LoupHC/controleur-CAPE/Images/Tiempoints_temp.png

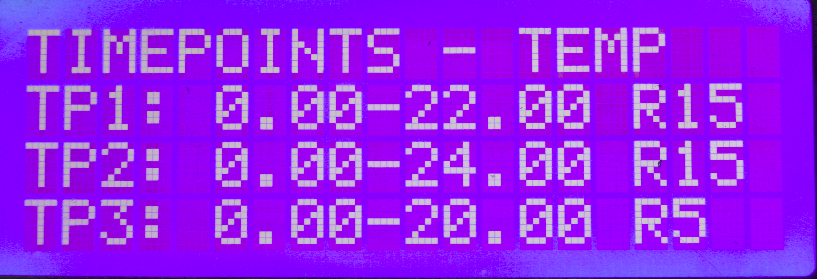
Images/Tiempoints_temp.png
