LoupHC/controleur-CAPE/Images/Enter_parameter1.png

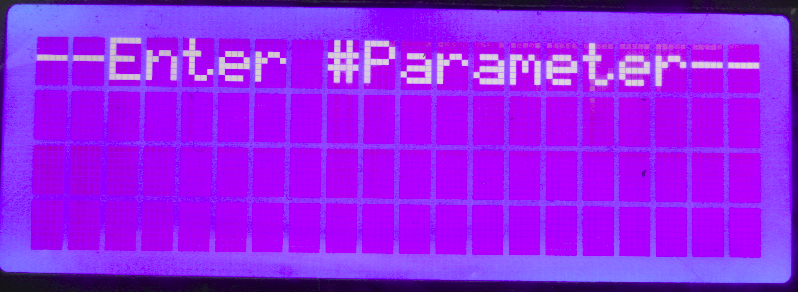
Images/Enter_parameter1.png
