LoupHC/controleur-CAPE/README.md

# l'Otomate
Voici l'**Otomate**, un outil développé par et pour les membres de la CAPÉ (Coopérative pour l'agriculture de proximité écologique) pour permettre aux petites, moyennes et grosses fermes d'automatiser leurs serres à une fraction du coût du marché.

Il dispose de fonctionalités permettant :
- de définir jusqu'à 5 périodes horaires permettant de faire évoluer la température normale au courant de la journée
- de contrôler l'ouverture et la fermeture de moteurs de côtés ouvrants, avec possibilité d'utiliser un programme distinct pour chaque côté de la serre
- d'actionner un ou deux systèmes de ventilation
- d'actionner une ou deux fournaises

Le programme supporte la sonde de température DS18B20 et le module d'horloge DS3231 pour le moment.

Le code, les schémas, les plans nécessaires à la conception de ce contrôleur sont du domaine public.Le code, les schémas et les plans nécessaires à la conception de ce contrôleur sont certifiés open-source, donc appartiennent au domaine public. Ils peuvent être utilisés, modifiés, hackés, par n'importe qui, pour n'importe quel usage, tant que les termes de la license GPL sont respectés.

Pour des détails quant  l'utilisation du présent code, consultez la section [wiki](https://github.com/LoupHC/controleur-CAPE/wiki).
