LoupHC/controleur-CAPE/Images/Enter_parameter.png

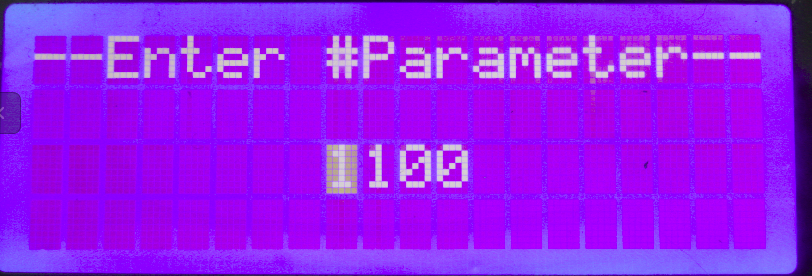
Images/Enter_parameter.png
