LoupHC/controleur-CAPE/Images/Fan.png

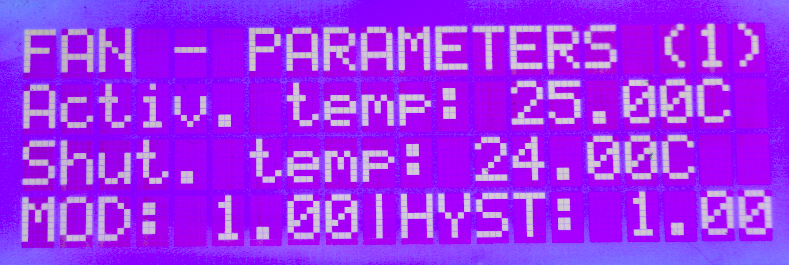
Images/Fan.png
