LoupHC/controleur-CAPE/Images/Global_parameters.png

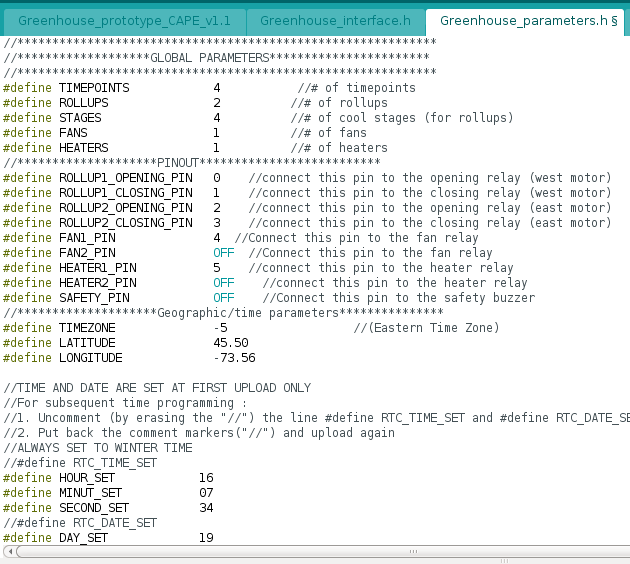
Images/Global_parameters.png
