LoupHC/controleur-CAPE/Images/Heater.png

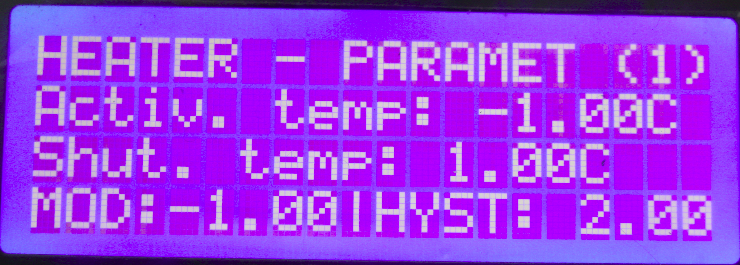
Images/Heater.png
