LoupHC/controleur-CAPE/Images/Home.png

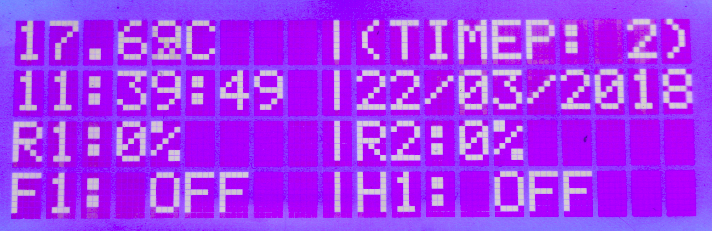
Images/Home.png
