LoupHC/controleur-CAPE/Images/Parameter_selected.png

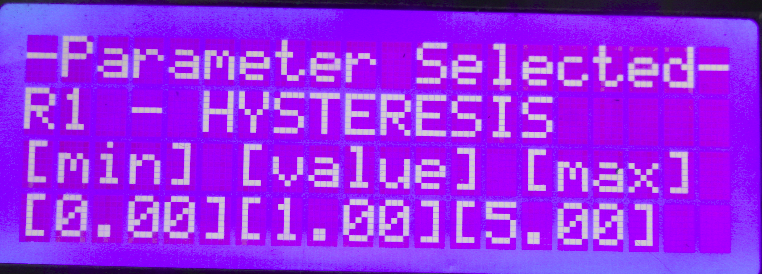
Images/Parameter_selected.png
