LoupHC/controleur-CAPE/Images/Programmation.png

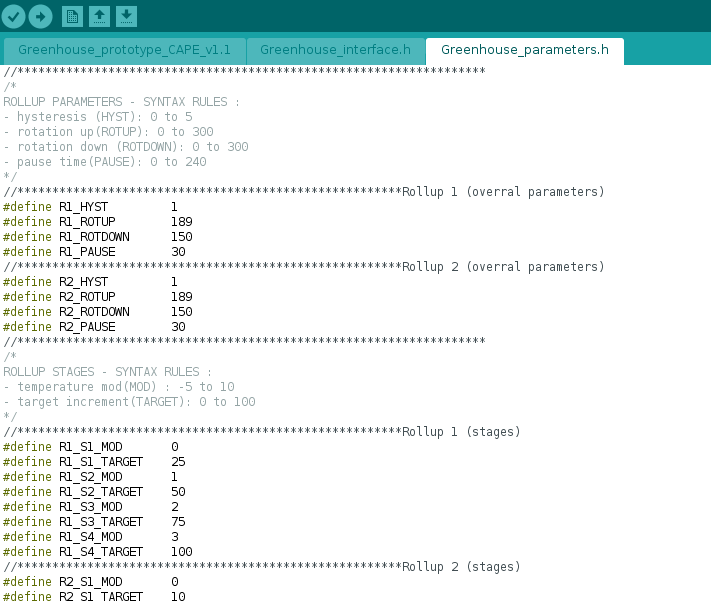
Images/Programmation.png
