LoupHC/controleur-CAPE/Images/Rollup_1.png

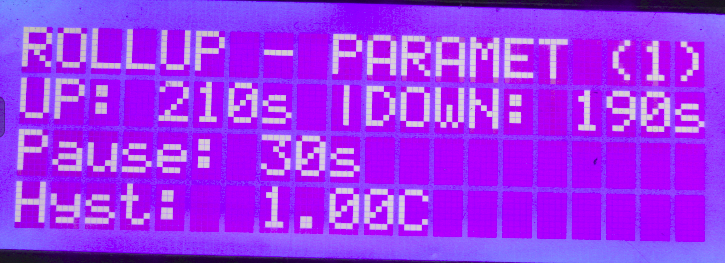
Images/Rollup_1.png
