LoupHC/controleur-CAPE/Images/Rollup_2.png

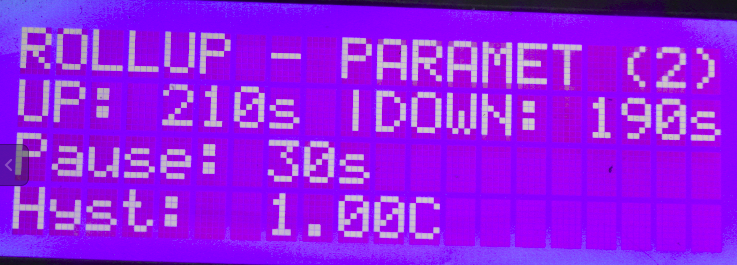
Images/Rollup_2.png
