LoupHC/controleur-CAPE/Images/Stages_1.png

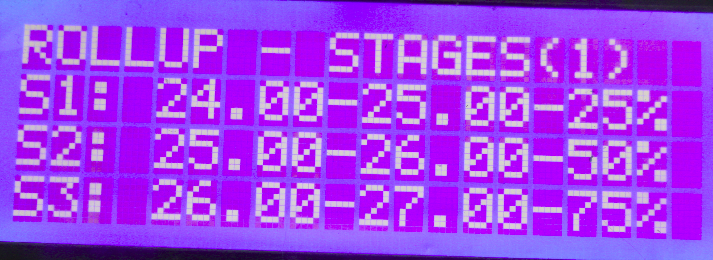
Images/Stages_1.png
