LoupHC/controleur-CAPE/Images/Stages_2.png

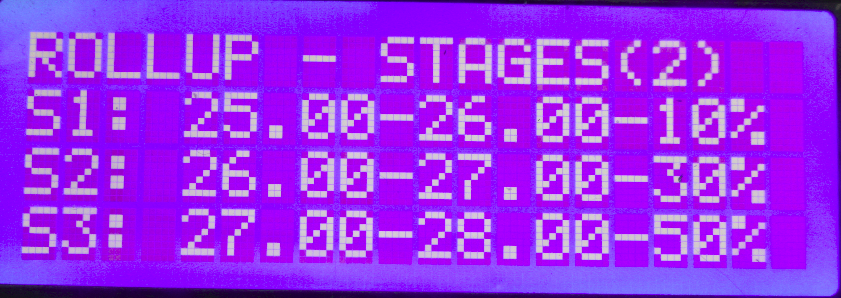
Images/Stages_2.png
