LoupHC/controleur-CAPE/Images/Timepoints_time.png

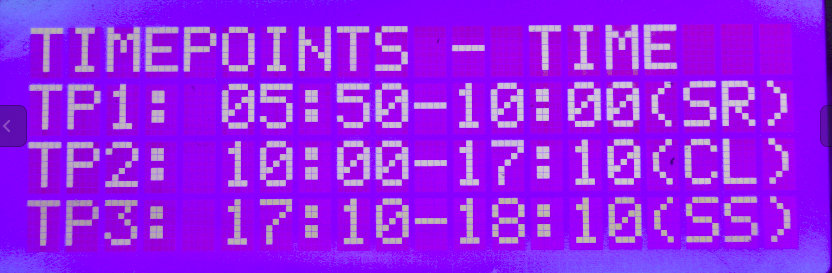
Images/Timepoints_time.png
