LoupHC/controleur-CAPE/KiCad Files/Controller_Schematics_pdf/Alimentation.png

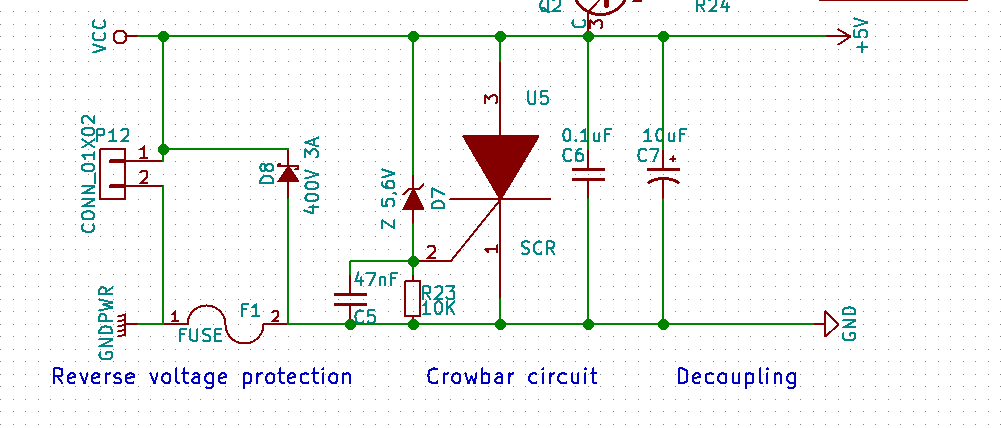
KiCad Files/Controller_Schematics_pdf/Alimentation.png
