LoupHC/controleur-CAPE/KiCad Files/Controller_Schematics_pdf/Relay driver.png

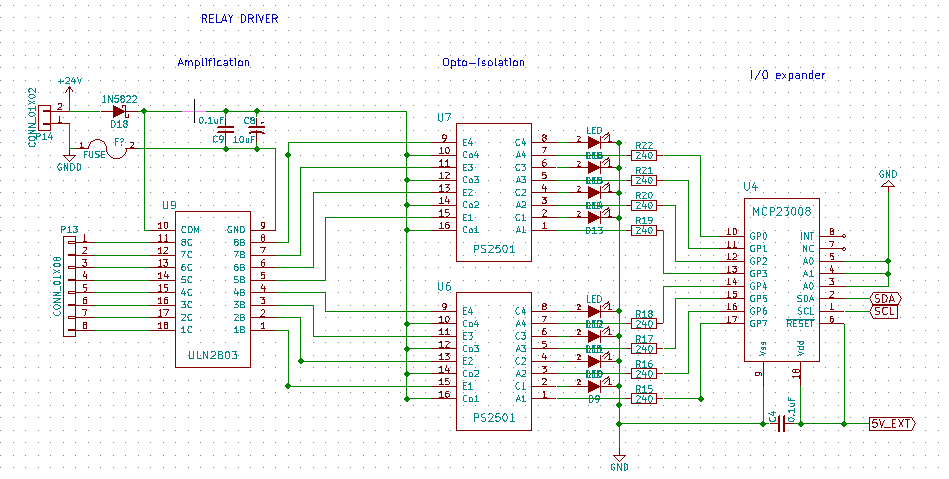
KiCad Files/Controller_Schematics_pdf/Relay driver.png
