LoupHC/controleur-CAPE/(threads)

Thread 3 (2018-01-05):

Quelle librairie de LiquidCrystal_I2C est utilisée?

palexp2, 2018-01-05:
J'ai essayé sans résultats avec les librairies suivantes:

https://github.com/jmparatte/jm_LiquidCrystal_I2C
https://github.com/marcoschwartz/LiquidCrystal_I2C
http://www.archiduino.com/liquidcrystal_i2c-h-library-arduino-ide-1-6-x/
https://github.com/fdebrabander/Arduino-LiquidCrystal-I2C-library

Copie du message d'erreur avec la librairie de archiduino:

```
In file included from /home/pa/Documents/controleur-CAPE/Greenhouse_prototype_CAPE_v1.1/Greenhouse_prototype_CAPE_v1.1.ino:114:0:
Greenhouse_interface.h:8: error: no matching function for call to 'LiquidCrystal_I2C::LiquidCrystal_I2C(int, int, int, int, int, int, int, int)'
 LiquidCrystal_I2C  lcd(I2C_ADDR, 2, 1, 0, 4, 5, 6, 7);
                                                     ^
sketch/Greenhouse_interface.h:8:53: note: candidates are:
In file included from sketch/Greenhouse_interface.h:2:0,
                 from /home/pa/Documents/controleur-CAPE/Greenhouse_prototype_CAPE_v1.1/Greenhouse_prototype_CAPE_v1.1.ino:114:
/home/pa/Arduino/libraries/LiquidCrystal_I2C/LiquidCrystal_I2C.h:58:3: note: LiquidCrystal_I2C::LiquidCrystal_I2C(uint8_t, uint8_t, uint8_t)
   LiquidCrystal_I2C(uint8_t lcd_Addr,uint8_t lcd_cols,uint8_t lcd_rows);
   ^
/home/pa/Arduino/libraries/LiquidCrystal_I2C/LiquidCrystal_I2C.h:58:3: note:   candidate expects 3 arguments, 8 provided
/home/pa/Arduino/libraries/LiquidCrystal_I2C/LiquidCrystal_I2C.h:56:7: note: constexpr LiquidCrystal_I2C::LiquidCrystal_I2C(const LiquidCrystal_I2C&)
 class LiquidCrystal_I2C : public Print {
       ^
/home/pa/Arduino/libraries/LiquidCrystal_I2C/LiquidCrystal_I2C.h:56:7: note:   candidate expects 1 argument, 8 provided
/home/pa/Arduino/libraries/LiquidCrystal_I2C/LiquidCrystal_I2C.h:56:7: note: constexpr LiquidCrystal_I2C::LiquidCrystal_I2C(LiquidCrystal_I2C&&)
/home/pa/Arduino/libraries/LiquidCrystal_I2C/LiquidCrystal_I2C.h:56:7: note:   candidate expects 1 argument, 8 provided
In file included from /home/pa/Documents/controleur-CAPE/Greenhouse_prototype_CAPE_v1.1/Greenhouse_prototype_CAPE_v1.1.ino:114:0:
sketch/Greenhouse_interface.h: In function 'void initLCD(byte, byte)':
Greenhouse_interface.h:30: error: 'class LiquidCrystal_I2C' has no member named 'setBacklightPin'
   lcd.setBacklightPin(BACKLIGHT_PIN, POSITIVE);
       ^
Greenhouse_interface.h:30: error: 'POSITIVE' was not declared in this scope
   lcd.setBacklightPin(BACKLIGHT_PIN, POSITIVE);
                                      ^
In file included from /home/pa/Documents/controleur-CAPE/Greenhouse_prototype_CAPE_v1.1/Greenhouse_prototype_CAPE_v1.1.ino:114:0:
sketch/Greenhouse_interface.h: In function 'void lcdPrintRollups(String, String, String, byte, byte, Rollup, byte*)':
sketch/Greenhouse_interface.h:61:31: warning: invalid conversion from 'const char*' to 'uint8_t {aka unsigned char}' [-fpermissive]
         lcd.write("          ");
                               ^
In file included from sketch/Greenhouse_interface.h:2:0,
                 from /home/pa/Documents/controleur-CAPE/Greenhouse_prototype_CAPE_v1.1/Greenhouse_prototype_CAPE_v1.1.ino:114:
/home/pa/Arduino/libraries/LiquidCrystal_I2C/LiquidCrystal_I2C.h:82:18: note: initializing argument 1 of 'virtual size_t LiquidCrystal_I2C::write(uint8_t)'
   virtual size_t write(uint8_t);
```

palexp2, 2018-01-05:
J'ai toruvé le lien dans le ReadMe dsl.

Closed 2018-01-05.

Thread 10 (2018-01-07):

Tester la chip MCP23008 pour actionner le driver de relais via I2C

LoupHC, 2018-01-07:
Permet de gérer 8 sorties via le canal I2C
Premiers tests effectués : jusqu'à maintenant ça marche!

LoupHC, 2018-01-12:
Prototype fonctionnel de relay driver : ça marche!

Closed 2018-01-12.

Thread 5 (2018-01-07):

Décision relais/alim contrôleur 12V ou 24V

LoupHC, 2018-01-07:
Système avec deux alimentations : une pour les moteurs (24V) et l'autre pour les relais et le contrôleur (12V)
Pour :
- On peut alimenter le Arduino directement via le régulateur de voltage intégré
- les relais 12V sont disponibles chez Addison et chez Abra

Contre :
- implique d'acheter 2 PS ou un module step-down 24V->12V
- questionnements sur les risques de surchauffe su régulateur de voltage

Système fonctionant exclusivement sur le 24V (B)
Pour :
- les relais 24V sont disponibles chez Abra
- Alimentation au Arduino via un buck converter comme celui-ci :
https://www.adafruit.com/product/1065
Meilleur efficacité de conversion, pas de leak current => éventuellement plus efficace sur batterie + chauffe pas

Contre :
- implique d'acheter un step-down pour le arduino

Closed 2018-01-08.

Thread 6 (2018-01-07):

Décision current sensor SM ou sur connecteur

LoupHC, 2018-01-07:
Pour le montage des sondes de courant, ça me gossait que la seule chip existante soit surface mount, mais j'ai trouvé dernièrement ce socket, qui pourrait supprimer le issue de comment remplacer un sensor brisé.
https://www.aliexpress.com/item/SOP16-TO-DIP16-SOP16-turn-DIP16-SOIC16-to-DIP16-IC-socket-Programmer-adapter-Socket-150mil/1107288077.html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,searchweb201602_5_10152_10151_10065_10130_10068_10344_10547_10342_10343_10340_10548_10341_10084_10083_10139_10307_10059_10314_10534_100031_10604_10103_10142,searchweb201603_25,ppcSwitch_5&algo_expid=7ae05777-db5d-442c-b6c0-5fc18b6fb81e-0&algo_pvid=7ae05777-db5d-442c-b6c0-5fc18b6fb81e&priceBeautifyAB=0
La chip s'enlève en appuyant sur les ressorts, comme ça :
https://www.youtube.com/watch?v=XixbJe8b-Qw
L'enjeu c'est qu'il y a aucun datasheet donc j'ai aucune idée des ratings de courant, mais surement que ça le fait pour 1A.
Aucune idée à quel point le contact est solide non plus...
Une autre possibilité c'est de mettre un limiteur de courant avec la chip, genre fusible réarmable, pour éviter de buster les ratings du capteur avec un faux contact.

jayserf, 2018-01-17:
J'ai vu passer le courriel, je l'ai tu repondu?

c'est vraiment pour la programmation et connection temporaire. Je le mettrais pas dans une installation permanente exterieur.
Je crois que perdre un chip et avoir a le dessouder surface mount pour le remplacer est moins une probleme que le socket peut avoir. (meme si les contacts sont en or)

deux questions:
1. est-ce que ca risque reelement de mourrir ce chip? (j'en ai aucune idee)
2. est-ce que si ca brule metons, le courant passe quand meme mais tu n'a juste pas le lecture de courant, ou le moteur sera mort?

LoupHC, 2018-01-17:
Bon, après relecture du datasheet, l'isolation du capteur peut handle jusqu'à 420V de tension DC/des spikes de 2400V, je pense pas que ça soit un risque trop trop.
L'autre risque c'est si le supply voltage excède 6V, avec le crowbar circuit ça devrait empêcher ça d'arriver.
Ok fuck les connecteurs à ressort. Je vais juste apprendre à souder du SM. :)

jayserf, 2018-01-18:
Cool! OK d'accord

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

Closed 2018-01-17.

Thread 8 (2018-01-07):

Décision Relais sur PCB ou rail DIN

LoupHC, 2018-01-07:
Assemblage sur Din rail(relais et contrôleur)
Pour :
- modulaire
- plus facilement hackable
- intérêt pédagogique à faire un peu soi-même son filage
Contre :
- plus de filage à faire à la main

Au niveau matériel, on pourrait utiliser ces racks-là pour les motor driver:
https://www.aliexpress.com/item/UM122-PCB-length-51-100mm-profile-panel-mounting-base-PCB-housing-PCB-din-rail-PCB-carrier/32622345793.html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,searchweb201602_5_10152_10151_10065_10130_10068_10344_10547_10342_10343_10340_10548_10341_10084_10083_10139_10307_10059_10314_10534_100031_10604_10103_10142,searchweb201603_25,ppcSwitch_5&algo_expid=6f677fa1-1931-41cc-8b40-aa9abdb1fa74-18&algo_pvid=6f677fa1-1931-41cc-8b40-aa9abdb1fa74&priceBeautifyAB=0
ou ceux-là, plus cheaps :
https://www.aliexpress.com/item/OOTDTY-PCB-35mm-DIN-Rail-Mounting-Adapter-Circuit-Board-Bracket-Holder-Carrier-Clips/32839808362.html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,searchweb201602_5_10152_10151_10065_10130_10068_10344_10547_10342_10343_10340_10548_10341_10084_10083_10139_10307_10059_10314_10534_100031_10604_10103_10142,searchweb201603_25,ppcSwitch_5&algo_expid=6f677fa1-1931-41cc-8b40-aa9abdb1fa74-1&algo_pvid=6f677fa1-1931-41cc-8b40-aa9abdb1fa74&priceBeautifyAB=0
On pourrait même monter le contrôleur dans un boitier comme ça :
https://www.okwenclosures.com/en/Railtec-B/B6506115.htm

Assemblage sur PCB (relais)
Pour :
- divise en 2 le filage
- choix de pièces illimité
Contre :
- pas autant modulable/hackable
- on est short dans le temps pour designer nos PCBs

yoangp, 2018-01-09:
Sur PCB avec supports DIN pour PCB: https://www.aliexpress.com/item/OOTDTY-PCB-35mm-DIN-Rail-Mounting-Adapter-Circuit-Board-Bracket-Holder-Carrier-Clips/32839808362.html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,searchweb201602_5_10152_10151_10065_10130_10068_10344_10547_10342_10343_10340_10548_10341_10084_10083_10139_10307_10059_10314_10534_100031_10604_10103_10142,searchweb201603_25,ppcSwitch_5&algo_expid=6f677fa1-1931-41cc-8b40-aa9abdb1fa74-1&algo_pvid=6f677fa1-1931-41cc-8b40-aa9abdb1fa74&priceBeautifyAB=0

Closed 2018-01-09.

Thread 9 (2018-01-07):

Tester la chip ULN2803 comme driver de relais

LoupHC, 2018-01-07:
Tester la chaleur dégagé par la Chip quand toutes les pins sont actives.
Les pins pour l'ouverture des moteurs doivent sinker 160mA (2 relais), la fermeture et les pins qui actionnent 1 seul relais doivent sinker 0,8mA.

LoupHC, 2018-01-12:
Fonctionne avec un relais

LoupHC, 2018-01-28:
Compte-rendu de notre setup proto-expérimental :

- 2 drivers de moteurs et 6 relais connectés.
- Allumage successif des 8 sorties
- 1,2,3,4 et....... POUFFFFF
Magic smoke!!!
Avec un beau crack et le casing en epoxy bien fendu en 2.

Causes possibles :
- Trop haut voltage en input (le datasheet est pas clair à ce sujet) (on discart la chip ou on ajoute des résistances en input)
- Court circuit des relais à cause d'une diode mise à l'envers (on garde la chip, et on fait nos branchements comme du monde)

J'ai commandé 5 chips, je prévois en faire brûler au moins 4 pour en avoir le coeur net.

LoupHC, 2018-02-10:
Mystère non résolu... possiblement une inversion de polarité.
Dans tous les cas, on choisi plutôt UL2075B.

Closed 2018-02-10.

Thread 14 (2018-01-08):

Ajouter copyright et frame Creative Commons BY-SA au schematics du relay driver

LoupHC, 2018-01-08:

yoangp, 2018-01-09:
Autre chose à rajouter? J'upload la cette version des fichiers KiCad à l'instant.

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

LoupHC, 2018-01-09:
C'est cute au boute!
Pour les schematics, est-ce que c'est possible d'avoir un frame comme ça (avec la mention de licence)?
[Weather Shield_V12.pdf](https://github.com/LoupHC/controleur-CAPE/files/1615730/Weather.Shield_V12.pdf)

LoupHC, 2018-02-25:
Salut Yoan!
J'ai fait des logos CAPÉ et creative commons pour ajouter sur nos pcbs, je peux également les ajouter sur le pcb relais.

yoangp, 2018-02-27:
Salut Loup,

Gêne toi pas si tu veux ajouter cela sur le PCB des relais! :-)

Yoan

2018-02-25 10:16 UTC−05:00, LoupHC <notifications@github.com>:
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

Closed 2018-03-23.

Thread 15 (2018-01-08):

Décaller les trous d'adapteurs DIN du relay driver légèrement vers la droite

LoupHC, 2018-01-08:

yoangp, 2018-01-09:
J'ai du refaire le pcb pour corriger mon problème de routage. Pour l'instant les pièces sont placés approxiativement dans le fichier .kicad_pcb.
Est-ce que tu veux juste dire d'alligner les trous pour que tout soit centré ou tu veux que les trous soient plus à droite pour laisser plus d'espace dans le boitier?

yoangp, 2018-01-09:
J'ai regardé les dimensions des sockets de relai DIN, ils font 78mm de long selon la datasheet que j'ai trouvé. Pour rester à peu prêt dans la même largeur, est-ce qu'il serait préférable de tourner les circuits de drivers de 90 degrés en gardant les mêmes dimensions de 70mm x 100mm? Je n'aurais qu'a repositionner les pièces du PCB avec cette nouvelle orientation.

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

LoupHC, 2018-01-09:
Ouen pas très clair mon affaire désolé... Je voulais surtout dire décaler le PCB vers le centre pour dégager de l'espace entre la paroi du boitier et les terminaux à vis.
Effectivement on peut aussi faire comme ça! Par contre si c'est possible  j'orienterais les terminaux à vis paralèlement aux connecteurs pour diminuer le stress sur les câbles.

LoupHC, 2018-01-09:
Par rapport aux sockets, j'ai trouvé la mention suivante sur Aliexpress :
"Note:
Please allow 1-3mm error due to manual measurement. pls make sure you do not mind before you bid."
À considérer peut-être pour la dimension des trous.

yoangp, 2018-01-16:
1. J'ai repensé la surface du PCB de driver de relai, 8cm x 8cm semble être plus intéressant. Les sockets de relai DIN rail font 7,8cm de large donc on garde senseiblement la même largeur tout en prenant un peut moins de place en longueur sur la rail. Avec des pièces de même largeur sur la rail on va très probablement pouvoir faire un montage plus compact dans la boîte.

2. Pour les connecteurs pluggables, j'aimerais utiliser une version avec les fils qui partent vers le haut (exemple: https://www.digikey.ca/product-detail/en/phoenix-contact/1755736/277-1150-ND/260518). Je pense que cela va permettre de libérer un peut de surface dans la boîte et éviter de stresser les fils. Voici un dessin pour mieux comprendre:
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

3. Pour l'erreur possible sur les trous du support pour DIN rail, on peux faire des trous un peu plus gros. J'ai aussi trouvé une pièce équivalenete sur Digikey et les dimensions étaient bien 25mm centre à centre.

Qu'est ce que vous en pensez?

LoupHC, 2018-01-16:
J'aime bien ça arrangé de même!
Et bon point pour les connecteurs, notez qu'on a non seulement le choix de l'orientation du connecteur mâle soudé, mais aussi du connecteur femelle!

Thread 16 (2018-01-08):

Doublon dans CAPE_Relay_Shield_V2.zip

LoupHC, 2018-01-08:
Deux fichiers .pro?

yoangp, 2018-01-09:
Je vois qu'un seul fichier .pro dans le fichié zippé...

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

LoupHC, 2018-01-09:
Heh... ouen efectivement... il s'est juste passé quelque chose dans celui que j'ai downloadé alors...

Closed 2018-01-09.

Thread 17 (2018-01-08):

Soumission PCB motor driver

LoupHC, 2018-01-08:

yoangp, 2018-01-09:
-Est-ce qu'on y va pour PCBWAY?
-Jason, est-ce que tu peux voir si le fournisseur offre que les trous dans le PCB seront plaqués?
-Est-ce que tu peux aussi écrire ici quel grosseur de mèches il est possible d'utiliser pour les trous dans le PCB?

jayserf, 2018-01-17:
-PCB way ou un tres similaire, je vais comparer 2-3
- Normalement oui. Plated Through Hole (PTH) est standard
-voici les specs complets
https://www.goldphoenixpcb.com/html/capabilities/rpc.html

https://www.pcbway.com/capabilities.html

Closed 2018-01-29.

Thread 18 (2018-01-09):

Choisir le fournisseur de PCB pour les PCB prototypes

yoangp, 2018-01-09:
-Est-ce qu'on y va pour PCBWAY?
-Est-ce que tu peux aussi voir si le fournisseur offre que les trous dans le PCB seront plaqués?
-Est-ce que tu peux aussi écrire ici quels grosseurs de mèche il est possible d'utiliser pour les trous dans le PCB?

yoangp, 2018-01-09:
Redondant avec l'issue de Loup que j'avais pas vu!

Closed 2018-01-09.

Thread 19 (2018-01-09):

Partie relais avec ou sans PCB?

yoangp, 2018-01-09:
J'ai mis à jour le BOM pour la partie relai en 2 sections, une sans PCB l'autre avec PCB (voir feuille "Budjet détaill - boite relais pas étanche" dans https://docs.google.com/spreadsheets/d/1WUM-zMhos570SmZMH1RuJZH5EpLDn4kmKrJe-_xwwi0/edit#gid=1792563555)

En gros, le PCB fait monter le coût vraiment beaucoup. Je n'ai pas optimisé tous les coûts, mais ça semble tourner autour de 4000$ sans PCB (200$ par boîte) et 5500$ avec PCB (275$ par boîte). Ça me semble un gros défi de trouver une façon de garder les coût autour de 200$ par boîte avec un PCB.

Je trouverais ça plate de laisser tomber ce PCB, mais c'est pas si grave que cela non plus s'il faut rester avec la version 100% pièces sur DIN rail.

yoangp, 2018-01-09:
Après révision de mon erreur de coût de fabrication de PCB, j'ai recalculé le coût dans le budget et ça fait du sens avec PCB. Je suis à 205$ par boîte pour l'instant et surement encore capable de descendre un peu ce coût. Donc on reste avec l'option PCB.

LoupHC, 2018-01-09:
Nice!
Si ça te va je vais updater tes chiffres dans cette version du BOM :
https://docs.google.com/spreadsheets/d/1U0wZ03mb_SrtCEw6ppra8F-SvSYpekVIvqOV3GDfxJs/edit#gid=0
C'est la plus à jour pour le contrôleur et ça va impliquer quelques modifications à peine pour le boitier relais. I'm on it!

Loup

yoangp, 2018-01-09:
Pas de trouble, tu peux bouger mes chiffres dans ce nouveau BOM, c'est lui que je vais utiliser aussi à partir de maintenant.

Closed 2018-01-09.

Thread 20 (2018-01-09):

Alimentation dans ou hors de la boîte?

yoangp, 2018-01-09:
Si on met l'alimentation 24V et 5V hors de la boîte on peut avoir une plus petite boîte. Est-ce que ça vaut la peine pour réduire les coûts. J'aime bien l'idée de Jason d'acheter un power supply 24V fermé, et de faire entrer dans la boîte juste du 24V. C'est plus safe que jouer avec des fils 120V et il me semble que Jason disait qu'il y a aussi des problèmes de règlemenation lorsque qu'il y a des branchements 120V.

LoupHC, 2018-01-09:
Ouen, l'intérêt de faire rentrer le 120V dans la boîte c'était de pouvoir éventuellement actionner des contacteurs avec les deux relais de spare. Je pense que le issue s'appliquait surtout aux assurances mais maintenant on sait que les serres sont jamais assurées...
Ça fait aussi moins de filage à gérer à l'extérieur de la boîte je trouve. Un seul cable à pluger dans le 120V merci bonsoir.
Au niveau de la boîte, je vais essayer d'évaluer les économies possibles sachant que sans les PS on a quand même besoin au minimum d'une boite 30cmx30cm.

jayserf, 2018-01-17:
OK decision =

**AC/DC 24V 6A Waterproof externe**
https://www.trcelectronics.com/View/Mean-Well/CLG-150-24A.shtml

**https://www.trcelectronics.com/View/Mean-Well/ELG-150-24.shtml**
(je ne sais pas pourquoi lui est quand meme moitie prix... wtf is classified location use?)

https://www.trcelectronics.com/View/Mean-Well/HLG-150H-24.shtml

**AC/DC 5V 1A din rail (ou non) interne:**

din rail (meanwell real model)

Non Din model (half price, IP44 = water spray from any direction, vs no rating against humidity for din model)

**https://www.trcelectronics.com/View/Mean-Well/APV-16-5.shtml**

J'ai personellement (au travail) utiliser les APV et les HLG/CLG dans nos equipments et ils ne semblent pas lacher souvent, si jamais

Closed 2018-01-18.

Thread 21 (2018-01-11):

Faire schematics du contrôleur (alimentation)

LoupHC, 2018-01-11:
On s'était dit qu'on voulait skipper le voltage regulator intégré vu qu'il chauffe, est peu efficace énergétiquement, et peu fiable selon certains témoignages.

J'ai fait des recherches concernant l'alimentation du arduino via la pin 5V, je me rend compte qu'il y a au moins un enjeux : on fait tomber une certaine protection contre les survoltage. Selon les specs de la chip atmega2560, son operating voltage est compris entre 2,8-5,5v, et elle tolère des peaks jusqu'à 6v. En haut de ça on l'endommage.

J'ai fait le tour de pas mal d'options hier, voici le mieux auquel j'arrive à penser :
**Protection contre le sur-voltage (crowbar circuit, j'aimer vraiment le nom) :**
- le principe : en haut d'un certain voltage, le circuit s'auto-shortcut et fait sauter une fuse.
https://en.wikipedia.org/wiki/Crowbar_(circuit)

C'est simple de chez simple! Sauf que... si on set le circuit pour s'activer à 5,6V mettons, ça risque de clamper tout le temps vu que l'écart entre notre load voltage et cutoff voltage est de 0.6V, et on est pas plus avancé si on doit changer la fuse tout le temps.
Alors... c'est pas une si bonne solution sauf...

**Régulateur de voltage (LM2576-5):**
...si on intègre le circuit de protection avant un autre régulateur de voltage, plus efficace et moins tous les défauts de celui du arduino.  J'ai sélectionné le LM2576-5 parcequ'il nécessite pas trop de pièces externe, et permet d'alimenter le arduino entre 7-24V, avec un maximum input de 40V. C'est un régulateur à découpage, donc normalement ça chauffe pas, et c'est plus efficace (80ish% de conversion).
https://hackaday.com/2016/06/04/how-does-a-buck-converter-work-anyway/

Là dessus on peut intégrer un crow bar circuit à l'entrée du régulateur pour le protéger des grosses sur-tensions, ex, contact accidentel avec le 120VAC, et un après juste pour être sûr si, exemple, une goutte d'eau vient toucher le VIN et le VOUT.

Ça ressemblerait donc à ça :
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

LoupHC, 2018-01-11:
Vous en pensez quoi?

LoupHC, 2018-01-11:
Parenthèse, le transistor en bas à droite, c'est pour éteindre manuellement les pull-ups et l'alimentation des sondes. Ça sera (peut-être) éventuellement utile si on adapte (un jour) le contrôleur pour fonctionner sur batteries.

yoangp, 2018-01-16:
Mon conseil Loup serait d'utiliser plutôt un régulateur 5V déjà tout fait. Je ne sais pas si tu as commencé la partie pcb, mais c'est pas de la petite bière. Il y a un tout un paquet d'affaires à vérifier et le moins que tu en as à faire, le mieux ça sera. Je sais que tu es super méga motivé et c'est très cool!! Mais tu va te sauver bien du travail et des tracas dans les prochains mois si tu n'as pas à t'occuper de cette partie du circuit. Dans tous les projets que j'ai fait jusqu'à maintenant en tant qu'ingénieur, ce qui est récurant c'est de ne pas avoir assez de temps pour compléter le projet à la date prévue. Malgré tout, je respecterai évidemment ton choix si tu veux quand même un circuit de régulation 5V sur le pcb du contrôleur :-)

LoupHC, 2018-01-16:
Ça a du sens... bon même si j'ai eu vraiment beaucoup de fun à monter ce circuit hahah... Je vais y aller au plus simple, et éventuellement, quand on aura tout terminé parfaitement dans les temps et même quelques jours d'avance, je verrai si je m'avance.
N'empêche, régulateur ou pas, qu'est-ce que tu penses d'intégrer un crowbar circuit? Ça serait poche de buster notre contrôleur parceque la foudre tombe pas loin de la serre (bon j'ai aucune idée si je dis n'importe quoi en ce moment).

LoupHC, 2018-01-25:
Je voulais juste avoir votre avis sur le circuit final :
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
Protection :
- En cas de survoltage (5,6V et +), la diode zener actionne le SCR et short le circuit, ce qui fait sauter la fuse. (Je l'ai testé à 12V, ça marche super bien!) Théoriquement le SCR peut tolérer 200V et 4A, et avec le fusible ça dure vraiment juste une fraction de seconde.
- En cas d'inversion de polarité, la diode 8 devient conductrice et short le circuit, ce qui fait sauter la fuse. Le rating de la diode est 3A, vs la fuse qui est 1.5A (la même que les moteurs!)
- Avec une limite de 1,5A, on peut penser à toutes les sondes qu'on pourrait vouloir ajouter, on se rendra jamais là je pense. Si on short une sonde, encore là, ça fait sauter la fuse.

Ce que je me demande : est-ce qu'un circuit comme ça peut supporter si on plug le 120v par accident dans le contrôleur (shit happen)? Est-ce que vous voyez d'autres sources de problème?

LoupHC, 2018-01-25:
Tant qu'à faire, voici les protections que j'ai mis pour l'alimentation des relais :
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

- En cas d'inversion de polarité : la diode schotky empêche le courant de circuler, faible drop de voltage, donc peu de chaleur dégagé, max 30v par contre.
- Fuses réamorçables pour chaque sortie de relais, au cas où quelque'un connecte le 24V direct sans passer par les relais. Après 500mA ça trip et empêche le courant de passer, à part un peu de leak acceptable par les transistors.

Ce que je me demande : j'ai pas de protection contre les survoltages, est-ce que je devrais, est-ce qu'il y a une manière facile de le faire? Surtout si ça partage la même alim que les moteurs. Je trouvais ça overkill d'inclure une autre fuse et un autre crowbar circuit, est-ce que j'ai raison?

LoupHC, 2018-01-28:
Finalement, sur driver de relais on a décidé de remplacer les fuses/canal individuelles par une seule fuse sur le common ground. Comme ça, si ya un court circuit quelque part, tout arrête et l'alarme part!

LoupHC, 2018-01-28:
Et tant qu'à ajouter une fuse, j'ajouterais une zener/varistor pour protéger les transistors contre les surtensions.

LoupHC, 2018-02-04:
Guys! Je reviens de ma révision de circuit. Le résultat est malade!
A fuckin' rugged circuit!
Pour l'alimentation 5v, j'ai remplacé complètement le crowbar circuit par un low-drop voltage regulator, lequel est protégé dans ses trippes contre les courts-circuits, les spikes de voltages et la surchauffe. Pour protéger plus complètement j'ai mis une varistance en amont pour éviter de toaster le régulateur avec des vraiment hauts voltages (même s'il peut prendre jusqu'à 35v). Ça permet en bonus d'alimenter le contrôleur avec n'importe quoi entre 5v et 18v... pas pire!
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

LoupHC, 2018-02-04:
Pour l'alimentation 24V, j'ai changé les transistors par d'autres vraiment beefs (60V input, 80v output, 1,5 AMPÈRE par sortie!). Ça rajoute des pièces mais là on est carrément indestructible. On calculait même qu'on pourrait contrôler un moteur direct sur le contrôleur.
Comme on utilise pas tant d'ampérage pour les relais, on s'est dit qu'on mettrait une fuse 1.5A sur le common ground comme ça si une entrée saute, tout arrête et ça fait partir l'alarme, sans abîmer les transistors.
Là aussi, varistor et diode pour protéger des spikes de tension du moteur, même si à 80v de tolérance on est vraiment safe. Ça protège aussi contre le 110VAC.
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

LoupHC, 2018-02-04:
Ah oui et il pourrait nous prêter un oscilloscope et un bench PS pour nos tests. :)

jayserf, 2018-02-06:
moi aussi je peut en preter du travail

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

LoupHC, 2018-02-06:
Dernière implémentation :
- ajout d'un power resistor de 20-40 Ohm/15W sur le ground commun des transistors.
Comme ça en cas de short des relais, le courant est limité à (roughly) :
24/20  = 1,2A max (tolère spikes jusqu'à 34V)
24/40 = 0,6A max (tolère spikes jusqu'à 68V)
Et on a juste à mettre une fuse 0.5-1A en série pour éviter que ça chauffe longtemps.
En attente des pcbs pour tester ça!!!
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

yoangp, 2018-02-06:
Parfait, ça va aider pour les tests c'est certain!

Yoan

2018-02-06 12:30 UTC−05:00, jayserf <notifications@github.com>:
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

LoupHC, 2018-02-25:
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

Closed 2018-02-25.

Thread 22 (2018-01-12):

Faire schematics du contrôleur sur KiCad

LoupHC, 2018-01-12:

LoupHC, 2018-01-12:
Je crois que j'ai réussi à tout mettre ensemble pour le schematic du contrôleur! Jettez un oeil :
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

LoupHC, 2018-01-14:
Version updatée :
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

yoangp, 2018-01-16:
Cool! Méchante grosse job!
-Tu a changé la PIN COM du ULN2803 du GND au +24V ? Je suis à peut près certain que ça ne marchera pas. Il faut qu'on rediscute de cette chip de toute façon, car après réflexion je vois plusieurs problèmes.
1. Toutes les sorties du ULN2803 sont connectées ensembles sur la pin COM, il n'est donc pas possible d'interrompre le lien du COM avec une switch pour passer en mode manuel car plus rien ne va fonctionner (fan, chauffage, etc.). De plus, avec 2 module de contrôle des côtés, il ne sera pas possible d'être en mode manuel juste d'un côté car la switch manuel-automatique du deusième module va continuer de maintenir un lien sur la pin COM. Il y a donc 2 options à première vue: Modifier le circuit du driver de relai ou modifier le circuit du contrôleur.

*Option modification du circuit du driver de relai*
La PIN COM de l'ULN2803 reste toujours connectée au GND. En mode manuel, la switch doit couper le signal OPEN et le signal CLOSE. Ceci est possible avec une switch 2P4T (2 pôles, 4 positions) 1 pôle pour OPEN, un pôle pour CLOSE, et 4 positions: OPEN-CLOSE-OFF-AUTO. Mais c'est difficile de trouver une switch comme cela. Il n'y a pas mille modèles comme une simple switch 1 pôle 3 positions. L'autre problème c'est que ce n'est pas compatible avec le design de la boîte de 2016. Mais de toute façon, on ne peut pas rendre notre montage compatible au montage de 2016 (le signal de contrôle est +12V). Le montage de 2016 fonctionne juste sur une sortie de mini-relai (comme à peu prêt 100% des contrôleurs de serre). Je me dit qu'il n'y aura probablement pas trop de monde qui veulent le contrôleur Arduino avec la boîte de relai de 2016. Et s'il y a quelqu'un avec ce problème, eh bien nous ferons quelques modifs à sa boîte relai 2016 pour la rendre compatible.

*Option modif du circuit du contrôleur*
Il faudrait rempacer le ULN2803 par des transistors Darlington NPN individuels. Ainsi chacune des 8 sorties sera 100% indépendante. Cela rend aussi le contrôleur plus facilement compatible avec d'autres boîtes de relai existantes (commerciales et celles de 2016).  Je pense que cette solution est plus souhaitable car elle est plus universelle.

Bon, je sais pas si c'était tout clair.. On s'en reparle au téléphone.

LoupHC, 2018-01-16:
En fait, sur le pinout de ULN2803, GND correspond au ground commun de tous les transistors, et COM connecte à un circuit de flyback diodes, qui doit être connecté à une tension pour protéger les transistors. J'ai fait quelques tests sur un prototype soudé chez nous et connecter COM au ground faisait que toutes les sorties étaient actives tout le temps.

Pour bypasser le circuit de transistors, est-ce qu'on pourrait faire quelque chose comme ça tu penses?
On aurait besoin d'une switch DPDT et d'une switch SP3T on-off-on par côté ouvrant.
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

LoupHC, 2018-01-16:
Le boutte qui indique comment brancher la chip :
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

jayserf, 2018-01-17:
WOW!

Je pensais pas que tu etais si avance! On est plus proche au proto finale
en gros:

- [ ] Finalise le BOM
- [ ] Change les pieces et finalise le schematique
- [ ] bouge tout a la bonne place
- [ ] change les footprints et trous et tailles de peices comme Yoan fait

Pour vrai, dependant du niveau d'apprentissage et de fierte de le faire sans aide tu veut avoir, j'en ai plusieurs amiss/collegues qui seront interesses a nous aider. Ca demeure une option pour accelerer.

Peut importe (si vous sont d'accords) je montrerais le pcb fini a un de ces gars pour un check d'erreurs de traces de debutant. (Peer review / fresh point of view) (peut nous sauver une revision de pcb!)

LoupHC, 2018-01-17:
Vu qu'on a commencé avec Kicad, est-ce que ça pose problème pour tes chummys? Est-ce que ça limite le niveau d'aide qu'ils pourraient nous apporter (exemple, retouches directement sur le fichier Kicad vs commentaires à l'oral)?
Dans tous les cas, c'est CLAIR que je suis down pour une révision!

yoangp, 2018-01-17:
Même chose pour moi Jason, c'est super si tes collègues peuvent faire une révision des fichiers kicad et du prototype de PCB du driver de relai.

jayserf, 2018-01-30:
Hey Guys,

J'ai faite une revision aujourd'hui avec un collegue au travail.

1. En gros, majeure commentaire: faut ajouter une colonne "PCB REFERENCE" dans les 2 boms pour mettre sur chaque ligne tous les places sur le PCB ou la piece se trouve.
ex: 10ohm resistor, R3,R7,R10,R11,R12 | 1uf Cap, C2,C7,C8

comme ca n'importe qui qui assemble (ici ou en chine) est capable de bien faire correspondre les pieces du BOM avec sa place sur le PCB. (J'ai carrement oublie ce detail)

2. Il parait que les schematiques sur GutHub ne correspondent pas avec les Gerbers exportes que je l'ai montrer. Est-ce que c'est possible de remettre les plus recents et si oui est-ce qu'ils sont a jour avec le pcb (autogeneres par kikad) ou sont fait manuellement alors pas a jour encore car c'est long?

Alors sans les schematiques correspondants on a arrete le review apres 45 mins.

Sinon pas de flags majeures a premiere regard surtout si le Motor Driver est teste et confirme deja. Mais avec des schematiques a jour ca sera pas long a faire le tour complet du controlleur (et n'importe quelle questionnement plus technique je vais vous demander)

Closed 2018-02-06.

Thread 24 (2018-01-14):

Faire routing du contrôleur sur KiCad

LoupHC, 2018-01-14:
Ça y est, on rendu là, faire le ménage de tout ce beau bordel :

LoupHC, 2018-01-14:
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

LoupHC, 2018-01-22:
Ça commence à ressembler à qqchose!
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

jayserf, 2018-01-22:
Fuck yeah! En 3d en plus 🚀

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

LoupHC, 2018-01-23:
Yeah, encore plus maintenant!!
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

yoangp, 2018-01-24:
Coooooooooool!!! :-)

LoupHC, 2018-01-24:
Guys! I made it!!!!!!!
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

yoangp, 2018-01-24:
Woooowwww! T'as même mis un ground plane! C'est la classe! ;-) Je vais essayer de jetter un coup d'oeil plus approfondi un peu plus tard. Quand prévoies-tu d'envoyer la commande de pcb?

En passant, quand j'ai fait ma commande de pcb, j'ai choisi revètement blanc avec texte noir et pas de plomb dans le revètement. C'était plus cher de prendre sans plomb, mais sans plomb blanc était moins cher que sans plomb vert (!?).

LoupHC, 2018-01-24:
Je vais réviser 2-3 trucs avant de l'envoyer, réviser toutes les footprints et les largeurs de traces.
Est-ce que Jason tu pourras montrer ça à tes chummys pour avoir leurs commentaires? J'update le fichier Kicad à jour live.
Je pourrais envoyer ça peut-être d'ici le début de la semaine prochaine? Vendredi si je suis efficace.
Hey pis sont swell en tah les pcb que t'as monté!!!

LoupHC, 2018-01-26:
Et juste au moment ou je pensais avoir fini.... noooo! J'ai utilisé des connecteur 3.5mm au lieu de 5mm.
Ça va être un peu plus long que prévu. :P

yoangp, 2018-01-26:
5.08mm ... ;-)

Moi aussi j'ai fait quelques erreurs comme cela.

Ciao, je te répond aux autres messages ce soir si tout va bien.
Vraiment cool que notre objectif d'inscription soit atteint!

Ciao!

Yoan

2018-01-26 14:35 UTC−05:00, LoupHC <notifications@github.com>:
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

LoupHC, 2018-01-27:
Et pour finir en beauté, je me suis permis une petite coqueterie :
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

yoangp, 2018-01-27:
C'est trop cute! :)

2018-01-26 22:17 UTC−05:00, LoupHC <notifications@github.com>:
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

jayserf, 2018-01-28:
Super nice!
Really like the drawing but that's secondary to the routing!
I'll try to get feedback on Monday so we can send it super quickly

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

jayserf, 2018-01-30:
Ignore comments re: SPI connector in other issue. this is good.
OK now is much clearer to see the board with the real markings and connectors.

J'imagine c'est bon au niveau trous de montage?

LoupHC, 2018-02-06:
Version finale (on attend les prototypes!) :
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

LoupHC, 2018-02-25:
Version finale (après révision) :
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

Closed 2018-02-06.

Thread 26 (2018-01-17):

Preparer doc pour soumission de PCBA

jayserf, 2018-01-17:
Needed info

- Quantities: high & low estimate for **protos** and for **production** orders
(can put in fab info text file)
- Estimated PCB size (LxW in mm) (can put in fab info text file)
- Boms (one file for each PCB)
        - specify # of TH & SMD parts in each bom
- Fab info:  (see below example from Eagle production pcb) (if you dont know some info its ok, the minimum info needed is the top section)

fabrication_parameters.txt
-------------------------
* 2 layers FR4
* Finish board thickness 0.7874mm(0.031")
* TOP and BOTTOM copper thickness (1.0oz)
* White solder mask on both side
* Black silkscreen on both side
* HASL finish
* tolerance on drills (3mils)
* minimal drill size (12mils)
* minimal isolation (5mils)
* minimal trace width (5mils)
* PTH vias
* Manufacturer code accepted on PCB
* Tab-Routed panel

CAD Package
-----------
CadSoft EAGLE 5.12 Professionnal

Gerber files format
-------------------------------------------------
* RS-274X format (Embedded D-Codes)
* 2.4 digits english
* All files are gerber-X format, except drills (.DRILL)
* origin at 0,0

Excellon files format (*.DRILL)
------------------------------------
* Excellon format (Embedded Drill Rack)
* Dimensions 2.4 digits OMIT LEADING ZEROS

included files
---------------
*.DRILL : 	drill file
*.GTL : 	copper layer TOP
*.GBL :  	copper layer BOTTOM
*.GTO : 	silkscreen layer TOP
*.GBO :		silkscreen layer BOTTOM
*.GTS : 	soldermask layer TOP
*.GBS :		soldermask layer BOTTOM
*.GTP :		stencil layer TOP
*.OUT :		board outline layer
*.GD1 :		drill symbol layer
*.MOUNT :	pick and place coordinates
*.png	:	extra pcbs information

LoupHC, 2018-01-18:
BOM controller components complet!
https://docs.google.com/spreadsheets/d/1U0wZ03mb_SrtCEw6ppra8F-SvSYpekVIvqOV3GDfxJs/edit#gid=0

LoupHC, 2018-01-18:
J'ai ajouté des détails sur celui des motor drivers aussi.

jayserf, 2018-01-18:
NIce!

Let me know if you need help with any of the fab stuff

jayserf, 2018-01-22:
Oui bien sûr je peut envoyer la soumission cet semaine.
Pas aujourd'hui car c'est ma fête mais demain for sure

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

yoangp, 2018-01-23:
Bonne fête Jason!!

:-)

Yoan

2018-01-22 15:19 UTC−05:00, jayserf <notifications@github.com>:
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

LoupHC, 2018-01-23:
Bonne fêteee!!!!!!

jayserf, 2018-01-26:
thanks guys! I had a good one.

Quotes sent to PCBWay and More-Suns. We'll see what they return and I have some that I know well but definitely charge setup fees so dont want to msg them if we will for sure not use them as they dont specialize in lower volume, but would do a flawless job.

Closed 2018-01-29.

Thread 27 (2018-01-18):

SPI channel  : logic level shifter??

LoupHC, 2018-01-18:
En lisant sur internet, je me rend compte qu'on peut pas directement plugger les pins de communications à n'importe quelle chip, particulièrement les chips 3.3v (le module LoRa ou ESP8266 nottament). Pour ces modules là, on doit utiliser un Logic Level shifter, qui ajuste le voltage d'un module à l'autre. Détails ici :
https://learn.sparkfun.com/tutorials/bi-directional-logic-level-converter-hookup-guide
Certains modules tolèrent les signaux de 5v (comme la nrf24 que Jason utilise) mais dans tous les cas, c'est préférable.

On pourrait se dire qu'on connecte le LLS à l'extérieur du contrôleur, mais ça impliquerait d'ajouter une 9e pin pour le canal SPI, pour avoir une sortie 3.3V et une sortie 5v. J'aimerais mieux pas, pour que ça rentre dans un cable cat-5.

À la place, je propose plutôt d'intégrer ce circuit à notre PCB, qui est ultra simple :
https://cdn.sparkfun.com/datasheets/BreakoutBoards/Logic_Level_Bidirectional.pdf
Je réutiliserais exactement les mêmes composantes SMD que le module de sparkfun, pour pas risquer de manquer un paramètre critique.

jayserf, 2018-01-18:
damn, the radios I use NRF24 are 3.3 but the logic does not need to be shifted, so i've been using 3.3V regulator adapters and the signal stays as direct connections to the arduinos.

I actually thought esp and lora radios were 5 so I wasn't asking for 3.3...
(I have a bunch of those LLS boards but i dont use them)

ok to add the parts I say if we can more easily use most common radio modules.

but why the CAT5 cable?

we can connect the radio with an 8 pin header on the board. the box is plastic and worse case you buy an SMA antenna and keep it in the box. or make a hole and use an extension wire. (Especially LoRa wont have a problem, but even NRF works really well.)

If I understand you have a cat5 cable to connect a small radio board outside the main box?

LoupHC, 2018-01-28:
Finalement j'ai juste copié le pcb de Sparkfun, ya pour 3$ de pièces au total.

Pour le cat5 j'imaginais que ça serait intéressant si on connecte plusieurs modules sur le channel SPI, ça permet d'avoir les modules wireless en dehors de la boîte et de garder un layout simple au lieu d'avoir plein de cables lousses dans le boitier.
C'est mon côté un peu maniaque et rangé qui s'exprime, mais anyway là je rajoute pas de connecteur extra, ça va tout décaller et j'ai déjà tout refait les traces!

Mais j'avais oublié qu'on voulait mettre un connecteur pour plugger direct une radio comme t'aimes! Je vais essayer de faire fitter ça, ça pourrait je pense!

jayserf, 2018-01-30:
Ah OK, good pour le PCB de sparkfun.

Merci pour le connecteur si possible, sinon c'est des fils mais juste une petite radio n'est pas si pire. Pour le range ca se colle sur un mur de la boite, le platique derange pas trop les radios si l'antenne st tenu un peu loins des PCBs.

Sorry I wasnt more helpful on the LLS debate

Closed 2018-02-06.

Thread 28 (2018-01-19):

Nouvelle pub sur le RJME

yoangp, 2018-01-19:
Salut!

Loup, est-ce que tu peux nous dire quand tu pense que ça peut se clarifier le lieu de l'atelier et la subvention pour les formations?

Éléments à penser:
-Établir concrêtement comment des gens puissent commander sans être présents.
-Ça serait le fun de montrer une photo de comment ça avance, mais s'il fait attendre le premier prototype monté, ça me semble trop long. Il y a toujours les fichiers de pcb, mais c'est juste bon à exciter les geeks ces affaires là..
-Expliquer comment va se passer la fin de semaine (hébergement, bouffe, etc.)
-Intégration de la vente de moteurs..
-Autres..

LoupHC, 2018-01-19:
Ça gosse, ça a été délégué au nouveau dg de la CAPÉ, et ils ont l'air d'être en branle-bas de combat en ce moment. Pour l'instant je dirais que ça va avoir lieu "aux environs de Montréal" vu que les deux options c'est Repentigny et Saint-Jean-sur-Richelieu.

LoupHC, 2018-01-19:
Est-ce que ça fait le tour des infos à transmettre?

Un petit rappel pour dire qu'il reste une semaine pour vous inscrire à l'atelier d'autoconstruction d'automates de serre.

Date limite d'inscription : 26 janvier
Date de l'atelier : 14-15 avril
Lieu : à déterminer (aux environs de Montréal)

De l'hébergement sera disponible sur place, et un système de remplacement sera mis en place pour ceux.celles qui ne pourraient pas être présents, prioritairement à ceux.celles qui viennent des régions éloignées.

Inclus dans le programme :
- Boîte relais avec contrôle indépendant des rollups et overrides manuels
- Contrôleur pour le contrôle des roll-ups et 4 sorties supplémentaires pour le contrôle des fournaises et de la ventilation
- Possibilité d'intégrer une alarme en cas de coupure de courant ou de surchauffe
- Initiation à l'électromécanique, troubleshooting électrique, l'électronique et la programmation.

Et un scoop avec ça :
Le comité d'autoconstruction s'associe avec l'entreprise Orisha pour offrir une interface  de contrôle et de monitoring du contrôleur sur le cloud. Le service sera mis en place dès cet été.
Coût de l'abonnement : 12-25$/mois, peu importe le nombre de serres connectées

Pour s'inscrire : https://www.fermierdefamille.com/fr/capeautoconstruction/catalog/72/
Infos sur le contrôleur : https://github.com/LoupHC/controleur-CAPE/wiki
Écrire à Loup pour suivre les échanges du contrôleur, via liste de courriel dédiée.

LoupHC, 2018-01-19:
Ah ouais pis : Amenez votre lunch!

LoupHC, 2018-01-19:
Pour les photos, c'est vrai que c'est pas évident de trouver une bonne photo qui donne le goût...
Je pense que je me fierais aux envolées lyriques de Yan pour le côté catchy...

yoangp, 2018-01-19:
-Ok pour le lieu, au moins ça donne une bonne idée.
-Comme tu le mentionnait à Reid, je penses effectivement qu'on pourrais intégrer la vente des moteurs sur la même page que les ateliers, je trouve que c'est clean.
-Est-ce qu'on peut contacter la liste des bénévoles inscrits pour leur demander s'ils sont prêts à faire le montage pour d'autres gens pas présents?
-Amenez 4 ou 5 lunchs...? Est-ce qu'on s'imagine que la plupart des gens vont rester coucher? Il y aura alors au moins diner, souper, déjeuner, diner. Est-ce qu'on fait cela style potluck vu que ça fait bien des lunchs à préparer sinon?

yoangp, 2018-01-19:
Dire que ça pourrait être connecté au Cloud cet été, c'est pas un peu tôt? Si on dit cet automne, ça donne un peu plus de temps et j'ai l'impression qu'il n'y  pas grand monde qui va avoir le temps de mettre cela en place au milieu de l'été. Qu'en penses-tu Loup?

LoupHC, 2018-01-19:
J'écris aux bénévoles, en attendant j'ai déjà deux amis qui m'ont dit qu'ils seraient ouverts à un échange, donc on peu en parler avant d'avoir la confirmation de tout le monde.

Pour le potluck, je sais pas, c'est quand même de la gestion, un potluck. Et on sait pas encore l'espace cuisine disponible, si c'est à Cadet Roussel ça se peut sans doute, mais chez Mario, on aurait sans doute juste une petite cuisinière. Comme c'est sur une ferme on peut dire qu'il y aura une chambre froide pour conserver la bouffe?

Pour le cloud ils m'ont dit qu'ils allaient se mettre là-dessus pour rendre ça disponible dès cet été. Mais la formulation "au courant de l'été" est peut-être à privilégier.

LoupHC, 2018-01-20:
All set : ça sera chez Cadet Roussel.
Et je rajoute : formule potluck pour les repas.

yoangp, 2018-01-20:
Cool!! Great job Loup!

jayserf, 2018-01-20:
Wow, beaucoup d'information vous avez rassembler! Nice job!

On Jan 20, 2018 2:59 PM, "yoangp" <notifications@github.com> wrote:

Cool!! Great job Loup!

—
You are receiving this because you were assigned.

Reply to this email directly, view it on GitHub
<https://github.com/LoupHC/controleur-CAPE/issues/28#issuecomment-359197945>,
or mute the thread
<https://github.com/notifications/unsubscribe-auth/AZfkJyXQklSi3LiZe7Qa9CFNW6oqEAfIks5tMkWKgaJpZM4Rk40f>
.

yoangp, 2018-01-22:
Concernant les gens qui veulent acheter un kit, mais qui ne peuvent pas venir:
-Est-ce qu'on limite cette option à ceux qui sont vraiment trop loin (car on a un nombre limité de bénévoles pour nous aider)? Ou bien, on met simplement cette option dans le catalogue selon le nombre de bénévoles qui veulent s'impliquer et c'est premier inscrit premier servi.
-Qu'est-ce qu'on fait avec les coûts de formation? On pourrait filmer l'événement (grâce à un bénévole) et mettre cela en ligne par la suite. Autre idée?

Closed 2018-02-06.

Thread 29 (2018-01-22):

Promo pour inscriptions

yoangp, 2018-01-22:
Allo!

J'ai discuté de notre manque d'inscrption avec ma conjointe qui a étudié en business et elle trouvait qu'on devrait pousser plus fort sur les avantages de notre système. Voici ce que je propose:

**Coût avantageux**
CAPÉ (avant taxes):
-1 kit: 1290$
-2 kits: 2280$
Commercial de base (avant taxes):
1 kit: Environ 1600$
2 kits: Environ 3200$

**Formation incluse**
Comprendre un système d'automatisation de serre, être en mesure de faire du débuggage de base en cas de problème, notions d'électronique de base (ex.: utilisation d'un multimètre pour prendre des mesures et faire des tests électriques) et notions d'informatique de base.

**Protection humidité**
Le système sera construit dans une boîte étanche afin de protéger le système de l'humidité (pas toujours le cas avec les système commerciaux)

**Possibilités de développements futurs**
Compatibilité avec un système de monitoring sur le web et de sondes sans fils prévu en 2018

**Revenus pour la CAPÉ**
Au-delà du nombre d'inscriptions minimum (environ 15 boîtes de relais et 15 contrôleurs), les surplus seront versés directements à la CAPÉ.

**Réseautage**
Une super occasion de solidifier vos contacts parmis les autres fermiers du réseau!

****************************************************************
Qu'est-ce que vous en dites?
Une fois qu'on s'entend là-dessus, ça pourrait être rajouté au courriel de Yan.

Closed 2018-02-07.

Thread 30 (2018-01-24):

Prototype driver de relai

yoangp, 2018-01-24:
J'ai fait un test avec le prototype de driver de relai et tout a l'air de fonctionner normalement avec un moteur de côté ouvrant branché dessus. Je n'ai à peu près pas de modifs à faire sur le pcb, sauf peut-être un trou dans le milieu du support de la fuse pour la solidité mécanique.

Loup, je monte le deuxième driver de relai et nous pourrons nous rencontrer en personne. Je vais regarder mon horaire, car j'ai un petit rush sur la ferme d'ici mercredi prochain. Ainsi, jeudi de la semaine prochaine serait bon pour moi. Est-ce trop tard pour toi? Si oui, je vais voir si je peux me libérer vers la fin de cette semaine.

En passant, ça m'a pris à peut près une heure à monter, donc x 2 pour les deux côté nécessaire à une boîte de relai. Évidemment, cela n'inclue pas le travail pour les connecteurs et fixer le matériel sur la boîte.

Ciao!

yoangp, 2018-01-24:
En passant Loup, est-ce que tu as vu que les drivers de relais sont maintenant 8cm de large par x 6cm de long. Ça économise encore un peu d'espace dans le boîtier.

LoupHC, 2018-01-25:
Nice non j'avais pas vu ça!!!
C'est vraiment excitant j'ai hâte de voir ça. Jeudi prochain moi ça me va. Sinon en fin de semaine je suis à Montréal, on pourrait se rencontrer là et ça permetterait à Jason d'être là aussi!
Je vais assembler mon circuit perfboard d'ici là, et envoyer les protos à imprimer en début de semaine prochaine.
Ça t'a coûté combien le shipping recommandé et les prototypes? T'as reçu ça en combien de temps et t'en as commandé combien?

jayserf, 2018-01-26:
Cool Yoan! hate de voir ca aussi. Nice job pour la reduction de taille et PAS de revisions majeure!

Cet fin de semaine (demain) je suis au laurentides pour une fete. Vous parler de celui ci ou le 2-3-4fev?

LoupHC, 2018-01-29:
Faque tout est beau avec le motor driver, c'est clean, le form factor est parfait et ça fonctionne super bien.
Bravo Yoan!!!

jayserf, 2018-01-29:
Bravo Yoan!

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

Closed 2018-01-29.

Thread 31 (2018-01-29):

Retour sur soumissions

LoupHC, 2018-01-29:
Faque on a reçu les deux soumissions pour faire imprimer/assembler les circuits.
Soumission contrôleur :
https://docs.google.com/spreadsheets/d/16Y3bVeKkrIgNWwjR_LlU5sF_WZEezp7sD9hzIpVireg/edit?usp=sharing
Soumission relais : https://docs.google.com/spreadsheets/d/1IUjBSyNJqgLbTRPqoz3maPh4fo51kFOpfDNz3UG8ut8/edit?usp=sharing

Je retiens 4 points critiques en checkant ça :
1. On est limité pour les formats à 25 ou 50 circuits.
2. En fonction de ces chiffres-là, ça balance!!!  Et la CAPÉ dégage même un bénéfice de 0-3000$.
3. Le temps de fab est de 45 jours,

Ce que j'en pense :
1. Par rapport aux quantités, je propose qu'on fixe le nombre maximal d'unités vendues à 25 boitiers relais et 25 contrôleurs. Comme ça on commande 25 contrôleurs (excluant les protos) et 50 motor drivers.  Les 3 tannants qui auront besoin de drivers relais extras (6) on pourra leur faire à partir des protos, ça en laisse 2 pour Yoan, 2 pour moi, et Jason aura ceux de sa ferme! Et on pourra leur vendre personellement ça va être moins compliqué que gérer ces détails-là via la CAPÉ.
On est rendu à 21 vendus de chaque, et yen a deux autres réservés déjà, aucun soucis qu'on va réussir à tous les vendre d'après moi.
Je pense que c'est risqué d'en commander le double, surtout qu'après 1 été il y aura peut-être des améliorations à apporter si jamais la CAPÉ veut refaire un atelier. Vous c'est quoi votre avis?

2. Pour le budget, j'ai calculé une grosse boîte pour tout le monde, pour simplifier l'assemblage.

3. Là on a un problème. Si c'est 1mois et demi fabriquer et shipper tout ça, à partir du 5 mars, en courrier recommandé, on arrive short en esti avec l'atelier.
Est-ce que ça serait possible de leur demander de commander les pièces longues à shipper au moment de faire les protos, avant le nouvel-an Chinois, pour accélérer le processus quand on aura fait les révisions?

yoangp, 2018-01-30:
1. 100% d'accord d'y aller pour 25 contrôleurs, 50 driver de relai et 10 drivers de relais de plus montés à la main par nous avec les prototypes (dont 4 de côté pour Loup et moi).

2. Super, une grosse boîte pour tous.

3. Je suis d'accord qu'on a un problème. Une autre solution serait d'acheter nous même toutes les pièces dès que possible, les faire livrer au Canada, puis de tout envoyer en chine en courrier recommandé pour qu'ils aillent tout le nécessaire dès le retour au travail. C'est un peu stupide ce va et vient sur toute la planète, mais ça nous permettrait aussi d'acheter quelques pièces moins critique sur Aliexpress, moins cher que chez Digikey.

4. Jason, ma commande de PCB prototype a coûté 54$CA et j'ai du payer un extra de 17$ de frais de douane. 30% de frais de douane supplémentaire!! Est-ce que tu as une idée comment on peut éviter de payer 30% sur notre grosse commande?

jayserf, 2018-01-30:
1. OK mais on n'est pas limites en qte du tout, (sauf possiblement par multiple du panneau de pcb, x 2 x4 x6 etc) on peut faire 28 ou 30 ou 22, j'ai demander cela pour savoir autour de ces qtes la.
Je vais additionner ma commande perso aussi! pour 2-3 serres je crois.

2. OUIIII gross boite

3. Yoan ca marche pas malheureusement, l'import en chine est tough et il faut etre importateur et collaborer avec la compagnie destinataire pour que ca passe les douanes, souvent ca prends des semaines sauf s'ils sont habitues. MAIS je pose des questions ce soir pour reduire les delais si on commande les peices tout suite etc,. et aussi clarifier la 45 jours ca doit comprendre les vacances. le 5-8jrs d'achat pour les pieces est le plus long.

4. un peu mais le pcb assemblee n'est pas le meme code douane que pcb vierge. alors ca comprends des differents taxes. AUSSI c'est possible que 10$ sont des frais de service de douanes de DHL ou qqchose. faudra regarder la facture.
Je peut demander a une compagnie logistique avant de commander si on identifie differament ou qqs d'autre pour reduire la charge.

add 5. je trouve les frais d'assemblage tres haut je ne sais pas si c'est la qte ou le fait que c'est through hole alors plus manuel.

add 6. va falloir mettre une # de piece reference pour les les items 'generique' dans le bom.

add 7. pour reduire le temps de sourcing des composantes, on peut demander des alternatives ou les trouver nous memes, ils on deja suggere qqs unes. ca rentre en phase "bom optimization" pour reduire le temps de fab! (esperant ce n'est pas necessaire)

yoangp, 2018-01-30:
Autre idée pour sauver de temps. Loup, tu pourrais commander tes pcb de prototype de manière à ce que ça soit envoyé avant les vacances en chine. Peut importe si on a trouvé le bug de l'autre jour ou pas. On finira de trouver le bug pendant les vacances en chine. Au moins on aura quelque chose entre les main à tester. S'il faut faire quelques modifs du pcb de contrôleur, on devrait être assez certain que ça marche même sans faire de 2ième prototype.

yoangp, 2018-01-30:
Allo,

Est-ce que vous pensez qu'on pourrait lancer la fabrication finale du pcb de relai avant celle du contrôleur? Est-ce que ça fait une grosse différence de prix d'envoie? Au moins cette partie serait finalisée et ça serait ça de moins à se préoccuper.

LoupHC, 2018-01-30:
Ok, les inscriptions terminent le 3 février. Le 4 février on envoie les commandes finales de PCB moteurs et la commande de protos contrôleurs. Pour les PCBs moteurs, ils vont pouvoir commander les pièces manquantes avant le Nouvel-an et on devrait les avoir pas longtemps après qu'ils reviennent de congé.
Pour le PCB contrôleur, les seules pièces qui demandent du shipping, ce sont les switchs TH, et les sensors de courant.
Pour les switchs, est-ce qu'on peut s'informer s'ils ont des équivalents en stock et leur demander les dimensions? N'importe quelles switchs spdt TH feraient l'affaire.
Pour les sensors, est-ce qu'on peut s'informer s'ils ont ACS712 en stock? Sinon, si on leur confirme l'achat de 25 contrôleurs le 4 février, est-ce qu'ils peuvent commander les sensors tout de suite?

Par rapport au proto Contrôleur, j'ai commandé assez de pièces pour retester l'ancien prototype, figure out ce qu'on a fait de pas correct et éventuellement changer de stratégie. Ils m'ont appelé ce matin pour dire que c'était arrivé au Canada et ça devrait arriver aujourd'hui ou demain.
Réalistement je peux arriver à qqchose d'ici le 4 février.

Je pense qu'on est dû pour se jaser au téléphone, jsais pas ce que vous en dites.

yoangp, 2018-01-30:
Bonne idée pour l'appel téléphonique. Je suis disponible en soirée,
n'importe quel jour.

2018-01-30 10:53 UTC−05:00, LoupHC <notifications@github.com>:
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

Closed 2018-02-12.

Thread 32 (2018-01-30):

Mise à jour du BOM

yoangp, 2018-01-30:
Allo!

Voici quelques détails sur la mise à jour du BOM:

1. Fuseholder: le numéro de pièece du manufacturier que tu avais mis Loup n'était pas le bon, c'était pour une fuse 20mm de long, ça nous prend 30mm de long avec le footprint que j'ai mis. J'ai pas trouvé de fuseholder 6mm x 30mm sur Aliexpress avec le même footprint que celui que j'ai acheté chez Digikey. Donc j'ai mis celui de Digikey.

2. Dans le feuilet de la boîte, si la switch "3PIN Waterproof Switch ON/OFF" c'est pour changer de ouvrir à fermer en mode manuel, ça devrait être une switch SPDT (ON-OFF-ON).

3. C'est pas évidant de faire des trous carrés pour les switchs que tu as choisis. Je propose:
[Toggle-Switch-Screw-SP3T](https://fr.aliexpress.com/item/Toggle-Switch-3-Terminal-3Pin-ON-OFF-ON-15A-250V-Toggle-Switch-Screw-SP3T-Industrial/32817323925.html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)
et
[On-Off-On-3-Position-DPDT-6-Screw-Terminals-Toggle-Switch](https://fr.aliexpress.com/item/On-Off-On-3-Position-DPDT-6-Screw-Terminals-Toggle-Switch-AC-250V-15A/32796952978.html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,searchweb201602_1_10065_10344_10130_10068_10547_10342_10343_10340_10548_10341_10084_10083_10618_10139_10615_10307_10313_10059_10534_100031_10103_441_10624_442_10623_10622_10621_10620_10142,searchweb201603_2,ppcSwitch_4_ppcChannel&algo_expid=fad5d715-57c6-40c4-9c2f-74ae853cde3c-2&algo_pvid=fad5d715-57c6-40c4-9c2f-74ae853cde3c&priceBeautifyAB=5)
avec
[capote](https://fr.aliexpress.com/item/5-Pcs-Set-12MM-Toggle-Switch-Resistance-Cap-Cover-Rubber-Boot-Waterproof/32776791165.html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,searchweb201602_1_10065_10344_10130_10068_10547_10342_10343_10340_10548_10341_10084_10083_10618_10139_10615_10307_10313_10059_10534_100031_10103_441_10624_442_10623_10622_10621_10620_10142,searchweb201603_2,ppcSwitch_4_ppcChannel&algo_expid=07d6410d-b808-47d1-b432-97056765a9a9-23&algo_pvid=07d6410d-b808-47d1-b432-97056765a9a9&priceBeautifyAB=5)

4. J'ai changer les plug-in screw terminals pour qu'ils soient droit vers le haut.

5. Il faut voir ce qu'on fait pour les fusibles, j'avais fait une étude théorique en 2016 qui me disait que c'était mieux slow blow, mais je comprend que ça serait bien toute le même fuse partout. Il faudrait essayer avec des fast blow pour voir si ça fait la job dans la réalité. Pour finir ma réflexion, il existe toute sorte de fuses et l'ampérage n'est qu'un paramètre, ça me rend un peu mal à l'aise d'acheter une fuse sur Aliexpress qui n'as pas toutes les caractéristiques voulues. Ça risque de nous apporter des surprises. Pour l'instant j'ai donc mis des fusible Digikey, même si c'est 0,3$ de plus par fusible.

Pour finir, je crois que la partie du BOM pour le PCB du driver de relai est ok pour l'instant. Il reste juste la question du modèle des switchs pour le mode manuel.

Ciao :-)

jayserf, 2018-01-30:
Cool, merci d;avoir fait ca Yoan.

ET d'avoir incorporer la soumission de PCBWay en format excel, j'ai qqs questions mais pas tout suite.

1. OK good

2. pour les switchs OK cool, merci.

3. Yup Agreed.

4. nice

5. all good, j'aillais prendre d'une fournisseur qui liste tous les specs dans l'idee d'inclure plein de spares (genre 10) dans ch. kit, mais pas necessaire.

Je suggere qu'on fait le tour du bom du boite wt commander une prototype pour la boite vers la fin de la semaine pour pouvoir montrer une vrai durant leur fermeture.

yoangp, 2018-02-01:
Je pense que j'ai fini avec le BOM, voici un résumé des changements:
-J'ai ajouté les références de pièces du pcb
-J'ai créé une nouvelle feuille afin de séparer les pièces à souder sur le pcb du driver de relai de celles qu'on a juste à plugger dessus (juste fusibles et relais).
-J'ai réviser les coût avec les quantités qu'on a à acheter
-J'ai mis des relai Aliexpress
-Anisi, le coût final des pcb complets et soudés tombe à environ 25$ par pcb. Je pense que ça a du bon sens.

Jason: Est-ce que tu peux donc envoyer le BOM à PCBWAY selon la feuille "PCB relai" stp? J'ai aussi uploadé le fichier KiCad à jour avec les fichiers Gerbers (https://github.com/LoupHC/controleur-CAPE/blob/master/KiCad%20Files/CAPE_Relay_schield.zip). C'est les mêmes fichiers que le prototype.

Loup: J'ai refait les calculs de prix des feuilles "PCB relais" et "PCB relais add". J'ai fait une partie de la mise à jour des sommes sur la feuille "Summary", mais je te laisse le reste pour la partie contrôleur.

yoangp, 2018-02-01:
UPDATE!:

J'ai supprimé la feuille "PCB relai add. Il y avait juste les fuses des drivers de moteurs (qui étaient déjà là dans la feuille "Circuit components") et les relais (qui étaient déjà là dans la feuille Main box du BOM).

Jason: Pour la commande de quicaillerie, oublie pas aussi les relais , j'ai changé ça dans la feuille Main box du BOM pour qu'on les achètent aussi en chine pour réduire les coûts. Loup, ton idée c'était 6 relais  total par boîte right (dont 4 pour les drivers de moteurs)?

Loup: Est-ce qu'on a les adapteurs [PCB à DIN rail](https://www.digikey.ca/product-detail/en/phoenix-contact/1201578/277-2296-ND/290934) dans la quicaillerie du BOM? Je vois cela nul part.

LoupHC, 2018-02-01:
Yep, 6 relais, dont un pour l'alarme.
Et effectivement, je constate que les  adapteurs DIN rail sont pas inclus, oups.

J'ai juste un commentaire pour les switchs, j'avais eu une mauvaise surprise avec une switch très similaire à la switch On-off-on. Je pensais qu'elle gardait sa position mais en fait elle revenait toujours à Off quand on la lâchait. Garder une switch enfoncée pendant 2 minutes pour descendre un rollup, c'est long, faudrait vérifier si elle garde bien sa position toute seule. Sur la photo, ça a l'air par contre, la switch est visiblement à On et personne la tient. Mais je leur demanderais au cas.
Aussi, les connecteurs à vis sont pas très solides, ya presque pas de thread sur le boutte femelle, mais c'est pas trop grave si on crimp le fil. Mais sinon, avec un fil lousse, ça tient mal.
Sinon elles font un click très satisfaisant et ont l'air overrall robustes.
Et c'est une vraiment une bonne idée les capotes, est-ce qu'on est certain que c'est la bonne taille?

De mon côté, UPS a encore chié et le colis est resté stallé à Montréal, je reçois ça demain mais demain je travaille. Bref, je vous donne des nouvelles vendredi pour le circuit.

jayserf, 2018-02-01:
Alors 6 relais = 3 x pcb relais par boîte?

Ok pour le switch. Non-momentary type.

Ok pour pcbway et merci pour le bom + références. Plus le cleanup des extra
feuilles. Plus la séparation des pièces électromécanique du bom pcb!

La seule redondance est les connecteurs ronds sur le boîtier, je dois
ajuster le bom des boîtes pour être la même que celui des câbles.
(nécessaire pour une validation de polarité)

Je ne vais pas oublier les relais!

Loup tu mets les DIN mount supports?

Too bad pour ups, that sucks!

Je pense c'est tout

On Jan 31, 2018 9:18 PM, "LoupHC" <notifications@github.com> wrote:

Yep, 6 relais, dont un pour l'alarme.
Et effectivement, je constate que les adapteurs DIN rail sont pas inclus,
oups.

J'ai juste un commentaire pour les switchs, j'avais eu une mauvaise
surprise avec une switch très similaire à la switch On-off-on. Je pensais
qu'elle gardait sa position mais en fait elle revenait toujours à Off quand
on la lâchait. Garder une switch enfoncée pendant 2 minutes pour descendre
un rollup, c'est long, faudrait vérifier si elle garde bien sa position
toute seule. Sur la photo, ça a l'air par contre, la switch est visiblement
à On et personne la tient. Mais je leur demanderais au cas.
Aussi, les connecteurs à vis sont pas très solides, ya presque pas de
thread sur le boutte femelle, mais c'est pas trop grave si on crimp le fil.
Mais sinon, avec un fil lousse, ça tient mal.
Sinon elles font un click très satisfaisant et ont l'air overrall robustes.
Et c'est une vraiment une bonne idée les capotes, est-ce qu'on est certain
que c'est la bonne taille?

De mon côté, UPS a encore chié et le colis est resté stallé à Montréal, je
reçois ça demain mais demain je travaille. Bref, je vous donne des
nouvelles vendredi pour le circuit.

—
You are receiving this because you were assigned.

Reply to this email directly, view it on GitHub
<https://github.com/LoupHC/controleur-CAPE/issues/32#issuecomment-362136777>,
or mute the thread
<https://github.com/notifications/unsubscribe-auth/AZfkJziWgDq_bfdHzQp_WnH7Ns7DyZl7ks5tQR7pgaJpZM4Rxu6y>
.

jayserf, 2018-02-01:
Aussi, um, on est en train de vendre un kit de contrôle sans brains.

Pas de arduino inclus?

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

LoupHC, 2018-02-01:
Yep, arduino, rtc et autres sont dans la page Circuit components.
Pour les relais ya deux relais individuels sur des sockets din rail.

yoangp, 2018-02-01:
Loup, comment tu ajoutes la somme de la feuille "Circuit components" dans le summary du BOM?

Sinon pour les relais, ça demande un peu de clarification:

Option 1:
2 relais pour le driver de moteur du côté 1
2 relais pour le driver de moteur du côté 1
1 relais indépendant pour le chauffage
1 relais indépendant pour la ventillation ou l'alarme
Total = 6 relais

Option 2:
2 relais pour le driver de moteur du côté 1
2 relais pour le driver de moteur du côté 1
1 relais indépendant pour le chauffage
1 relais indépendant pour la ventillation
1 relais indépendant pour l'alarme
Total = 7 relais

Qu'est ce que vous en pensez? C'est sur que c'est plus le fun 7 relais, mais ça ajoute encore des coûts.

LoupHC, 2018-02-10:
Finalement j'ai merge Circuit components avec Main box pour clarifier.
Pour le 7e relais à voir, j'aimerais mieux, mais on peut se garder ça pour la fin quand on aura les soumissions, voir si ça bust notre budget

jayserf, 2018-02-13:
Agreed...

Dans nos serres le fournaise est un relais, ventilation intégrée au
fournaise  une autre et fans supplémentaires  au plafond une 3ieme...

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

Closed 2018-02-10.

Thread 33 (2018-01-30):

Plan de test

yoangp, 2018-01-30:
Identifier les tests à faire sur le driver de relai et le contrôleur.

À venir...

LoupHC, 2018-01-30:
Tests driver de relais :
- capacité des transistors à s'actionner sans brûler avec un input de 24V
- comportement des transistors en cas d'inversion de polarité des relais
- comportement des transistors en cas de court-circuit
- comportement des transistors en cas de survoltage
- capacité des transistors à actionner 8 relais 24v en simultané
- tester fuse action rapide/action lente
- si ULN28003 est inadéquate, tester les quad darlingtons ULN2065, qui supportent 80v en input et 1,5A en output!!!! (4x le prix par contre : 6$(3,50$ vs 1,50$)

Tests contrôleurs :
- compatibilité avec sondes
- tester communication SPI et sérielle
- protection survoltage/inversion de polarité/court-circuit

LoupHC, 2018-01-30:
J'ajouterais, tester si (worst case scenario) on branche 110V AC au input 24V ou 5v, quecé qui se passe.

yoangp, 2018-02-03:
Comment se passe les tests? Est-ce que tu as reçu les pièces finalement? Si tu veux qu'on s'en parles, on peut faire ça sur Hangout (Maike est partie avec le téléphone ce vendredi soir).

LoupHC, 2018-02-03:
On s'est manqué on dirait.
Oui, j'ai commencé à faire ça tantôt! À date, j'ai toujours pas compris ce qui s'est passé.
1. Test des inputs :  j'ai appliqué 23v  à chaque entrée, sans charge entre émetteur/collecteur.
Résultat : aucun dommage
2.  Test des outputs : J'ai appliqué 23v à chaque entrée, et connecté un relais à chaque collecteur.
Résultat : aucun dommage
3. Test des diodes : J'ai fait le même montage avec les diodes sur les relais, dans la même direction que la dernière fois.
Résultat : aucun dommage
5. Test court-circuit : j'ai branché une sortie directement sur le 24v
Résultat : dommage très localisé, sur la sortie et celles d'à côté, pas de feu ou de bruit

Bref, je suis un peu mystifié. Je me demande si il y avait pas un short qqpart dans mes soudures, pourtant à l'oeil je vois rien.
En y réfléchissant bien j'ai pas testé l'inversion de polarité. Je vais aller essayer ça!

yoangp, 2018-02-03:
Donc si tu alimentes les 8 relais il se passe rien?
Essaye de faire clignoter les relais genre une seconde tous à ON, une seconde tous à OFF quelques minutes. Tu peux aussi essayer des mettre cumulativement à ON à tour de rôle à une seconde d'intervale. Juste pour tester la capiacité de faire des manoeuvres à répétition et sur plusieurs sorties sans que rien ne brûle.
Est-ce que tu peux aussi mesurer le courant total qui passe dans le 2803 avec ton multimètre?

LoupHC, 2018-02-03:
210mA , les 8 relais allumés (25-30 mA chaque).
J'ai essayé de les allumer à tour de rôle à chaque .5sec et tout est beau...
Je vais essayer le clignotement, mais à date, aucun problème en vue...

yoangp, 2018-02-03:
Ça a l'air que le voltage max sur les sorties du PS2501 est de -7 à 80V. Il faudrait voir si un spike lors de l'arrêt du moteur pourrait théoriquement générer une tension négative inférieure à -7V sur l'alimentation 24V..

J'ai regardé ton circuit de protection d'inversion de polarité sur l'alimentation 24V du contrôleur. Il semble que la diode schotky 1N5822 peut laisser passer un leek current de 2mA. Ça reste à voir si c'est suffisant pour créer une tension inférieure à -7V sur les sorties du PS2501.

LoupHC, 2018-02-07:
Finalement j'ai remplacé la schotky par une 1n4004. Pas vraiment de stress pour ce circuit au niveau du voltage drop et le leak current tombe à 30 uA.

LoupHC, 2018-02-07:
Pour jouer safe, j'ai refait le circuit avec les transistors plus beafs (ULN2075). On a maintenant un circuit qui peut largement supporter des spikes de 47v, jusqu'à 2A/chip et 1,5A/pin. Overkill!
La fuse est pas assez rapide pour protéger des courts-circuits, la meilleure option que je vois c'est de mettre un power resistor en série pour limiter le courant, et rester comme ça largement en dessous des specs.
Je n'ai pas la résistance que ça me prendrait pour ce circuit mais j'ai essayé à plus bas voltage, short limité à environ 1,2A de courant et le transistor encaisse magnifiquement bien. On testera quand on aura les PCBs!

yoangp, 2018-02-07:
Parfait! J'ai bien hâte de voir ton pcb de contrôleur en vrai!

Tant mieux d'y aller avec des pièces overdesign, ça va nous protéger
un peu des imprévus. On est pas rendu à faire de l'optimisation fine.

Pour la résistance de puissance, je pense bien que ça peut faire
l'affaire, mais je ne suis pas sur que ça soit la stratégie
généralement utilisée pour limiter le courant. Sauf que là, je me dit
que le plus important c'est que ça marche. ;-)

Ciao!

Yoan

2018-02-06 19:54 UTC−05:00, LoupHC <notifications@github.com>:
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

LoupHC, 2018-02-07:
Hey c'est compliqué les maudits circuits limiteurs de courant!
Le gros bémol de la resistance c'est que ça limite le potentiel d'utilisation des transistors... mais bon le jour ou quelqu'un voudra driver ses moteurs directs sur le contrôleur il aura juste à l'enlever et à se forcer pour pas shorter son circuit. :P.

LoupHC, 2018-02-07:
On va recevoir ça dans les temps! Lundi prochain si tout va bien!

jayserf, 2018-02-13:
Wow, j'ai complètement louper ce bout de conversation. Désolé mais j'ai pas
trop de Input sur les résistance de puissance!

Par contre testes fonctionnelles et qualité jai de l'expérience. Aussi
testes de boîtiers assemblés plus.

Idéalement une arduino qui fait actionner tous les outputs un par un et
aussi qui teste les sondes ou une setup de test au poste d'assemblage
finale.

A voir

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

LoupHC, 2018-02-14:
Test effectués :
1. Allumage successif et simultané de 8 relais
- tension d'entrée : 24.5V
Observations :
Ça clique sans problème. Lorsque les 8 relais sont allumés, la chute de tension aux bornes de la résistance 20 Ohm est de 4.6v, autrement dit, les relais fonctionne sur 19.6v. On reste en haut du 18v minimum d'opération d'après la datasheet.

2. Court-circuit des relais
- court-circuit d'un des relais
- fusible fast blow 500 mA
- test avec résistance 25Ohm/20W et 20Ohm/10w
Observations :
Le court-circuit est réalisé en bypassant la bobine du relais.
J'avais d'abord fait le montage avec une résistance 25 ohm. Dans ce contexte-là, le court-circuit faisait chauffer le fusible mais pas suffisamment pour le faire fondre. La résistance dissipait cependant assez bien la chaleur.
J'ai changé la résistance pour une résistance 20Ohm. Quand j'ai refait le test, le fusible a brûlé après 3 secondes.
J'ai aussi réalisé que la résistance est collée au module d'horloge, qui dispose d'un capteur de température interne. Ce capteur pourrait servir de backup pour détecter les courts-circuits si le fusible ne lâche pas comme il devrait.

LoupHC, 2018-02-14:
3. Court-circuit des sondes
- jumper entre 5v et ground d'un connecteur de sonde
- laissé 5 secondes
Observations :
Tout éteint (donc l'alarme part!). Le régulateur de voltage ne chauffe pas, (limite selon les specs le courant à 1.25A) les traces non plus. Après suppression du court-circuit, tout reprend normalement.

LoupHC, 2018-02-14:
4. 110VAC dans le input 24v
- input 24V :
-varistor 39v 250A
- fuse 0.5A fast blow
Observation :
La fuse fond instantanément.
Aucun dommage sur le circuit après avoir changé la fuse.

5. 110VAC sur le input 5v
- varistor 27v 250A
- fuse 1.5a slow blow
Observation :
La fuse fond dans un beau flash.
Destruction du varistor
Destruction du regulateur de voltage
Destruction du cap Vout du régulateur
Destruction du I/O expander
Destruction de la chip temp/humidité
Destruction du arduino
...FAIL

yoangp, 2018-02-15:
Salut Loup,

Je trouve que c'est déjà super que le 110V dans l'entrée 24V ait fonctionné.

Je pense qu'il n'y a pas trop de circuit commerciaux qui sont protégés
pour du 110V dans une entrée 5V...

En tout cas, beau test destructif!! Ça fait mal au coeur, mais on sait
à quoi s'attendre après.

Est-ce que tu as les pièces pour refaire ton circuit?

Ciao!

Yoan

2018-02-14 18:47 UTC−05:00, LoupHC <notifications@github.com>:
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

jayserf, 2018-02-15:
Ouch, coup de foudre! mais je suis d'accord avec Yoan,

deja que ;e circuit a du texte ecrit dessus pour les terminaux et qu'il
fait essayer fort (les connecteurs ne se branchent pas ensemble (male 3 pin
au male 4 pin) si on disait que le % de possibilite est de 10% et moins ou
qqchose similaire, personne sera dessus de pas avoir ce protection je pense.

2018-02-14 20:34 GMT-05:00 yoangp <notifications@github.com>:

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

LoupHC, 2018-02-15:
Non sti... pas de arduino de rechange.
J'en ai commandé un autre pour vendredi.
J'ai refait une simulation du circuit avec un transistor à la place du regulateur, et une fuse 1.5A fast blow, et cette fois, aucun dommage. Je l'ai même essayé 2 fois.
J'ai l'impression que le circuit a le potentiel de fonctionner si la fuse fond instantanément.
Peut-être que ça a un lien avec la capacitance qui absorbe une partie du choc jusqu'à saturation...
On s'en reparle vendredi!

LoupHC, 2018-02-16:
Pas de arduino de spare... mais j'en ai commandé un pour demain.

LoupHC, 2018-02-16:
La transplantation de cerveau s'est bien déroulée. Notre pauvre prototype est back on tracks.
Comme je pensais, la vitesse à laquelle la fuse fond joue significativement sur les chances de survie du circuit.
J'ai refait environ 5 simulations de 120v dans le input 5v aujourd'hui, avec quelques variations dans le circuit. J'ai appris 2-3 petites choses au passage.
D'abord, pour protéger convenablement notre circuit, il faut mettre une diode sur le Vin, mais aussi sur le ground. Dans le premier fail de mercredi, ce qui a tué le condensateur  d'après moi c'est qu'il s'est retrouvé avec sa charge statique de 5v sur sa borne positive, et 27v sur sa borne négative, donc -22v en pleine gueule.
Ensuite, j'ai constaté que mettre un fusible action rapide permettait de sauver le circuit, mais que avec un fusible action lente ou attendre que le breaker lâche, résultait quand même à un bris de composantes, même si, théoriquement, il devrait survivre. Ya probablement une affaire de bruit là-dedans.

J'ai aussi testé avec une zener 25v, du côté protégé par les diodes, comme double protection du varistor. Je l'ai rajouté pour pouvoir utiliser un varistor plus gros capable d'opérer à 24v, parceque brancher 24v sur l'alimentation du contrôleur aurait pu fonctionner un certain temps, mais aurait dégradé le varistor sur le long terme. Avec la zener, si le voltage dépasse 25v, ça provoque un court-circuit qui fait sauter la fuse. Le bris survient donc sur une pièce enfoncée plutôt que soudée.
Dans un autre test, avec une fuse action lente, seulement la zener a brûlé, pas le régulateur de voltage!
Comme la zener est moins critique que le régulateur, c'est une autre bonne raison qu'elle soit là je crois.

LoupHC, 2018-02-17:
Finalement, quand je met tout ça bout à bout, ça ressemble à ça, et  le résultat est très satisfaisant!!!
Testé 2 fois à 120VAC, protégé 2 fois.
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

yoangp, 2018-02-17:
Ouais, ça va être méchament protégé ton circuit! On va pouvoir brancher les
fils les yeux fermer sans avoir peur de faire sauter quelque chose ;-)

Yoan

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

LoupHC, 2018-03-01:
Finalement le triac sera remplacé par un SCR unidirectionnel. La diode anti inversion sera placée entre le Varistor et le SCR sur le GND.
Testé 3 fois avec Fuse 1.5A FB. Aucun dommage 3 fois.

LoupHC, 2018-03-03:
J'ai refait le test de courant des moteurs. Bonne nouvelle, la chip ACS723 fonctionne!!!
Et j'avais visiblement un bug avec mon multimêtre....
À vide, le moteur tire entre 0.3 et 0.5A... en oscillant (le flow de courant n'est pas constant)
En forçant sur une ratchet, j'ai réussi à monter ça à 1A.

J'ai aussi commencé à écrire du code pour tester les différentes sections du contrôleur.

yoangp, 2018-03-04:
Salu Loup,

C’est vraiment plus c à quoi je m’attendais les valeurs de courant que tu
viens de mesurer! Très cool que la chip pour le courant fonctionne!! :-)

Ciao,

Yoan

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

Closed 2018-08-06.

Thread 34 (2018-02-01):

Sondage

yoangp, 2018-02-01:
Je vous as ajoutés comme collaborateurs au [formulaire du sondage](https://docs.google.com/forms/d/1WxO17ut5oeYTsKfFmCTYdPt4qe6uDdXuSNXFon4QN1Y/edit) .

Loup, est-ce que tu veux jetter un dernier coup d'oeil avant qu'on l'envoie? Tu as accès en écriture au besoin. Est-ce que tu t'occupes de l'envoyer aux gens inscrits?

LoupHC, 2018-02-02:
Oui je m'en occuppe! Merci Yoan!

LoupHC, 2018-02-02:
C'est envoyé!

LoupHC, 2018-02-02:
Je vais compiler ici les données du sondage au fur et à mesure que ça rentre :
https://docs.google.com/spreadsheets/d/1j9LD_4gHe2kkoIPN0RChVHgnP19oJdYkSyDbvr8SMhM/edit#gid=0
En passant, on est sold out!!!! 30 boitiers relais et 25 contrôleurs commandés. Hoppa!!

yoangp, 2018-02-03:
Malade!! :-)

2018-02-02 10:13 UTC−05:00, LoupHC <notifications@github.com>:
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

Closed 2018-02-02.

Thread 35 (2018-02-03):

STOP : ça balance pu

LoupHC, 2018-02-03:
Ok guys on l'a échappé.
Ça balance plus.
Faut trouver comment économiser minimum 70$ par boîtier.

LoupHC, 2018-02-03:
Pistes de solution (soumissions) :
- budget connecteurs sans soudure : 2816$ à 5,60$/ch
De combien on peut baisser notre prix unitaire si on en commande 500?
- budget grosse boîte : 6300$ à 92$/ch
De combien on peut baisser notre prix unitaire si on en commande 34?
- budget power supply 24V : 2000$ à 65$/ch
De combien on peut baisser notre prix unitaire si on en commande 34?

Pistes de solution (coupures) :
- acheter sonde température plutôt que temp/humidité : 400$ (-15$/sonde)
- supprimer un set de relais indiv./connecteurs : 320$ (-10$/boitier)
- acheter plus petites boîtes relais/contrôleurs seuls : 200$ (-20$/boite seule)
- assembler nous même les PCBs relais : 640$ (-20$/boite)
- mettre un PS 24v non scellé dans la boîte : 800$ (-25$/boite)

LoupHC, 2018-02-03:
Aussi :
- acheter 100 pcb relais (donc en stocker un peu) : (-10$/boîte)

jayserf, 2018-02-03:
Les connecteurs sont 5.60 pour le côté boîtier et côté fil, j'ai descendu
de 7.5 la paire ce matin.

Je crois que la boîte @ 90$ qui inclut le transport peu descendre pas mal
aussi.

Je suis chez ma mère et je vais possiblement être en train de manger à 8h.

Loup est ce qu'il y a juste 4 boites relais seulement?

Si oui est-ce qu'on peut enlever le 'format' qui inclut le transport et le
multiple pour les différentes 2 boîtes et les quantités commandes?

Faire tous les boms pour juste la boîte sans transport et fait la feuille
de calcul récapitulatif qui multipli la qte de chaque sous assemblage plus
transport.

Comme ça on élimine la possibilité d'erreurs de double calculs dans les
autres onglets

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

LoupHC, 2018-02-06:
Outcome :
- réduction du prix de la boîte
- réduction du prix des PS
- réduction du prix des connecteurs

Closed 2018-02-06.

Thread 36 (2018-02-14):

Défauts à corriger du proto contrôleur

LoupHC, 2018-02-14:
- Fusible F1 bloque le port USB du arduino
- Switchs 1-5 trop proches des connecteurs à vis
- Switchs 4-5 trop proches une de l'autre
- LED D16 bloquée par l'horloge
- Switchs 7-11 bloquent la chip Atmega du Arduino UNO (la chip du MEGA est ok, vu que surface mount)
- Switch P-MOSFET pour les allumer/éteindre les sondes = le circuit ne fonctionne pas, sort 2V seulement

jayserf, 2018-02-14:
Apart du p fet c'est juste du placement... Alors super!

Pourquoi on a ce circuit p fet? Pour protéger les Inputs de sondes?

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

LoupHC, 2018-02-14:
Pour pouvoir éteindre les sondes... javais mis ça au début, en me disant que ça pourrait permettre d'optimiser la consommation de courant du circuit. Je pense que je vais juste l'enlever.

LoupHC, 2018-02-14:
J'oubliais :
- inversion de la position du 24V+/GND sur le contrôleur, pour être similaire avec le shield relais.

jayserf, 2018-02-15:
Awesome!

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

Closed 2018-02-25.

Thread 37 (2018-03-02):

OUFFFFF.... sockets de relais

LoupHC, 2018-03-02:
Merde les gars, je crois que je viens de nous éviter un fail monumental.
J'ai commandé hier des sockets de relais through hole parceque je monte un boitier relais pour un gars... bien figurez-vous que les pins sont pas en face des trous.
Hier, j'ai aussi envoyé la soumission d'assemblage des Pcbs.
C'est comme qui dirait.... un bon timing.

yoangp, 2018-03-02:
Allo Loup! Bien vu! Mais je croyais que tu avais acheté déjà ces sockets pour les drivers de moteurs que tu as monté chez toi!?! J'avais trafiqué mes sockets de relais à partir d'un modèle différent car c'était back-order au moment que j'ai fait le montage, donc je n'ai jamais eu la vrai pièce... Quel est le numéro Digikey de la pièce que tu as commandé et qui ne fitte pas? Est-ce que tu peux me dire quelle dimension n'est pas bonne sur le footprint?

Closed 2018-08-06.

Thread 38 (2018-03-22):

Préparation de l'atelier

yoangp, 2018-03-22:
Allo Loup et Jason!

Nous allons avoir pas mal de choses à préparer pour l'atelier, voici quelques éléments, à compléter..

1. Rencontre préparatoire à trois avant l'atelier, je propose le 7 avril à la Ferme Cadet-Roussel. Comme ça on va pouvoir voir ce qu'il y a sur place. (À confirmer avec Arnaud si c'est ok pour vous)

- Voir ou les gens vont pouvoir dormir, manger, est-ce qu'il y a assez d'espace de travail, besoin de chauffer une pièce de plus, etc.
- Nombre de tables requis et arrangement, place pour projecteur, prises électriques et rallonges 120V,
- Révision de l'inventaire des pièces reçu et ce qu'on fait pour ce qui manque (Commande rapide Digikey, Addison, Abra, etc)
- Apporter déjà une partie de la commande de pièce si c'est trop pour entrer dans une auto en plus du reste du matériel pour l'atelier
- Vérifier l'accès à internet
- Organisation de la bouffe
- Plan de travail pour atelier efficace (chaine de montage, nombre de personnes par station, etc.)
- Horaire de l'atelier et temps alloué à chaque parties
- Plan du contenu des formations
- Avoir un prototype tel que sera construit
- Avoir un plan pour la modification des quelques boîtiers de 2016
- Penser et contacter quelqu'un pour présenter comment gérer le température des serres (Reid ou autre)
- Avoir une liste de tâches pour les gens assez bon en électronique pour nous appuyer lors de l'atelier (répondre aux questions, tester les montages, etc)
- Avoir un montage pour brancher aux relais les ventilateurs et une fournaise.

2. Matériel requis pour l'atelier

- Assez de tables
- Assez de chaises
- Projecteur
- 2 laptops
- Présentations offline sur clé USB
- Cables d'extension 120V
- Fers à souder
- Fils d'étain à souder
- Inventaire de pièces pour l'atelier
- Perceuses
- Mèches
- Cutters pour fils
- Pinces à dénuder fils
- Tournevis
- Multimètres
- Liste des participants pour les 2 jours (producteurs présents, bénévoles présents, bénévoles pour producteurs absents, etc.)
- Prototype assemblé pour faciliter les explications de montage

3. Message à envoyer aux participants une semaine avant l'atelier
- Rappel date, heure, lieu
- À apporter: Bouffe, outils de travail, tables, chaises, projecteurs, matelas et sac de couchage
- Paiement à apporter si pas fait avant?
- S'ils en ont déjà une pièce du montage, il serait mieux qu'ils l'apportent (leur contrôleur, leur boîte de relais de 2016 ou autre, leur moteurs si pas des 100W 24V)
- Demander qui parmis les participants a suffisament d'expérience pour répondre à des questions et tester les montages complets
- Apporter manuels d'installation et fiches techniques sur leurs ventilateurs et fournaises

LoupHC, 2018-04-10:
Pour m'amuser (et pour lâcher l'ordi 2 min) aujourd'hui j'ai fait deux plans de montage pour l'assemblage des sondes et du boitier d'interface (des éléments qu'on avait moins discuté ensemble).
Je pensais faire un plan similaire pour le code de couleur des fils dans les connecteurs du boitier

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

jayserf, 2018-04-11:
Great man!

Looks like da Vince sketchbook 😉

Très claire et efficace

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

yoangp, 2018-04-11:
C'est malade Loup! :-) Je travaille là-dessus cet après-midi et ce soir..

Ciao!

Yoan

2018-04-10 19:33 GMT-04:00 LoupHC <notifications@github.com>:

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

Closed 2018-08-06.

Thread 39 (2018-03-25):

Documents de formation pour l'atelier

yoangp, 2018-03-25:
Allo Loup et Jason!

Voici ce que j'ai jusqu'à maintenant, mais ce n'est pas final. J'ai refait les schémas dans Powerpoint, c'est pas mal semblable que Lucidchart et je n'ai pas de limitations..

[Formation Contrôleur de Serre V1.pdf](https://github.com/LoupHC/controleur-CAPE/files/1844964/Formation.Controleur.de.Serre.V1.pdf)
[Formation Contrôleur de Serre V1.pptx](https://github.com/LoupHC/controleur-CAPE/files/1844965/Formation.Controleur.de.Serre.V1.pptx)

La suite va avancer moins vite, il faut que je retourne à mes affaires de ferme!

LoupHC, 2018-03-25:
De mon côté j'ai mis à jour l'ordre du jour "officiel" de l'atelier, pour le 14 je me suis inspiré de ce que t'avais mis dans ton powerpoint :
[Plan de cours - autoconstruction contrôlleur de serre.docx](https://github.com/LoupHC/controleur-CAPE/files/1845493/Plan.de.cours.-.autoconstruction.controlleur.de.serre.docx)
Vous me direz si vous trouvez que c'est un ordre logique

yoangp, 2018-03-30:
Allo!
Nouvelle version, suffisament correct d'ici à notre meeting la fin de semaine du 7 avril:

[Formation Contrôleur de Serre V2.pptx](https://github.com/LoupHC/controleur-CAPE/files/1864466/Formation.Controleur.de.Serre.V2.pptx)
[Formation Contrôleur de Serre V2.pdf](https://github.com/LoupHC/controleur-CAPE/files/1864467/Formation.Controleur.de.Serre.V2.pdf)

Loup, j'ai repris ton horaire pour le samedi, mais j'ai fait quelques petits ajustements.
Aussi, est-ce que tu peux ajouter une section malfonctionnement et problèmes dans ta présentation du contrôleur? Ex: Quoi faire si le contrôleur ne fonctionne pas?

Je suis toujours en attendre d'un retour d'Arnaud pour confirmation qu'on peut venir le 7 avril..

jayserf, 2018-04-04:
Super nice doc!
Hâte de voir et discuter ce samedi!

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

yoangp, 2018-04-13:
Merci Loup, j'ai corrigé l'erreur
[Formation Contrôleur de Serre V2.pptx](https://github.com/LoupHC/controleur-CAPE/files/1907713/Formation.Controleur.de.Serre.V2.pptx)

yoangp, 2018-04-21:
Version comprenant juste les plan de montage plus à jour publiée sur le google drive public :
[CAPE - Automate de serre - Plans de montage de la partie puissance et moteurs.pptx](https://github.com/LoupHC/controleur-CAPE/files/1935034/CAPE.-.Automate.de.serre.-.Plans.de.montage.de.la.partie.puissance.et.moteurs.pptx)
(modif du montage pour ventilateur et corrections montage tubes de supports des moteurs)

Closed 2018-08-06.

Thread 41 (2018-04-11):

Documents techniques

LoupHC, 2018-04-11:
Ceci est une ébauche concernant les documents techniques à produire pour l'atelier.
J'en ai fait 4 aujourd'hui que je vous présente, et qui m'on permis de commencer à définir une terminologie qu'on pourrait utiliser pour se comprendre à l'atelier.

LoupHC, 2018-04-11:
Premier document, l'assemblage des connecteurs sur le boitier. La terminologie utilisée ici :
- les connecteurs sont numérotés de C1  à C14 un peu comme les pins d'une chip électronique, en partant d'en haut à gauche, en descendant et en remontant par la droite.
- un M veut dire connecteur mâle et un F connecteur femelle
- en plus du numéro de connecteur, chaque pin est numérotée, donc si on parle de la pin 3 du connecteur #4 on dira C4-3, etc.
- les relais sont numérotés de 1 à 3 et chaque pins sont numérotées de 1-8, donc la pin 6 du relais 3 = relais3-6
- pour le reste, j'ai utilisé les inscriptions marquées sur les pcbs
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

LoupHC, 2018-04-11:
Deuxième document, l'assemblage des switchs d'override sur la porte.
- Ici, les switchs d'override sont numérotées de  S1 à S6 dans le sens de la lecture (gauche-droite/haut-bas)
- Sauf la switch d'alarme, qui s'appelle ALARM-S
- Le bouton d'urgence s'appelle STOP(vis : STOP-IN et STOP-OUT)
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

LoupHC, 2018-04-11:
Et voici deux tutoriels : un pour l'assemblage de la sonde et un pour l'assemblage de l'interface.
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

LoupHC, 2018-04-11:
Voici ce que je pense faire d'ici l'atelier en plus de ça :
- longueurs et couleur des câbles
- tableau résumant les connexions (comme ce que t'avais fait Yoan en 2016)
Avez-vous d'autres suggestions de documents à faire?

jayserf, 2018-04-11:
Il faut que j'y pense plus...

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

LoupHC, 2018-04-11:
Document sur la longueur des fils :
[Longueurs de fil.docx](https://github.com/LoupHC/controleur-CAPE/files/1900225/Longueurs.de.fil.docx)

yoangp, 2018-04-11:
Wow, great job Loup!

2018-04-11 15:33 GMT-04:00 LoupHC <notifications@github.com>:

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

jayserf, 2018-04-12:
Vraiment! Travaille de fou

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

yoangp, 2018-04-13:
Document en cours sur les étapes de montage:
https://docs.google.com/spreadsheets/d/1Ph90L6zSw53EDh-UzOvEIbaZvkrDvfvorQicZrnXrpg/edit#gid=0

Closed 2018-08-06.

Thread 42 (2018-04-11):

Câbles à acheter

LoupHC, 2018-04-11:
Il nous manque  :
du fil blanc 1-cond 18AWG (300 pieds environ)
du fil noir 1-cond 18AWG (100 pieds environ)

yoangp, 2018-04-11:
Ok, je vais aller chercher cela chez Addison!

2018-04-11 15:28 GMT-04:00 LoupHC <notifications@github.com>:

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

jayserf, 2018-04-12:
10-4 merci Yoan

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

yoangp, 2018-04-13:
J'ai ça!

jayserf, 2018-04-13:
Nice!

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

Closed 2018-04-13.

Thread 43 (2018-04-12):

Outils/matériel à amener

LoupHC, 2018-04-12:
Salut guys,
Juste un petit reminder des trucs à ne pas oublier :
- projecteur et screen
- machine à étiquettes (et ruban)
- manière de fixer les caps gore-tex (le thread est pas assez long!!) : est-ce qu'on  encore le temps de trouver un taraud/tap 6mm x 0.75?
- powerbars
- j'ai pas trouvé les petites bolts pour les connecteurs!!! Faudra dire au monde de faire super attention...

Y m'en manque sûrement qui vont me revenir bientôt...

LoupHC, 2018-04-12:
Ah oui!
- les cables USB m- USB m
- les batteries lithium
- les circuits!!!

LoupHC, 2018-04-12:
- du tape électrique

Closed 2018-08-06.

Thread 45 (2018-04-24):

Paiements et remboursements

yoangp, 2018-04-24:
Allo!

Il faut que j'appelle Sylvain pour voir s'il a déjà traité mon premier remboursement de facture. Je vais ajuster le fichier google sheet des paiements et remboursements une fois que j'aurais l'info.

Loup, est-ce que tu as le numéro de Sylvain? Il ne me donne pas de nouvelles par courriel.

Merci!

yoangp, 2018-04-25:
Allo!

J'ai mis à jour le fichier des sommes dues, ça inclu la totalité des factures que j'ai payé pour le projet.

https://docs.google.com/spreadsheets/d/1NM7pdhPRF8dicAhb73UoOKUTNK5MP0mIvKdWR_Hl4Kk/edit?usp=sharing

Closed 2018-08-06.

Thread 46 (2018-04-25):

Liste de pièces de fournisseurs

yoangp, 2018-04-25:
Allo Loup et Jason!

J'ai mis quelques fournisseurs dans le fichier de pièces de rechange

https://docs.google.com/document/d/1VgbzbtCY_lTYmji9RNcAdy7L1CS0nJzxu6yfmUZuJMY/edit?usp=sharing

Ciao!

Closed 2018-08-06.

Thread 47 (2018-05-01):

Problème de mise à jour de l'heure

yoangp, 2018-05-01:
Changer l'heure dans le code, puis upload du code donne différence de 1 heure entre l'heure entrée et l'heure affichée sur l'écran du contrôleur.

Problème à cause de l'heure normale et l'heure avancée??

jayserf, 2018-05-01:
Je pense que oui.

J'ai juste mis le mien une heure plus tôt...

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

Closed 2018-08-06.

Thread 48 (2018-05-07):

Bug situation réelle #1 - Power supply 24V sauté - fuse F1 du contrôleur sautée.. Surtension?

yoangp, 2018-05-07:
Allo,

Je vais commenter le bug que j'ai en ce moment sur mon contrôleur, peut-être ça sera utile pour quelqu'un d'autre dans le futur..

Soiré d'orage suivie par power supply d'addison 24VDC 12,5A sauté et fuse F1 du contrôleur sauté sur le 5VDC. Peut-être tout ça a sauté à cause d'une surtension..

Loup, la fuse F1 sur le contrôleur que j'avais était de 1A, mais sur le schéma c'est 1,5A. Tu avais fait des tests à ce sujet, est-ce que je devrait vraiment utiliser 1A pour éviter tout domage, ou 1,5A sera ok?

Merci!

LoupHC, 2018-05-07:
Effectivement la fuse F1 saute seulement dans les situations de surtension... grace à elle tu viens de sauver toute l'électronique du circuit...

La fuse doit bruler le plus rapidement possible pour ne pas endommager le varistor et la zener de protection. Entre 1A et 1.5A la différence nest pas grande mais c'est important quelle soit de type fast blow.

LoupHC, 2018-05-07:
Pour comprendre le circuit de protection en cause :
https://www.sunpower-uk.com/glossary/crowbar-protection/

jayserf, 2018-05-07:
Le ps a sauté aussi?!

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

yoangp, 2018-05-20:
Update:

La surtension a sauté le power supply 24VDC et la fuse sur le circuit de sécurité du controleur sur le 5VDC. J'ai remplacé les 2 et depuis tout marche normalement! Yé!!

Mesure préventive: J'ai installé une power bar avec protection contre les surtensions, pas la top top, mais protection jusqu'à 1500 joules d'énergie, 15$ chez addison.

Je pense attendre que les autres bugs en cours soient réglés avant de parler de cela au groupe projet..

yoangp, 2018-08-05:
Allo les gars! J'espère que la saison va bien pour vous! Hmm, côté contrôleur; 2ième orage, 2ième power supply sauté! Shit! Les 2 étaient des power supply de led 12A de chez Addison. Je viens de commander un Mean well 6A comme au dernier atelier et un module contre les surtensions Mean well (https://www.digikey.ca/product-detail/en/SPD-20HP-277S/1866-5480-ND/9451829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). J'espère que je vais régler le problème ce coup ci!! La seule affaire c'est que le power supply de 6A sera pas suffusant pour mes besoins, il va falloir que je joue avec le code pour pas que les moteurs démarrent un après l'autre. À suivre...

LoupHC, 2018-08-05:
Hey si yest pas trop tard pour annuler ta commande, j'ai des power supply 24v à tension ajustable en trop ici (+- 2v genre)!
Je me demande si ça pourrait palier le problème des relais.
Sinon j'ai proposé à Fred Verville d'ajouter des thermistors en série avec ses moteurs et ça a reglé le problème chez lui!
Bref, si tu veux je peux t'envoyer ça cette semaine.
Très belle saison ici, l'étang est pas encore sec donc tout va bien!

LoupHC, 2018-08-05:
Aussi, si tu décides d'y aller avec le software fix, je te suggère d'y aller avec un délais utilisant millis() plutôt que delay(), qui va freezer le programme.
Un exemple avec la librairie elapsedMillis :
https://playground.arduino.cc/Code/ElapsedMillis

yoangp, 2018-08-05:
Cool, merci Loup pour les précisions sur le code. Je vais garder ma
commande de power supply.

Je pense que c'est une bonne chose que tu en ailles quelques un en stock
pour d'autre monde..

Bonne semaine,

Yoan

2018-08-05 12:50 GMT-04:00 LoupHC <notifications@github.com>:

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

Thread 49 (2018-05-20):

Bug alarme qui part lorsque les roll-up s'activent

yoangp, 2018-05-20:
Problème:
-Étienne Goyer mentionne que l'alarme part pour un court moment lorsque les roll-ups s'activent.

Hypothèse:
-Le courant lors de l'activation des relais et des moteurs des roll-up crée une chute de tension qui désactive momentanément le relai de l'alarme.

Pistes de résolution de problème:
1-La résistance de protection introduit une chute de tension trop élevée. Voir si la mise en place des jumpers pour contourner le résistance de protection règle le problème.

2-Le démarrage des moteurs tire trop de courant du power supply 24VDC et se traduit pas une baisse de tension suffisament grande pour que le relai de l'alarme (et les autres relais aussi surement..) deviennents momentanément inactifs. Ça m'étonnerait que ça soit ça le problème, car le montage est supposé consommer moins que la moitié de la capacité du power supply 24VDC, mais le courant de démarrage peut poser problème. Les thermistors sur les driver de relais sont là pour minimiser ce problème, mais je n'ai jamais pu vérifier que tout est ok par manque d'équipement de mesure.

Observation: J'avais déjà noté lors de l'atelier que les relais indépendants, avaient l'air de ne pas n'activer fermement (même sans moteurs branchés). En premier, la led de certains relais ne reste pas allumée (signe d'un manque de tension). Ensuite, les relais cliquent plus faiblement. C'est peut-être aussi un effet cummulatif; le premier relai qui s'active ne représente qu'une petite charge, mais rendu au 5ième relai et plus la baisse de tension est significative. Je suspecte grandement la résistance de protection. Loup, avec l'oscilloscope, il serait possible de voir à quel point la chute de tension est importante lorsque les relais s'activent. Il faut brancher l'oscilloscope sur la tension 24VDC juste avant les relais (une fois passé de l'autre côté de la résistance de protection), activer le test 5555, puis mesurer la tension avec l'oscilloscope lorsque chaque relai s'active.

LoupHC, 2018-05-26:
C'est probablement un peu des deux.
Avec deux moteurs à vide, en incluant les thermistors, le courant (mesuré au multimetre) est de 1,8 à 2,5A au démarrage, et de 0,4 à 0,8A en temps normal. (sans thermistor ça monte à 4A et probablement même plus si on pouvait faire une lecture très précise).

À 2,5A ça n'impacte pas le power supply, c'est pour ça que je l'ai pas vu passer, mais possiblement qu'avec 100 pieds de plastique et de tube galvanisé ça augmente significativement la charge au démarrage.
La cause du problème serait donc : probablement que le power supply dépasse son plafond de 6A et fait dropper la tension en conséquence. La résistance a un effet cumulatif vu qu'elle fait déja dropper la tension de 0,7V/relais actif.

Le problème semble survenir en PM, donc les rollups sont probablement déjà en partie enroulés (la charge est au maximum) et le relais de ventilation est possiblement aussi démarré :
- ça fait 4 relais actif donc 2,8V de chute
- si la tension chute encore de 15% à cause de la protection contre les surtensions on commence à perdre des relais.

En plus de bypasser la résistance, un autre piste de solution serait d'ajouter un condensateur pour amortir les pics de tension au démarrage. Peut-être même que ça résoudrait tous les problèmes et qu'on pourrait garder la protection que représente la résistance (qui a quand même son utilité).

LoupHC, 2018-08-06:
Solution testée à la ferme du Coq à l'âne :
- un thermistor supplémentaire en série avec chaque moteur
- bypass de la résistance de protection
Et ça marche! Plus de chute de tension déclarée.

Thread 51 (2018-08-05):

Situation réelle #2 - Bug d'affichage ou de contrôleur..

yoangp, 2018-08-05:
À 2 reprises j'ai du resetter le contrôleur de ma serre car l'affichage affichait n'importe quoi. Après reset la situation revient à la normale, mais je ne sais pas si c'est juste l'affichage qui bogge ou l'arduino qui fait n'importe quoi. La première fois c'était à un moment random il y a quelques semaines, la deuxième fois c'était après un orage.

Hypothèse; Lors de sutensions, les protections fonctionnent, mais créent des fluctuations d'alimentations qui font déconner le contrôleur.

Piste de solution: Il faudrait trouver une manière que le contrôleur s'auto reset s'il se met à faire des folies. Peut-être qu'avec [une meilleure protection contre les surtensions](https://www.digikey.ca/product-detail/en/SPD-20HP-277S/1866-5480-ND/9451829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) le problème va se régler.

LoupHC, 2018-08-05:
Ouais ça arrive des fois quand il y a des petites pertes de signal jusqu'à l'écran, il se désynchronise et il affiche n'importe quoi.
Peut-être juste ajouter d'autres condensateurs sur le circuit de l'écran aiderait à prévenir le problème?

Thread 52 (2018-08-30):

Empêcher d'activer les 2 roll ups en même temps

yoangp, 2018-08-30:
Allo Loup, pour garder une trace de notre échange...

Objectif:
Il faut empêcher d'activer les 2 rollups en même temps pour réduire le courant tiré du power supply (c'est à dire une charge de max 1 moteur plutôt qu'une charge max de 2 moteurs)

Une bonne partie de la solution:
Dans la loop du fichier Greenhouse_controller_CAPE, remplacer:

#if ROLLUPS >= 1 && defined(ROLLUP1_DESHUM)
R1.routine(rollup1Deshum, coolingTemperature, greenhouseTemperature.value());
#elif ROLLUPS >= 1 && !defined(ROLLUP1_DESHUM)
R1.routine(coolingTemperature, greenhouseTemperature.value());
#endif

#if ROLLUPS == 2 && defined(ROLLUP1_DESHUM)
R2.routine(rollup2Deshum, coolingTemperature, greenhouseTemperature.value());
#elif ROLLUPS == 2 && !defined(ROLLUP1_DESHUM)
R2.routine(coolingTemperature, greenhouseTemperature.value());
#endif

PAR:

 if(R2.isMoving() == false && R2.isWaiting() == false){
  #if ROLLUPS >= 1 && defined(ROLLUP1_DESHUM)
    R1.routine(rollup1Deshum, coolingTemperature, greenhouseTemperature.value());
  #elif ROLLUPS >= 1 && !defined(ROLLUP1_DESHUM)
    R1.routine(coolingTemperature, greenhouseTemperature.value());
  #endif
  }

  if(R1.isMoving() == false && R1.isWaiting() == false){
  #if ROLLUPS == 2 && defined(ROLLUP1_DESHUM)
    R2.routine(rollup2Deshum, coolingTemperature, greenhouseTemperature.value());
  #elif ROLLUPS == 2 && !defined(ROLLUP1_DESHUM)
    R2.routine(coolingTemperature, greenhouseTemperature.value());
  #endif
  }

yoangp, 2018-09-05:
Mise à jour:

J'ai mis en service mon contrôleur avec la modif. À première vue tout fonctionne. Lorsque j'allume le contrôleur, la fermeture des rollups pour la calibration se fait un côté à la fois. Ensuite, les côtés s'ouvrent à tour de role, jusqu'à 100% des deux côtés lorsqu'il fait chaud:

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

Mais après un petit bout de temps un bug étrange apparait. Il fait toujours aussi chaud, le contrôleur ne devrait rien faire. Mais il se met à afficher ceci:

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

Pis là ça coince, car il ne se referme plus lorsque la température redescend (j'ai mis la sonde de temp dans l'eau glacée et rien ne se passe).

Questionnements:
-Pourquoi le contrôleur se met à afficher OPENING en continu alors que l'ouverture est déjà de 100%?

Observations:
- Lorsque le bug apparait, le contrôleur n'est pas complètement buggé, je peux encore modifier les paramètres avec le clavier. Par contre, le bug persite. Il faut que je ralumme le contrôleur pour sortir du bug.
- Lorsque le bug apparait, les mots OPENING - OPENING ne clignottent pas et les sorties sont activés, donc il essait réellement d'ouvrir plus que 100% d'ouvreture..
- Avec le code initial, j'avais déjà noté ce comportement étrange, mais ça n'affectait pas le fonctionnement normal des rollups. À un moment donné je voyais que l'écran était bloqué sur OPENING. Hypothèse: Le bug existait déjà, mais le contrôleur pouvait s'en sortir lorsqu'un changement d'état survenait. Avec le nouveau code, il faut impérativement que l'ouverture ou la fermeture soit terminée avant qu'un autre action s'effectue sur les rollups.
- Côtés paramêtres, voici ce que j'ai:
`

//Create greenhouse object
#define TIMEPOINTS            1
        //# of timepoints
#define ROLLUPS               2          //# of rollups
#define STAGES                4          //# of cool stages (for rollups)
#define FANS                  0          //# of fans
#define HEATERS               0          //# of heaters
//********************PINOUT**************************
#define ROLLUP1_OPENING_PIN   0    //connect this pin to the opening relay (west motor) (Si pin 0, alors LED D16)
#define ROLLUP1_CLOSING_PIN   1    //connect this pin to the closing relay (west motor) (Si pin 1, alors LED D15)
#define ROLLUP2_OPENING_PIN   2    //connect this pin to the opening relay (east motor) (Si pin 2, alors LED D14)
#define ROLLUP2_CLOSING_PIN   3    //connect this pin to the closing relay (east motor) (Si pin 3, alors LED D13)
#define HEATER1_PIN           OFF    //connect this pin to the heater relay
#define HEATER2_PIN           OFF    //connect this pin to the heater relay
#define FAN1_PIN              OFF  //Connect this pin to the fan relay
#define FAN2_PIN              OFF  //Connect this pin to the fan relay
#define ALARM_PIN             7    //Connect this pin to the safety buzzer

//*************COORD GÉOGRAPHIQUES*********************
#define TIMEZONE              -5
#define LATITUDE              46.03
#define LONGITUDE             -73.56

//TIME AND DATE ARE SET AT FIRST UPLOAD ONLY
//For subsequent RTC programming :
//1. Uncomment (by erasing the "//") the line #define RTC_TIME_SET and #define RTC_DATE_SET and upload to set time
//2. Put back the comment markers("//") and upload again
//ALWAYS SET TO WINTER TIME

#define RTC_TIME_SET
#define HOUR_SET            20
#define MINUT_SET           58
#define SECOND_SET          0

//#define RTC_DATE_SET
#define DAY_SET             29
#define MONTH_SET           8
#define YEAR_SET            2018
//*******************************************************************
/*
TIMEPOINTS PARAMETERS - SYNTAX RULES:
- type variable(TYPE) :   SR, CLOCK or SS (sunrise, manual, sunset)
- hour variable(HOUR) :   SR/SS types => 0 -24 to 24
                          CLOCK type => 0 to 24
- min variable(MN_MOD) :  SR/SS types => -60 to 60
                          CLOCK type => 0 to 60
- heating temperature variable(HEAT) : 0 to 50
- cooling temperature variable(COOL) : 0 to 50
- ramping (RAMP) : 0 to
*/
//*******************************************************Timepoint 1
#define TP1_TYPE            CLOCK
#define TP1_HOUR            0
#define TP1_MN_MOD          0
#define TP1_HEAT_SUN        5
#define TP1_COOL_SUN        30
#define TP1_HEAT_CLOUD      5
#define TP1_COOL_CLOUD      30
#define TP1_RAMP            0
//*******************************************************Timepoint 2
#define TP2_TYPE            CLOCK
#define TP2_HOUR            10
#define TP2_MN_MOD          0
#define TP2_HEAT_SUN        18
#define TP2_COOL_SUN        24
#define TP2_HEAT_CLOUD      16
#define TP2_COOL_CLOUD      18
#define TP2_RAMP            15
//*******************************************************Timepoint 3
#define TP3_TYPE            SS
#define TP3_HOUR            -1
#define TP3_MN_MOD          0
#define TP3_HEAT_SUN        18
#define TP3_COOL_SUN        22
#define TP3_HEAT_CLOUD      16
#define TP3_COOL_CLOUD      18
#define TP3_RAMP            5
//*******************************************************Timepoint 4
#define TP4_TYPE            SS
#define TP4_HOUR            0
#define TP4_MN_MOD          0
#define TP4_HEAT_SUN        18
#define TP4_COOL_SUN        22
#define TP4_HEAT_CLOUD      16
#define TP4_COOL_CLOUD      18
#define TP4_RAMP            30
//*******************************************************Timepoint 5
#define TP5_TYPE            SS
#define TP5_HOUR            0
#define TP5_MN_MOD          30
#define TP5_HEAT_SUN        16
#define TP5_COOL_SUN        20
#define TP5_HEAT_CLOUD      16
#define TP5_COOL_CLOUD      18
#define TP5_RAMP            30
//*******************************************************************
/*
ROLLUP PARAMETERS - SYNTAX RULES :
- hysteresis (HYST): 0 to 5
- rotation up(ROTUP): 0 to 300
- rotation down (ROTDOWN): 0 to 300
- pause time(PAUSE): 0 to 240
*/
//*******************************************************Rollup 1 (overral parameters)
#define R1_HYST             2
#define R1_ROTUP            145
#define R1_ROTDOWN          145
#define R1_PAUSE            240
//*******************************************************Rollup 2 (overral parameters)

#define R2_HYST             2
#define R2_ROTUP            145
#define R2_ROTDOWN          145
#define R2_PAUSE            240

//*******************************************************************
/*
ROLLUP STAGES - SYNTAX RULES :
- temperature mod(MOD) : -5 to 10
- target increment(TARGET): 0 to 100
*/
//*******************************************************Rollup 1 (stages)
#define R1_S0_MOD           0
#define R1_S0_TARGET        0
#define R1_S1_MOD           0
#define R1_S1_TARGET        25
#define R1_S2_MOD           1
#define R1_S2_TARGET        50
#define R1_S3_MOD           2
#define R1_S3_TARGET        75
#define R1_S4_MOD           3
#define R1_S4_TARGET        100
//*******************************************************Rollup 2 (stages)

#define R2_S0_MOD           0
#define R2_S0_TARGET        0
#define R2_S1_MOD           0
#define R2_S1_TARGET        25
#define R2_S2_MOD           1
#define R2_S2_TARGET        50
#define R2_S3_MOD           2
#define R2_S3_TARGET        75
#define R2_S4_MOD           3
#define R2_S4_TARGET        100

//*************************************************************************
`

Hypothèses:
Le bug est probablement dans le code, mais pourrait aussi venir d'un glitch électrique qui met le controleur dans un état weird. J'ai donc tenté de reproduire le bug avec les moteurs déconnectés, le problème n'est pas réapparu. J'ai essayé de reproduire le bug avec les moteurs connectés. le bug est revenu. J'ai fait ça 2 fois avec le même résultat. Étrange.. Mais je pense toujours qu'il y a plus de chance que le bug soit vraiment dans le code.

Loup as tu une idée de ce qui pourrait causer cela? Sinon, est-ce que tu vois quelque chose d'autre que je devrais noter ou bien un test/flag à ajouter dans le code en temps réel pour identifier ce qui le fait bugger? Toute piste de solution est la bienvenue :-)  ... surtout avec le froid qui se pointe!

yoangp, 2018-09-06:
Ça se peut tu que le bug apparait lorsque les rollups sont ouverts à 100%, mais que la température continue de monter? Sur les photos que j'ai envoyés, la température a augmentée après que les rollups aient été ouvert à 100%.

LoupHC, 2018-09-06:
Vite de même, je dirais que le bug se situe au niveau de la calibration automatique des rollups, qui effectue une rotation complète pour s'assurer que les moteurs sont collés sur la limit switch.
As-tu vérifié si le bug persistait plus que 2-3 minutes?
Sinon tout va bien, c'est voulu!
Si oui, je jetterai un oeil là-dessus, en attendant tu peux désactiver la fonction de calibrage automatique dans l'onglet paramètre en remplaçant :

#define R1_RECALIBRATE
#define R2_RECALIBRATE
#define SAFETY_DELAY                  30 (nombre de minutes entre chaque calibrage)

par

//#define R1_RECALIBRATE
//#define R2_RECALIBRATE
//#define SAFETY_DELAY                  30

LoupHC, 2018-09-06:
Concernant le fait qu'il ne redescende plus si la température baisse, c'est que le signal est figé le nombre de secondes correspondant à une ouverture complète.

yoangp, 2018-09-07:
J'ai commenté le calibrage automatique et ça semble fonctionner. Il y aura un retour à faire dans le code à la fin de la saison pour voir s'il est possible de remettre le calibrage automatique. Ce qui est certain, c'est qu'il y a quelque chose qui ne fait pas la bonne affaire dans la fonction de calibrage automatique avec ce nouveau mode d'ouverture un après l'autre. Je dis ça car l'écran montrait que les deux côtés étaient en phase d'ouverture pendant le calibrage, il faudrait que ça soit juste un côté à la fois qui se calibre.

Malgré tout, un gros merci Loup pour ton temps sur cette modif du code, je suis prêt pour le temps froid :-)

Thread 53 (2018-09-08):

Bug :  stages identiques

LoupHC, 2018-09-08:
Rapport de bug de Fred Verville
"Ah oui, pour le côté ouvrant qui ne fermait pas le soir, j'ai (re)trouvé le problème. C'est parce que mes deux derniers "stage" d'ouverture était le même, soit 100%. Ça fait buger le contrôleur de passer d'un stade à un autre avec un même niveau d'ouverture, ça m'était arrivé sur ma 1ère serre aussi, avec deux niveaux d'ouverture d'un côté à 0% pour les deux premiers stages. Bref, pour que tout fonctionne, faut toujours qu'il y ait un petit changement de l'ouverture d'un stage à l'autre, même si c'est 2%. Bref, je sais pas si tu étais au courant mais je te le dis! :P
"

yoangp, 2018-09-25:
Bon à savoir et important à corriger dans la prochaine version du code!

Closed 2019-01-20.

Thread 54 (2018-09-25):

Subvention InnovAction - 5 février 2019

yoangp, 2018-09-25:
Commentaires généraux:

-Loup, dans la demande tu devrais te présenter comme coordonnateur du projet. Ça te donne un statut important dans le projet même si tu n'as pas de formation spécifique en électronique/informatique. (Suggestion de ma conjointe) À voir si tu pourrais demander le même taux horaire qu'un ingénieur pour les heures de coordination.

yoangp, 2018-09-25:
J'ai mis un début de brouillon du formulaire (appelé Brouillon Yoan) sur Dropbox/subvention 2019/paperasse.  C'Est juste des idées, on s'en rejase..

yoangp, 2019-01-04:
Brouillon de calcul de l'aide financière:
https://docs.google.com/spreadsheets/d/1exxTFzlRIwsBK15juQJ0n2sMos91u_hbtw-HYLdaNtg/edit?usp=sharing

yoangp, 2019-01-13:
Allo Loup,

Désolé pour le délai. Après avoir parlé à Geneviève Legault la semaine passée, elle a dit que la dernière fois environ 50% des projets ont été financés sur un total d'environ une centaine de demandes. Aussi pour les délais de traitement, elle a dit qu'elle a participé à l'envoie d'une subvention pour le volet 1 au deadline d'octobre dernier et qu"il n'y a pas eu encore de réponse. Donc, il faut planifier plusieurs mois de délais avant de savoir si ça va marcher ou pas.

Après que je lui aie raconté ce qu'on compte faire, son commentaire le plus important était qu'il faut qu"il y ait un aspect nouveau/innovateur et que le fait que les grosses serres ont probablement déjà la technologie qu'on essaie d'implanter n'est pas une bonne affaire. Elle a dit qu'on peut essayer de dire qu'il y a un gap technologique pour les petites et moyennes fermes. L'autre affaire c'est les priorités du secteur, c'est bien beau qu'on dise que c'est important les serres pour les petits maraichers, mais la subvention vise tout le secteur agricole, autant conventionnel que bio, animal que végétal et qu'il y a des priorités officielles qui ont été écrites dans les dernières années. Apparemment Frédéric Thériault de Tournesol a participé à l'établissement des priorités en maraichage biologique. Mais le bio ça reste 1 à 2% des productions végétales du québec, donc peut-être pas tant prioritaire overall. Aussi, ça ne va peut-être pas passer si on semble trop être dans un mode de pré-production. Il faut que ça reste quand même au niveau de la recherche même si c'est une adaptation technologique. En résumé, elle pense que notre projet ne colle pas à 100% avec ce qui est visé par la subvention, mais j'ai l'impression qu'on peut s'essayer quand même.

Elle a dit qu'pourrait réviser notre demande, pour cela je pense qu'il faudrait lui donner 2 semaines. Je propose qu'on essaie de finir notre brouillon d'ici vendredi prochain.

Je vais donner un gros coup sur la rédaction de la subvention la semaine qui s'en vient, dès lundi soir je devrais avoir de quoi à te partager.

Est-ce que tu pourras appeler Climax en début de semaine?

LoupHC, 2019-01-14:
Salut Yoan!
Pas de problème pour appeller Climax! Par contre, c'est moyen encourageant ce qu'elle nous dit là...
est-ce qu'elle a noté des éléments à notre avantage sur lesquels on devrait miser?

yoangp, 2019-01-16:
Réponse de Geneviève Legault:

"Après discussion avec les collègues, la demande devrait bien prouver que la technologie n’existe pas ou qu’elle ne répond pas au besoin et le type d’adaptation qui doit être fait pour que cela réponde au besoin des entreprises de petite et moyenne envergure.

Produire une technologie plus abordable n’est pas un justificatif, il faut démontrer la problématique au niveau technique.

Bonne chance dans vos développements,

Geneviève Legault, agronome, MSc."

Closed 2019-01-16.

Thread 56 (2018-12-13):

Brainstorming - Nouveau design, prototype 2019?

yoangp, 2018-12-13:
Allo!

Pour m'amuser, j'ai fait le schéma suivant pour essayer de voir s'il y aurait une façon de rendre le contrôleur vraiment pas cher tout en offrant une possibilité de communication/alarmes sur smartphone. Le schéma regroupe toutes sortes d'options, il ne faut pas penser qu'il y aurait tout ensemble. Par exemple, il y a les deux options de design Arduino Yun ou Arduino Mega + Raspberry Pi.

https://docs.google.com/drawings/d/1-hGnpsdTrqrXmDoJYeqsXhl5zh_nJ-BTi--XsoNR4tE/edit?usp=sharing

Commentaires:
- Le projet Farmbot utilise l'équivalent d'un Arduino Mega (Pwm, interrupts, IO,..) et un Rapsberry Pi (serveur web, wifi)
- Le projet OpenSprinkler fonctionne sur Raspberry Pi (ou autres..), mais ne semble pas nécessiter d'interrupts ou de pwm..
- Je n'ai pas vu l'Arduino Yun dans un projet commercial, mais ça semble vraiment simple vu qu'en un bloc ça peut tout faire (IO, PWM, Interrupts, serveur web, wifi, etc.) et que c'est fait à la base pour être vraiment facile de faire un lien entre les IO du Yun et un site web sur le serveur web ou d'envoyer des messages via l'internet...
- J'aime vraiment l'idée de faire de quoi vraiment pas cher, avec le mimimum de montage.
- L'idée d'envoyer des sms via un shield GSM est intéressante dans le sens que le risque de problèmes est minimal (s'il est possible de trouver un shield qui fonctionne bien.,,). Pas de chaine de communication complexe qui passe par l'internet. Mais ça reste pas mal basic et le futur sera aligné plus sur les solutions via internet plutôt qu'un contrôle par sms qui fait penser à la technologie des années 2000.
- Je pense qu'on peut couper par 2 le coût des drivers de moteurs si c'est un H-bridge avec mosfets plutôt que des relais. Mais c'est plus complexe car il est souhaitable d'utiliser des sorties PWM pour faire des démarrages/arrêts de moteurs smooths.

LoupHC, 2018-12-13:
Hey! Belle recherche Yoan!
J'ai plein de petites nouveautés à vous partager aussi! Je reviens d'une formation avec Climax-Conseil et j'ai jasé pendant longtemps de gestion climatique avec Sébastien et Dany. Mais avant de me lancer là-dedans, mes commentaires :
- choix mega+RPi vs Yun : je privilégierais le MEGA parceque c'est le processeur qu'on utilise déjà avec les Otomates déjà existants, tout simplement. Aussi, le Yun a moins de mémoire SRAM et faudrait couper ou refactoriser pas mal de code pour rentrer le software existant sur le atmega du Yun (et même le processeur linux est petit).
- opensprinkler : à ce sujet, j'ai appris quelque chose d'assez intéressant récemment, le raspberry pi d'opensprinkler donne la possibilité de se connecter à un téléphone en acces point. Autrement dit, même sans connexion au réseau internet, on peut s'y connecter avec un téléphone en établissant un genre de wifi local!
- intégration du wifi : déjà je pense que pour mieux répondre aux besoin de tout le monde on est mieux de prendre pour acquis qu'aucune serre n'a de connectivité wifi pré-installée à priori. Ensuite, si on réussit à connecter le contrôleur d'une façon pas chère et abordable, j'ai quand même quelques appréhensions. Je suis probablement juste chicken envers quelque chose que je ne connais pas vraiment, mais j'ai l'impression que toutes les compagnies qui offrent des services via internet sont jeunes, évoluent vites, peuvent disparaître du jour au lendemain ou modifier leurs tarifs sans prévenir. Si on vise quelque chose de low-maintenance, je m'en méfierais... Cependant ça donne plein de possibilités intéressantes comme contrôle à distance, mais en même temps, est-ce qu'on connait beaucoup de fermiers qui passent beaucoup de temps loin de la ferme?
Un des pièges dans lequel (intuition) faudrait pas tomber, c'est créer une dépendance entre les utilisateurs et nous. Si un jour on se retire du projet, faut pas que les gens se retrouvent avec des bidules inutilisables parceque plus personne ne s'occuppe de la maintenance back end. Mais comme je dis, c'est surtout que j'y connais pas grand chose donc je suis peureux mais je suis vraiment ouvert en fait!
- simple is beautiful, AMEN!
- messagerie SMS : probablement la connexion la plus fiable (quoique) et la plus accessible pour les serres, si on trouve du hardware qui fait la job, je dis oui!!! Et toute la maintenance est assurée par les compagnies de téléphone (qu'on paye évidemment) mais ça nous enlève de la job!

- une autre possibilité : les devices qui acheminent l'internet via l'alimentation électrique. Vieille technologie super fiable apparemment. Et pas trop cher, genre 70-100$? Un RPi serait un bon candidat alors parcequ'ils ont un port ethernet intégré et peuvent se brancher au arduino via usb sans autre hardware nécessaire. Aussi le raspberry pi a le bluetooth intégré alors ça se programme facilement via un téléphone.
- une autre alternative : le LoRa pour communiquer entre la serre et un ordi branché au réseau internet, ou un ordi qui agit comme serveur. Ça marche pas à plus d'1 km mais c'est quand même à considérer!
- côté H-bridge faut se méfier parceque c'est sensible aux surtensions et au problèmes de dissipation thermique. C'est donc un potentiel weak spot si on design mal notre affaire, mais toi Yoan, t'auras pas trop de mal à figure out ce côté-là je suis certain. :)
Faut juste penser limiteurs de courant, heatsink, varistors/TVS et remplacement en cas de chip défectueuse.
Pour ce 3e point j'aime beaucoup le format DIP, j'avais trouvé cette chip prometteuse mais je l'ai brûlé par manque de protections : https://www.digikey.ca/product-detail/en/stmicroelectronics/L6206N/497-4211-5-ND/725435
C'est un h-bridge double donc on peut doubler ses specs en utilisant les 2 h-bridge en parallèle. C'est 10$ la chip mais ça a le potentiel d'avoir une durée de vie de 100ans si on design ça bien et encore moins cher qu'un relais+socket!
Côté prog, j'ai beaucoup de reformattage à faire pour intégrer l'option pwm dans le contrôle des moteurs, donc je laisserais quand même possible l'option on/off à court terme, mais c'est entièrement possible et on peut caller la shot d'avance en intégrant une switch ou un jumper sur le circuit pour envoyer le signal aux sorties PWM plutôt que digitales.
En passant, j'ai demandé un budget de 5000$ pour cet hiver pour prototypage. À auto-financer par la suite en vendant des prototypes mais quand même, ça pourra nous donner du lousse!

LoupHC, 2018-12-13:
- sinon alternative au format DIP, si on veut plutôt acheter un module, je m'imaginerais des headers femelles dans lequel on emboîte le module, comme le module d'horloge dans le contrôleur actuel.
- aussi, parlant de chips, avec un simple switch (MCP23008 à MCP23016), on pourrait contrôler 16 sorties plutot que 8 sans changer quoi que ce soit au code!

yoangp, 2018-12-18:
Suite/réponse Yoan:

-Plateforme hardware Arduino Mega + Raspberry Pi: Je trouve dommage qu‘il n‘y ait pas de meilleure option dans un kit complet. Il me semble que juste organiser nous même la communication entre le mega et le pi est un bon projet en soi. Mais bon, sinon il y a l‘option Arduino mega + shield wifi, mais je pense que ça serait limité pour les interactions avec le web. En tous cas, le projet farmbot open source utilise quelque chose qui ressemble à l‘arduino mega + r pi, donc on pourrait utiliser  ce qu‘ils ont fait comme inspiration.

-Acces point via le raspberry pi: Oui, c‘est ça que je voulais faire. L‘idée c‘est d‘utiliser à la base un module raspberry pi qui a déjà du wifi intégré (ex raspberry pi modèle 3 a+ à 30$). Ensuite, établir un lien de communication entre le pi et l‘arduino. Ensuite installer un serveur web sur le pi. Ensuite, coder un interface web, qui est en fait comme un site web sur le serveur web du pi. L‘avantage; même sans connexion internet, tu arrives avec n‘importe quelle bébelle (laptop, tablette, smartphone), tu te connecte au réseau local du pi, tu ouvres un browser pis là il y aurait un interface ultra simple qui permet de voir ce qui se passe sur l‘otomate (l‘équivalent de ce qui est affiché sur le lcd de l‘otomate 2018) et des boutons et champs de saisie pour faire l‘équivalent du clavier de l‘otomate 2018). Vu que ça serait dans un browser, on serait assez à l‘abri des changements technologiques à venir dans les prochaines.

-Messagerie sms: ça serait tellement simple, mais plus que je cherche, moins que ça avance. Les modules pas cher semblent utiliser une vieille technologie sur le réseau 2G. Ça serait mieux pour le futur d‘être sur le réseau 3G ou 4G, mais là les modules sont vraiments plus cher et vraiment overkill pour une simple petite fonction d‘envoie de messages textes. Je suis en train de me dire qu‘une alternative serait de passer malgré tout par le web ( si le web n‘est pas dispo à la serre, utiliser un vieux smartphone à vitre cassée obtenu gratuitement, le mettre en fonction hotspot, avoir une sim card avec un plan de données de base (15$/mois)., je pense que ça pourrait marcher, je me demande juste si la connexion serait fiable 24/7).Ou internet via le filage 120vac comme tu dis. Bon, admettont qu‘on a une connexion internet, on utilise un service genre pushingbox.com. Ça coûte rien, pi ça forward des messages via courriel, mms, etc.

-Utiliser un vieil ordi comme serveur: je ne suis pas chaud à l‘idée. Je suis déjà passé par là lorsque je travaillais à hydro québec. Pour du service 24/7 ça marche vraiment mal car il y a toujours plein d‘affaires qui se passent à cause du système d‘exploitation. Ex,  updates automatiques qui ne sont pas vraiment automatiques, etc. Se lancer dans notre propre version de linux sur de vieilles marchines partout au québec, brrr, euh non merci! Pas simple, pas fool proof, probablement pas super

-simple is beautiful : je suis 100% d‘accord avec toi Loup. C‘est juste que c‘est pas évident de trouver l‘affaire simple qui va marcher 10 ans sans maintenance et qui va avertir quelqu‘un sur son cellulaire que de quoi ne marche pas dans la serre.

-En réponse à pourquoi se casser la tête pour envoyer des notifications sur smartphone si la majorité des fermiers sont toujours à la ferme? : Les cas de figure que je vois:
-Même en habitant sur la ferme, si c‘est toi le proprio tu va te promener pas mal pour plein d‘affaires. Achat de matériel, points de chutes, marché, sans compter les affaire perso comme épicerie, visites de famille, garderie, etc. Imagine, tu es parti de la ferme acheter de quoi en plein mois de mars, il n‘y a pas d‘employés à la ferme car trop tot en saison, la serre tombe en panne. Même avec une sirène de 120dB à la maison, ça va pas faire grand chose. Ça prend pas bien des heures avant que les semis de tomates capotent s‘il fait -10 degrés dehors et que la  serre ne chauffe plus.

-H bridge: Je pense que ça a le potentiel d‘être plus fiable et moins cher que relais + sockets. Pour la fragilité aux surtensions; on a déjà ps mal de stock fragile aux surtensions, dont nos power supply qui fonctionnent eux aussi avec des transistors de puissance. Donc de toute façon, il faut que tout notre système soit protégé des surtensions. Pour la dissipation de chaleur, les transistors du module que j‘ai chez moi peuvent prendre du 100A selon la datasheet. Donc les quelques ampères des moteurs 24V ne devraient pas être un gros problème. C‘est sur que dans le cas ou quelque chose bloque les moteurs ça va monter sérieusement les ampères, mais avec un mécanisme de protection, genre fusible ou autre, ça devrait faire l‘affaire avant que les transistors de puissances brulent par surchauffe  Pour l‘histoire des pwm, c‘est plus de trouble dans le code et pour les i/o (faut que ça soit une sortie pwm et pas juste une sortie digitale ). Par contre, les softs starts produits grace au pwm font que la demande de courant des moteurs au démarrage est vraiment beaucoup plus douce. On peut démarrer les moteurs de 0 à 100% de la vitesse en genre 5 secondes plutot que 100% en 1/10 de seconde s‘il n‘y a pas de pwm.

- Cool pour le prêt de 5000$ à la capé, tiens moi au courant si ça marche.

Thread 57 (2018-12-13):

Gestion climatique fancy

LoupHC, 2018-12-13:
Hey folks!
Je pars un nouveau fil de discussion, sinon ça ne sera plus lisible.
Je voulais vous partager les affaires intéressantes que j'ai appris pendant la formation avec Climax :

- contrôle de l'humidité :
Apparemment, l'humidité relative n'est pas perçue par les plantes de la même manière que nous. Ce qui permet aux plantes de bien transpirer, c'est plutôt le degré de saturation de l'air en eau. Donc, la quantité maximale d'eau que peut contenir l'air (en g d'eau /m3) moins l'humidité absolue (g/m3) qui donne le déficit d'humidité. C'est le déficit d'humidité qui est perçu par les plantes, qui régule la transpiration. Exemple, à 15C, l'humidité maximale qu'on veut tolérer serait de 75%, contre 90% à 30C. Vu que le chauffage c'est une pas pire dépense, ça voudrait la peine d'inclure cette variable dans la logique de déshumidification.
C'est assez facile de faire la conversion HR à déficit d'humidité, donc je voudrais l'inclure aux overrides de deshumidification.
Aussi il y a deux façon de faire baisser l'humidité dans une serre, soit ventiler jusqu'à ce que le chauffage parte, soit chauffer jusqu'à ce que la ventilation ou les rollups embarquent. Mais ça prend absolument un combo chauffage ET ventilation

- température vs luminosité :
En ce moment, on peut préprogrammer un programme Soleil et un programme Nuage. Pour permettre plus de flexibilité, je voudrais intégrer une variable de pourcentage pour qu'on puisse se situer entre les deux. L'intérêt, aussi, c'est que l'augmentation de la température cible de jour se fait linéairement à la luminosité globale. On serait en mesure de définir une gradation de la température cible à partir d'une variation de luminosité, mesurée par n'importe quelle photocell cheap, qui peut-être calibrée sur place.
Exemple, si le sensor envoit la valeur 800 quand il fait soleil et 200 quand il fait nuageux. On associe 200 à la température Nuage et 800 à la température Soleil et on laisse la température osciller entre les deux en fonction de la luminosité mesurée par le sensor.

- température de nuit : comme il n'y a pas de luminosité la nuit, la température de nuit varie plutôt en fonction de la moyenne de luminosité quil y a eu pendant le jour. Plus ya de la lumière pendant le jour, plus la température de nuit doit être haute. Dans la même logique, on pourrait se positionner entre la température Nuage et Soleil selon si la moyenne de luminosité (mesurée par la photocell) se situait plus du côté Nuage ou Soleil.

Avec ces fonctionnalités, on serait pas loin de supprimer la daily task de pitonner sur le contrôleur selon notre guess météo. On tombe plus à 3-4 modifications par saison pour suivre la charge en fruit, plus quelques modifications pour affecter l'équilibre végétatif/reproductif, le suivi des overrides et... thats it!

jayserf, 2018-12-16:
Great reflection!

I'm a fan, and I was at the second half of that session. It made me want
heated beds and a positive pressure winter ventilation...

Would like to discuss further

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

Thread 58 (2018-12-18):

Aide d‘étudiants pour faire avancer le projet?

yoangp, 2018-12-18:
Ça serait peut-être le temps d‘essayer d’utiliser l’otomate pour lancer un projet de session pour les étudiants en génie électrique/informatique de l‘université de sherbrooke! On pourrait leur donner comme mandat de coder une partie de la communication entre le mega et l‘arduino ou de coder un interface via le serveur web du Raspberry pi...

Si vous me donnez votre accord, je pourrais regarder ça. Pour être passé par là, ça ne coute pas grand chose. Il faudrait peut-être fournir un peu de matériel (arduino, r pi, etc.), mais on pourrait s‘en tirer pour vraiment pas cher d‘après moi. Les étudiants ne sont pas rémunérés. Normalement, ils ont un nouveau projet pour la session d‘hiver qui commence en janvier. Une compagnie, ex capé, peut proposer un projet à réaliser et si ça fonctionne il y a environ 5 étudiants qui vont passer pas mal de temps là dessus pendant 15 semaines.

LoupHC, 2018-12-18:
Nice super bonne idée!
Si on se lance dans la micro-batch de prototypes cet hiver, j'ai demandé un 1000$ de budget prototypage si ça passe ça pourrait passer là-dedans.

yoangp, 2018-12-19:
En date du 19 décembre, il est trop tard pour soumettre un projets pour la prochaine session à l'Université de Sherbrooke.
En attente d'une réponse du CEGEP de Sherbrooke. Ils ont aussi des projets de fin d'études.

yoangp, 2019-01-04:
Réponse du CEGEP de Sherbrooke:

"Le processus de choix de projets de fin d'études débute dès le mois d'août. Il est donc trop tard pour cette année.
Si les délais occasionnés vous sont acceptables, je vous invite à nous recontacter dès le mois de juin.
Merci de votre attention."

Nicolas Huppé
Coordination TGE
819-564-6350 -4092

yoangp, 2019-01-04:
Réponse de l'université de Sherbrooke:

"Les soumissions de projets doivent se faire avant le mois de novembre de chaque année sur le lien suivant : https://www.usherbrooke.ca/gelecinfo/fr/divers/prop-prj/ "

Ghania Sarah FARHI, Ph. D.
Coordonnatrice académique
coordgegi@usherbrooke.ca
Département de Génie Électrique et de Génie Informatique
Faculté de génie
Université de Sherbrooke
Sherbrooke (Québec)

Canada J1K 2R1
Tél: (819)821-8000, poste 63844
Local: C1-3059

Thread 59 (2019-01-09):

Obtenir du financement du fédéral

yoangp, 2019-01-09:
Suite à une conversation avec Geneviève Legault du MAPAQ:

CRSNG

Pour développer une innovation et obtenir du financement fédéral pour de la recherche et développement, vous pouvez contacter Robert Deziel 514-496-4746 robert.deziel@nserc-crsng.gc.ca

http://www.nserc-crsng.gc.ca/Business-Entreprise/FundingPrograms-ProgrammeDeSubventions/index_fra.asp

Vous pouvez retrouver les CCTT sur le site de Transtech http://reseautranstech.qc.ca/

Possible d'aller chercher 25000$ sans contribution de l'industrie. 90% de chance de financement.

LoupHC, 2019-01-10:
Et qu'est-ce qu'elle dit par rapport à Innov'Action?

Thread 60 (2019-01-14):

Plan d'action 2019

LoupHC, 2019-01-14:
Bon!
Suite à une discussion qu'on a eu Yoan et moi, on a abandonné l'idée de faire subventionner le projet avec Innov'Action, qui répondait pas vraiment à notre situation et nous aurait probablement plus limité qu'autre chose dans ce qu'on voulait faire.
À moins qu'on trouve du financement autre, il nous reste une alternative : on auto-finance le projet en majeure partie!

Voici comment je pense qu'on pourrait procéder :
- on planifie le temps nécessaire pour arriver à une deuxième itération (finale?) de l'Otomate
- on répartit ça en fonction du temps qu'on peut mettre à contribution au projet pour se faire un calendrier
- on évalue l'impact sur le prix des contrôleurs en fonction du nombre d'unités produites si on rémunère le temps de développement à mettre
- on réajuste nos objectifs en conséquence au besoin
- on présente le dossier à la CAPÉ

Les objectifs mentionnés à date:
- améliorer le design existant essentiellement pour réduire le filage et la complexité d'assemblage
- améliorer les fonctionnalités et le rendre plus facile à programmer
- arriver à un circuit standard "universel" à faible coût que les gens peuvent assembler eux-même
- mettre en place un système qui réduit au maximum les besoins de soutien technique
(idée proposée : avoir quelques circuits de rechanges à échanger contre un circuit défectueux, qui pourrait être revendu comme réusiné après réparation)

Je propose ce document comme point de départ  :
https://www.dropbox.com/ow/msft/edit/home/autoconstruction_private/autoconstruction%202019/projet-Otomate/Plan%20d'action%202019.xlsx

yoangp, 2019-01-15:
Super bon point de départ pour 2019!

Ajouts:

- Une méthode efficace de travail serait d'établir le minimum à faire pour avoir une prochaine version testable puis vendable. Quitte à laisser des améliorations pour une version 3, 4, etc.
- Jusqu'à ce que je trouve un emploi temps plein, je peux mettre 1 jour/semaine sur le projet.
- Comparer la version 2 de l'Otomate avec les autres produits sur le marché.

yoangp, 2019-01-16:
J'ai fait plein d'ajouts dans le fichier Excel sur DropBox dont un budget prélininaire de vente, comparaison de coût de contrôleurs et features de chacuns.

Thread 61 (2019-01-16):

Mission du projet

yoangp, 2019-01-16:
Allo Loup,

Il faut qu'on s'élabore une mission commune du projet. Il faudrait idéallement que ça soit un concensus, ou au pire un compromis ;-) Ça va juste nous aider à viser le même objectif de  travail.

Suggestion de Yoan:
Mission du projet Otomate 2019: Produire un contrôleur de serre économique pour les fermes du Québec tout en permettant de générer un revenu acceptable (20$/heure).

Mission du projet Otomate long terme: Moins clair pour moi, ça a l'air un peu bizarre que l'objectif soit juste de vendre moins cher que la compétition sur la base qu'on se paye 1/3 du salaire des employés du secteur. Pour moi ça reste important d'aider les fermes à être plus profitables en ayant moins de dépenses, mais plus qu'on fait de développement et plus qu'on ajouter des fonctions, plus qu'il faudrait qu'on demande un prix élevé pour repayer le développement. On a aussi un retard par rapport aux autres entreprises établies. Surtout que jusqu'à preuve du contraire nous n'apportons rien de réellement nouveau avec notre projet.

Qu'est-ce que tu en penses?

LoupHC, 2019-01-17:
Pour la mission générale, je pense que ce sont ces éléments qui nous distinguent essentiellement :
- électronique réparable : c'est un concept presque inexistant de nos jours! C'est bon pour l'environnement et c'est bon économiquement pour l'acheteur. qui n'aura pas besoin de payer 1000$ dans 5 ans pour remplacer le circuit au complet, juste 10-20$ pour une commande en ligne.
- open source : contrôleur "hack friendly" qui permet d'ajouter des fonctionalités sur mesure aux besoins de ta ferme. En partie grâce à des acces points sur le circuit et une librairie pour la programmation facile d'utilisation (working on it!).
- non "hardware specific" : possibilité d'utiliser n'importe quel capteur ou presque disponible sur le marché et de le rendre compatible avec le contrôleur. Pas de surcoût associé à des modules spécifiques comme la station météo du iGrow à 2000$.
- "in the field" development : développement fait sur une multitude de fermes au Québec et qui cumule l'expérience de plusieurs producteur.trice.s
- projet de la CAPÉ : une partie des revenus financent la coop

Thread 62 (2019-01-17):

PCB Otomate 2019

yoangp, 2019-01-17:
Allo Loup,

Première ittération, juste pour le placement des affaires. Des commentaires?

Je sais que c'est pas encore le bon moment de faire ça, mais ça me tentait :-)

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

- Pour l'instant il y a 6 relais, mais dans le fond, pour la ventilation forcée, ça peut être juste une sortie 24V pour un SSR à l'extérieur du board et pour l'alarme sonore à première vue le chip ULN2075 pourrait aussi supporter l'activation de l'alarme sonore. Ce qui veut dire qu'on a besoin de 4 relais pour les côtés ouvrant, 1 pour le chauffage .. et 1 de spare pour l'instant.

- Sw man sur le dessin c'est pour les switch d'ouverture manuelle des côtés ouvrant en cas que l'Arduino est caput.

LoupHC, 2019-01-17:
Ouuuh... c'est excitant ça! Ça fait popopopopop dans ma tête!
- Relais : l'alarme doit être sur un relais parcequ'elle fonctionne en mode normalement fermé. J'ai cherché désespérément l'an passé une façon de faire un circuit normalement fermé avec des transistors et j'ai rien trouvé. Un avantage d'avoir un relais c'est qu'on peut installer une alarme plus beaf sans se soucier des limitations de courant. On doit prévoir un input de batterie sur le board aussi, peut-être un barrel jack avec qqchose comme ça :

- switchs de version : 100% d'accord de les enlever, en plus je m'étais trompé dans les footprints... si on veut garder le circuit compatible sans pièces supplémentaires (d'un coup que...), on peut utiliser les pins SDA-SCL communes au mega et au uno, en haut à droite du board.
Je vois surtout ça utile si quelqu'un veut ajouter un shield arduino au circuit, autrement ça va déconnecter les pins sda-scl situées au bas du mega.
- switchs manuelles : je trouve que c'est vraiment une bonne idée que les switchs soient situées à droite du board! Comme ça, ça évitera que de la terre tombe sur d'autres composantes si quelqu'un taponne sur le circuit. De la même manière, toute les pièces qui entrent en contact avec les doigts devraient être en bas ou sur les côtés du board. Pour cette raison je déplacerais le bus de connecteurs située en haut du circuit plutôt à gauche mettons en face des relais.
- SMT : d'accord pour enlever ces pièces, surtout le logic level shifter. C'était pour communiquer avec des devices 3.3V mais finalement on peut communiquer avec le raspberry Pi via USB donc c'est plus tant nécessaire. Au pire adafruit vendent des LLS très bien faits qui pourraient être soudés à l'extérieur du board.
La seule pièce plus touchy c'est le sensor de courant(ACS723), qui est aussi SMT. On pourrait la remplacer par un socket pour un module chinois de current sensor, mais faudrait mettre un renfort mécanique pour le tenir en place, parceque ça tiendrait juste sur 3 pins. Je me disais peut-être des trous dans le board pour passer un ti-wrap?
Je garderais ce feature-là par contre, les fusibles 1.5A, c'est une solution moyennement fiable actuellement je trouve. Ça serait beaucoup mieux avec un fusible électronique et tous les fermiers à qui on en a parlé trouvent que c'est une bonne idée.
- ça sera pas de problème à changer dans le code... par contre, ça introduit un risque électronique qu'on pourra difficilement tester sans oscilloscope... et même là ça pourra différer selon la longueur de la serre. D'ailleurs, le driver de relais sur le board sert à isoler le 24V du 5V, si on les connecte ensemble par l'alimentation ça diminue la pertinence d'une telle protection. J'ai fouillé intensément le sujet l'hiver apparemment c'est impossible d'isoler complètement deux parties de circuit qui ont un contact galvanique (fancy word pour contact physique via un conducteur) sans un circuit filtre fait sur mesure. Ça laisse les transfos et les optocouplers pour une séparation fiable.
C'est pour ça que deux alimentations, c'est une bonne solution je trouve, vu qu'il y a un transfo qui sépare physiquement les deux circuits.
Et un bloc d'alimentation 5V que tu branches dans le mur ça coute genre 5$, je pense que c'est une bonne alternative au power supply qui nécessitait de faire entrer le 120V dans le boitier. Faudrait juste ajouter un barrel jack au circuit.
- pour la limitation de courant, la solution la plus facile que j'ai trouvé à date c'est d'intégrer une chip LM317 en amont de l'alimentation des relais.
C'est une chip super vieille donc probablement jamais obsolète et le circuit est très simple : http://www.bristolwatch.com/ccs/LM317.htm
Par contre, faudra booster le voltage d'entrée parcequ'il y a un voltage drop de quelques volts. À tester sur le breadboard évidemment.
- switchs sensors : ce sont des switchs pour activer/désactiver les pullups des sensors, pour diminuer la consommation en courant du board de quelques mA... pas très utiles finalement on pourrait les enlever.
- petite nouveauté apprise aujourd'hui : une des causes principale de corrosion sur les circuits apparemment, ce sont les fuites de batteries de RTC. Je la placerais donc le plus possible en bas du circuit.

LoupHC, 2019-01-17:
- Pour le clavier sur le PCB, on dirait que j'ai un doute... c'est quand même la partie du circuit qui sera utilisée la plus régulièrement, contrairement aux overrides switchs, donc ça implique beaucoup d'ouvertures de boitiers...
en faisant quelques recherches ce matin je suis tombé sur ce module et je trouvais l'idée pas pire, peut-être qu'on pourrait la reproduire sur notre board?
Le circuit est super niaiseux...
https://www.amazon.com/Arduino-Keypad-Shield-16-Button-Matrix/dp/B06XGSYP1C
Sinon faudrait au moins traiter l'ensemble du circuit avec un conformal coating ou qqchose du genre, je sais pas si ça peut être compatible avec les morceaux montés sur des sockets? Ou encapsuler d'une certaine façon la partie du circuit où les gens ont pas d'affaire à mettre leurs doigts.

LoupHC, 2019-01-17:
En format DIP! You got me...

yoangp, 2019-01-19:
Comment tu pensais faire pour potentiellement brancher un shield pour Arduino uno sur le PCB de l'Otomate? Il me semble que physiquement c'est assez coincé, en dessous du PCB c'est pas une super bonne idée, à côté du mega il y a pas ben ben de la place, sinon au-dessus du mega il faut des headers 2 fois la hauteur normale... Aussi, quels shields avais tu en tête pour un développement futur? WiFi?

LoupHC, 2019-01-19:
Je pense à certains shields comme le shield de carte SD ou un shield LoRa, qui seraient assez minces pour glisser entre le MEGA et le board... c'est du hardware qu'on n'aurait pas besoin de développer dans le futur.
Par contre ça impliquerait qu'on n'utilise pas directement les pins spécifiques au MEGA, mais à date on en a pas vraiment besoin, c'est surtout pour sa mémoire qu'on en a besoin.

yoangp, 2019-01-19:
Mais les shields qui pourraient se glisser entre le Mega et le PCB du contrôleur sont presque tous avec un pinout pour Arduino uno...

En regardant tout ça, je me dit que mettre des headers en extra ailleurs sur le board pour faire un pinout pour shields standard Arduino serait peut-être la meilleure option. On peut déja sauver un peu d'espace si on utilise un shield RTC + SD card qui fait une pierre deux coup (https://www.adafruit.com/product/1141).

LoupHC, 2019-01-19:
En fait le pinout du UNO est compatible avec le MEGA mais pas l'inverse...
(c'est un peu comme l'histoire du rectangle et du carré...)
La seule contrainte c'est qu'il faut utiliser les points de connexions communs aux deux, par exemple utiliser les connexions sda-scl situées en haut à droite du board et le connecteur SPI situé au milieu du board, et ne pas utiliser les ios spécifiques au MEGA (pins 14-53 et A6-A15).

yoangp, 2019-01-19:
Ok, je commence à comprendre l'affaire, donc plusieurs pins du Mega ne pourraient pas être connectés au pcb du contrôleur s'il y avait un shield entre les deux.

Est-ce que tu penses qu'à ce moment-là on devrait utiliser le plus possible le bus I2C pour étendre le nombre de pins de communications sur le pcb du contrôleur?
Une autre option serait de mettre des headers male-femelle pour faire la liaison des pins du mega avec ceux du pcb du contrôleur. Genre de même mais à la bonne place sur le mega..:
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

LoupHC, 2019-01-19:
Oui ça peut-être une option au besoin!
Par contre en ce moment, vu qu'on utilise I2C pour les sorties de relais, on utilise seulement les IOs pour les entrées de sondes, et donc on rentre encore dans le pinout du UNO.
Si on stick avec cette idée là (utiliser i2c pour les relais) je pense qu'on n'aura pas à se soucier de ça!

yoangp, 2019-01-20:
Allo!

Diagramme fonctionnel du pcb:
https://drive.google.com/file/d/1FTgodYRJLH3-fwumSEWBMR_UVwzgNT04/view?usp=sharing

jayserf, 2019-01-20:
Nice!

good thread. and sweet functional diagram!

for conformal coating, if we put any, we wont be able to replace and DIP
parts! it's like epoxy, super nasty to remove and solder around. I think
it's better to either choose SMD and reduce production costs, while keeping
all 'burnable' components DIP, thereby keeping production costs low (DIP =
way more expensive to have subcontracted) and use some epoxy coating
OR
use DIP, no epoxy, keep repairability high and easy of assembling a 'kit'
and prototypes, (although really SMD soldering is not too hard, as long as
parts sizes are not super small. 0805 and SOIC are ok by hand!

If no epoxy, we must limit opening the box as much as possible. so keep the
keypad on the outside.

for the screen, I like it on the board. we can get a box with a window
perhaps...

i found some cool options that can fit more info perhaps and give loup a
sweet programming challenge!

https://www.aliexpress.com/store/product/3-5-480-320-HMI-Intelligent-Smart-USART-UART-Serial-TFT-LCD-Module-Display-Panel-for/900905_32910475160.html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

https://www.aliexpress.com/store/product/Real-OLED-Display-2-42-128-64-12864-SPI-I2C-IIC-Graphic-LCD-Module-Screen-LCM/900905_32920778860.html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

found the number pad!
https://www.aliexpress.com/store/product/4x4-Matrix-Keyboard-Keypad-Module-Use-Key-PIC-AVR-Stamp-Sml-4-4-Plastic-Keys-Switch/2130127_32831963425.html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

I would like to propose in future how we can share the weather station data
to other greenhouses to avoid needing weather station at each greenhouse in
the case of a farm with 2-4+ GH's...

I ordered some Lora radios for future tests...

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

yoangp, 2019-01-20:
Je vais commencer à ouvrir des issues pour chaque élément afin de faciliter le suivi.

yoangp, 2019-02-19:
Allo!

Ça avance, ça avance!

Bon, mise à jour:

- Le dossier du projet KiCAD zippé à jour est dans dropbox.

- J'ai remis exactement le même circuit crow bar + régulateur de l'ancien Otomate. Le LDO dont tu parlais Loup avait pas mal de pièces à mettre autour et j'étais vraiment pas convainçu que ça marcherait du premier coup le circuit. J'ai fouillé pour autre chose, rien d'intéressant. Pour une différence de drop out de genre 0.1V, trop de trouble pour rien je trouve. Je pense que j'ai juste changé la Zener pour une 5.6V sur le circuit crow bar. Je voulais plus bas, mais en dessous c'est 5.1V et avec le % de tolérance ça peut donner 4.99V... Donc tant pis, 5.6V.

- J'ai mis le connecteur pour le module Lora

- Pas vraiment d'importance mais j'ai finalement compris comment fonctionne les librairies et j'ai fait un ménage. La seule chose, c'est que j'ai l'impression que tu avais 100% des pièces dans ta librairie custom l'année passé right? J'imagine l'idée c'est d'éviter qu'une mise à jour des symboles de KiCAD fassent le bordel. Pour l'instant j'ai encore quelques pièces des librairies globales de KiCAD.

- J'ai pas encore mis un header pour le ACS723. Je me demande si ça va être du trouble de demander à PCBWay de souder les chip sur les mini pcb que j'ai trouvé vu qu'on peut pas vraiment faire de stencil.. En tout cas, je vais faire ce changement et on verra.

- Prochaine étape: Associer les bons footprints, placer et router. J'ai bon espoir que je vais pouvoir réutiliser pas mal de ton design de l'année passée pour le pcb, j'ai fait un test et KiCAD essaie autant que possible de garder le layout des pièces commes avant.

Ciao!

yoangp, 2019-02-24:
Début du BOM dans différents feuillets du document Otomate V2 - BOM.xlsx sur dropbox...

yoangp, 2019-02-27:
- J'ai ajouté le 8ième relai au schéma et pcb et remis le projet kiCAD sur Google Drive..
- J'ai mis les bons mounting holes, mais il faut les positionner et faire le cadre de découpage du pcb de manière à ce que ça rentre pas trop serré dans la boîte Polycase YH-100804.

yoangp, 2019-03-29:
Allo Loup,

Je pourrais être rendu à faire le routing du PCB. Est-ce qu'on attend pour d'autres features ou pas? Je vote pour qu'on avance et que je passe tout de suite au routing dès que j'aurais un peu de temps dans les prochaines semaines.

LoupHC, 2019-03-29:
Ben d'accord avec ça!!
Si j'ai le temps cette fin de semaine j'ajouterai un circuit à pushbutton
pour le module d'alarme, ça marche assez bien sur le breadboard chez nous.
Mais oui ben partant qu'on commence ça!

Le jeu. 28 mars 2019 à 21:23, yoangp <notifications@github.com> a écrit :

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

yoangp, 2019-03-29:
Ok, je te laisse regarder ça en fin de sem, moi je vais continer à partir
de la sem prochaine. Ciao!

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

Thread 63 (2019-01-17):

Manque librairie pour schéma KiCAD

yoangp, 2019-01-17:
Loup,

Il manque une librairie dans les fichiers KiCAD (image ci-dessous), est-ce que tu pourrais l'ajouter dans les fichiers KiCAD sur GitHub?

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

LoupHC, 2019-01-17:
Snaps... je me mets là dessus

LoupHC, 2019-01-17:
C'est bizarre... il me dit qu'il manque les librairies, mais en vrai il arrive à ouvrir le fichier quand même...

LoupHC, 2019-01-17:
Shit je pense qu'ils ont changé le système de librairies pour les footprints... par une méthode plus compliquée qu'avant... mais les fichiers sont encore là.
Je vais les archiver sur github ça va être plus simple à l'avenir.

LoupHC, 2019-01-17:
J'ai mis à jour KiCad (passé de 4.0 à 5.0) et maintenant j'ai plus de problème avec les footprints. Par contre, c'est plus compatible avec KiCad 4.0...
J'ai reploadé ça dans une branche à part : KiCad-edit-2019
On pourrait mettre nos modifications là-dessus en attendant d'avoir qqchose qui vaut la peine d'être updaté!
Si tu mets à jour ta version est-ce que ça te pose encore problème?

yoangp, 2019-01-17:
Cool! Résolu de mon côté aussi avec KiCAD V5 et la version mise à jour du projet (KiCad-edit-2019)

Closed 2019-01-17.

Thread 64 (2019-01-17):

Plan d'action 2019 - nouvelles fonctionnalités

LoupHC, 2019-01-17:
J'ai retrouvé le sondage qu'on avait fait l'an passé par rapport aux priorités de développements, on demandait une note de 1-8 (un : très important, 8 : pas du tout).
- Monitoring : 5
- Contrôle via internet : 4
- Modulation selon température extérieure : 4
- Cycles de deshumidification : 3
- Fermeture en cas de pluie : 2
- Fermeture en cas de vent : 2

Voici les conclusions que j'en tire :
- les fonctionnalités essentielles ++, ce sont celles qui sont liées directement à préserver la serre en bon état de marche (pas noyée dans l'eau, pas arrachée par le vent).
- en deuxième, ce sont celles directement liées à la conduite des cultures (bonne gestion de l'humidité, pas de coups de froid)
- en troisième, celles qui facilitent la vie (contrôle et monitoring via internet)

Un autre facteur qui peut nous orienter dans le choix de fonctionalités à prioriser, c'est "est-ce qu'un autre produit présent sur le marché peut jouer ce rôle?".
- Dans le cas de l'irrigation par exemple, ça pourrait être intéressant de la contrôler direct du contrôleur (et faisable), mais comme il n'y a pas d'interaction entre le contrôle du climat et l'irrigation, ça peut valoir la peine d'utiliser une alternative déjà existante et bien conçue (rainbird ou openSprinkler par exemple)
- Dans le cas du monitoring, il y a aussi des alternatives comme AcuRite qui sont vraiment pas chères et qui peuvent jouer ce rôle.

Je suis bien avancé du côté des overrides, ça devrait nous donner un gros éventail de possibilités. Cet hiver, côté fonctionnalités, je mettrais l'emphase là-dessus : station météo et gestion de l'humidité.
C'est pas mentionné dans le questionnaire mais l'interface a aussi beaucoup besoin d'être améliorée, ça serait ma deuxième priorité.
Vous en pensez quoi?

yoangp, 2019-01-17:
- Je suis d'accord avec les priorités de développement.

- Loup, tu es vraiment confiant qu'on peut intégrer la station météo cette
année? Si c'était moi, je viserais d'intégrer en premier le kit vraiment
pas cher de Sparkfun dont tu m'avais déjà parlé (
https://www.sparkfun.com/products/8942). On parle donc surtout de vitesse
du vent et quantité de pluie pour la météo n'est ce pas? La direction du
vent est moins critique, bien que ça peut être utile de savoir de quel côté
la serre peut s'ouvrir même en conditions assez venteuses.

- Faire en sorte que les cycles de déhumidifications marchent pile poil est
aussi un must évidemment. Je l'ai appris à mes dépend l'été dernier avec du
blanc à grandeur, entre autre à cause de zéro gestion de l'humidité. J'ai
perdu 0,5jr/semaine à appliquer des produits pour controler le blanc sans
impact notable. Est-ce que tu as un capteur d'humidité en tête? J'ai pensé
à faire un montage bulbe sec, bulbe humide avec 2 capteurs de températures
qu'on utilise déjà, Danny disait que c'est la méthode la plus fiable (mais
il faut s'assurer qu'il y a toujours assez d'eau pour le capteur,
apparement aux 2 semaines environ pour un petit réservoir d'eau, facile à
oublier cette tâche répétitive...).

- Je vais ajouter cela dans les fonctions de l'Otomate 2019 pour le sondage
à venir.

Le jeu. 17 janv. 2019, à 12 h 01, LoupHC <notifications@github.com> a
écrit :

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

LoupHC, 2019-01-17:
Pour le code, je suis pas trop inquiet, c'est le hardware qu'il faudrait absolument tester cet été...
Pour la station météo, je pensais réutiliser le code de ce gars-là :
http://cactus.io/projects/weather/arduino-weather-station
Et du coup, utiliser les mêmes capteurs serait le plus simple.
Le capteur de pluie qu'il utilise est très bien fait, on l'utilise à la ferme avec le iGrow, et on peut programmer directement sur le module plusieurs degrés de sensibilité.
Pour l'anémomètre, la différence de coup est quand même importante, on parle de 150$ vs 80$ (avec un capteur de pluie en bonus).
Je me demande si la différence de qualité en vaut le cout, les commentaires sont ambigus pour les deux modèles...

LoupHC, 2019-01-17:
Pour la deshumidification, ya un gars qui était à l'atelier, Simon Leduc, qui a fait un capteur bulbe humide/bulbe sec avec arduino, faudrait le contacter pour avoir son code!
Sinon le plus simple à installer serait un capteur digital, mais moins fiable et plus cher comme tu dis.
Je vais m'arranger pour que le code soit compatible avec les deux options.
La logique de contrôle évidemment serait la même.

yoangp, 2019-01-17:
Pour la sation météo, d'accord avec toi que le montage sur cactus.io et le capteur de pluie semble vraiment bien et pas cher. C'est juste l'anémomètre que je trouve cher à 150$, même si ça a surement à voir avec la qualité de la patente...

Je pense qu'on pourrais trouver un anémomètre (sans la direction du vent) pour moins cher, ex: https://www.amazon.ca/Sensor-Anemometer-Signal-Aluminium-Alloyed/dp/B07F6Z15N9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

yoangp, 2019-01-19:
Bon, j'ai repensé à la station météo et voici ma proposition; il y a deux setup possibles selon le budjet:
1. Kit Sparkfun pour 77$US (Économique)
2. Anémomètre et girouette Davis + Hydreon RG11 pour 214$US (Haut de gamme)

Les deux setup sont assez similaires:

Kit sparkfun:
Anémomètre : switch à on à chaque rotation
Girouette: array de résistances 0-120kohm
Rain bucket: switch on lorsque bucket se vide à 0.2794mm de pluie
Datasheet: https://cdn.sparkfun.com/assets/8/4/c/d/6/Weather_Sensor_Assembly_Updated.pdf

Davis instruments:
Anémomètre: Switch à on avec contact au ground à chaque rotation
Girouette: potentiomètre 0-20kohm
Datasheet: https://www.davisinstruments.com/product/anemometer-for-weather-monitor-or-wizard/
Hydreon:
Rain sensor RG11: switch on à chaque fois équivalent de .2mm de pluie (plus de précision disponible avec autre setings). Nécessite alim 12Vdc et 55mA
Datasheet: http://hydreon.com/wp-content/uploads/sites/3/2015/documents/rg-11_instructions.pdf

**Donc, en bref pour les différences:**
- Les deux anémomètres peuvent fonctionner comme entrée digitale 0-5V, il faudra juste avoir un paramètre de de convertion dans le code pour durée entre pulses par km/h de vent. Rien du côté hardware à part qu'il faut que le pulse soit une valeur à 0 (ground), à 1 le reste du temps car le modèle Davis est conçu ainsi, sur le modèle Sparkfun ça ne fait pas de différence.

- Les deux girouettes peuvent fonctionner sur une entrée analogique 0-5V, il faudra avoir une table de convertion dans le code pour entre x et y voltage = z direction du vent. Côté hardware, il faudra une switch entre deux valeurs de résistances selon la girouette qui est branchée.

- Les deux capteurs de pluie peuvent fonctionner sur une entrée digitale 0-5V, il faudra avoir un paramètre de convertion dans le code pour 1 pulse = x mm de pluie car c'est différent entre les deux modèles. Côté hardware, pas de problème pour une entrée digitale 0-5V. La grosse différence c'est que ça prend du 12V sur le board pour alimenter le Hydreon.. Donc on pourrait mettre un autre DC-DC converter, au moins celui là serait pas trop cher car genre 100mA serait suffisant. D'un autre côté il y a quand même souvent des pièces disponibles sur 12VDC, mais pas tant sur 5VDC ou 24VDC. Donc ça nous ferait une source 12V disponible pour d'autres affaires dans le futur (ex. un design de H-bridge prometteur (+ de 10A sur 24VDC pour les moteurs) fonctionne avec des inputs de contrôleur 0-5V, mais les drivers de mosfets ont besoin de 12VDC).

LoupHC, 2019-01-19:
La sonde de pluie optique a aussi la possibilité de fonctionner en mode actif quand il pleut, inactif quand il ne pleut pas, ce qui rend la programmation très facile à implémenter. Par contre, j'avoue que c'est intéressant de connaître les précipitations, comme avec une station météo normale.
Je pense aussi qu'on devrait chercher à être compatible avec plusieurs hardwares différents, ça devrait pas être trop de trouble à programmer!

LoupHC, 2019-01-20:
Nouvelles fonctionalités implémentées aujourd'hui :
- mode semi-automatique pour le rollups, les fans et les fournaises (complètement ouvert, fermé ou à X% pendant Y minutes ou indéfiniment)
- override en fonction de l'humidité pour les fans et les fournaises
- override en fonction de la pluie pour les rollups
- override à heure fixe pour les rollups, les fans et les fournaises (de X heure à Y heure)

Programmable via l'IDE ou le tableau excel de programmation!

YOUPI!

yoangp, 2019-01-20:
Wow! Super cool Loup!! Pas de niaisage en fin de semaine!

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

jayserf, 2019-01-20:
for real!

way to go!

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

Thread 66 (2019-01-20):

PCB - Choix Écran

yoangp, 2019-01-20:
Allo,

J'ouvre cet issue pour toutes les discussions d'écrans.

Il y a différentes options de design qu'on peut suivre:
1. On réutilise au max le design précédant avec l'idée que dans une version future on mettra de l'effort pour avoir un interface cool via smartphone. Ça permet de pas perdre trop de temps sur cet élément.
2. On utilise un écran méga cheap, dans l'idée avec l'idée que dans une version future on mettra de l'effort pour avoir un interface cool via smartphone. Le but ultime étant de réduire au max le coût du produit à terme car l'écran et le clavier principal sera l'interface via browser web sur smartphone que tout le monde a déjà dans sa poche.
3. On met un écran touchscreen pour avoir juste 1 élément à intégrer. Désavantages: C'est une pièce qui coûte quand-même cher ( et possiblement pas moins cher que clavier et écran actuels). Pas super avec doigts méga sales de fermiers. Long à implenter.

Dans tous les cas je trouve qu'installer l'écran sur le PCB c'est pas compliqué, ça garde tout ensemble et avec un convercle de boîte transparent il est facile de voir que tout va bien dans la serre sans avoir à ouvrir la boîte.

D'autres options? Sinon, je vote pour l'option 1.

yoangp, 2019-01-20:
Copie du message de Jason sur la question de l'écran:

for the screen, I like it on the board. we can get a box with a window
perhaps...

i found some cool options that can fit more info perhaps and give loup a
sweet programming challenge!

https://www.aliexpress.com/store/product/3-5-480-320-HMI-Intelligent-Smart-USART-UART-Serial-TFT-LCD-Module-Display-Panel-for/900905_32910475160.html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

https://www.aliexpress.com/store/product/Real-OLED-Display-2-42-128-64-12864-SPI-I2C-IIC-Graphic-LCD-Module-Screen-LCM/900905_32920778860.html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

found the number pad!
https://www.aliexpress.com/store/product/4x4-Matrix-Keyboard-Keypad-Module-Use-Key-PIC-AVR-Stamp-Sml-4-4-Plastic-Keys-Switch/2130127_32831963425.html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

LoupHC, 2019-01-21:
Pour la question du couvercle transparent... faut penser aux UV aussi éventuellement... Comment on protégerait le reste du circuit?
Une solution à laquelle j'ai pensé c'est un print custom sur le boitier qui masquerait tout sauf le rectangle de l'écran,,, Ça peut-être un sticker qu'on colle à l'intérieur ou un print directement sur la boite... faudrait soumissionner polycase pour voir combien ça couterait...
Sinon on pourrait penser à une coquille qu'on pourrait visser par dessus le circuit à l'intérieur de la boîte. Jason est-ce que tu nous prêtes ta super découpeuse laser pour faire ça??? Steplait steplait steplait!

yoangp, 2019-03-10:
Pour LCD: https://fr.aliexpress.com/item/Special-promotions-lcd-20x4-LCD-module-Blue-screen-IIC-I2C-2004-5V-LCD-for-arduino/1621301904.html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

Trous dans les coins de 1/8in de diamètre, faut trouver spacer avec vis qui fitte = tread vis #4-40 impérial ou M3 métrique. Distance entre les trous : 55mm centre-à-centre hauteur et 93mm centre-à-centre largeur.

Hauteur des spacers pour boite YH 100804:
-Hauteur de l'écran au dessus du space = 11mm
-Hauteur dans la boite à partir de dessous le pcb = 102mm
-Hauteur du PCB = environ 2mm

Donc, hauteur des spacers = max 102mm-11mm-2mm = 89mm ou 3,5in. Trop cher chez Digikey.

yoangp, 2019-03-10:
Datasheet LCD choisi (même dimension que module chinois) Numéro de lcd : 2004A, semble standard...

LoupHC, 2019-03-11:
À date le plus haut que je trouve c'est du 4cm :
https://fr.aliexpress.com/item/50-pcs-lot-blanc-Nylon-standoff-M2-m2-5-M3-M4-femelle-femelle-nylon-en-plastique/32870711165.html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

LoupHC, 2019-03-11:
standoff en alluminium (80cm) :https://fr.aliexpress.com/item/Nouveau-10-PCS-Standoff-Ronde-En-Aluminium-Alliage-Entretoises-M3-95mm-60mm-80mm-90mm-100mm-pour/32834465655.html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

yoangp, 2019-03-11:
Ceux en alu de 80cm semblent intéressants et pas trop cher si achetés sur
Aliexpress. Je vote pour de quoi dans ce genre là!

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

Thread 67 (2019-01-20):

PCB - Choix clavier

yoangp, 2019-01-20:
Discussion sur le clavier à utiliser...

Options de clavier:
1. Garder le même clavier que l'Otomate 2018 afin de limiter les développements, dans le but qu'il y aura l'écran tactile d'un smartphone dans une prochaine version.
2. Trouver un autre modèle de clavier. Je sais Loup que tu as proposé un autre clavier, mais c'est quoi la raison exacte? Moins cher, plus robuste?
3. Touch screen sur le pcb, voir l'issue sur l'écran pour plus de détails.

Il faut aussi penser au positionnement du clavier, options:
A) Sur le pcb, à un endroit qui limite le risque qu'un fermier casse de quoi avec ses gros doigts sales ;-) Désavantages: Il faut ouvrir la boîte pour faire une action ou changer un paramètre, ça peut arriver quand même souvent. Peser fort sur le clavier peut engendrer des fissures dans les soudures ou les traces du pcb à long terme, donc défectuositée difficile à identifier et à réparer.
B) Au boût d'un cable. Donc possible de fixer le clavier dans le fond de la boîte ou sur le dessus de la boîte si le dessus est transparent. Idée de montage: Si on réutilisait le clavier de l'otomate 2018, il est déjà sur un flat cable et autocollant. Il serait possible d'installer le pcb directement sur le couvercle de la boîte (à l'en vers pour voir l'écran au travers du couvercle transparent) et de faire passer le flat cable dans un petit trou pour l'avoir accessible sur le dessus de la boîte (similaire à ce qui a été fait lors du dernier atelier).

Des commentairs, autres options? Sinon, je vote option 1B

LoupHC, 2019-01-21:
Mon concern avec le clavier membrane depuis le dernier atelier... c'est que j'ai peur que l'adhesif décolle après un certain temps... me semble qu'un beau clavier de téléphone ça serait swell et pas mal plus robuste  (pour 4$ au lieu de 2$)!

Un problème aussi si on passe le flat cable par le couvercle, c'est que ça crée un stress mécanique à chaque fois qu'on ouvre le couvercle. Il est assez court faque c'est pas évident de passer ses doigts pour le débrancher... c'est comme ça que le premier contrôleur de la clé des champs était fait... c'était pas génial...

Je penche plus aussi pour l'option B. Le moins de taponnage sur le circuit le mieux! Et ça diminue les chances de faire entre de l'humidité même si ça risque inmanquablement d'arriver...

Si on s'inspire de ce modèle avec les connecteurs RJ45 entre le circuit est le clavier, ça donne un form factor intéressant je trouve  :
https://www.amazon.com/gp/product/B06XGSYP1C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
On a déjà utilisé un connecteur RJ45 étanche dans le dernier modèle, on pourrait l'utiliser dans l'optique de sortir le clavier du boitier :
https://www.aliexpress.com/item/Free-Shipping-M20-8-core-waterproof-RJ45-network-connector-can-fixed-on-boxes-10pcs-lot/1923243933.html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,searchweb201602_1_10065_10068_10130_10547_319_317_10548_10696_453_10084_454_10083_433_10618_431_10139_10307_537_536_5736111_5736011_10059_10884_10887_100031_321_322_10103,searchweb201603_51,ppcSwitch_0&algo_expid=87646215-6df9-4205-87a4-1bd0736307a6-3&algo_pvid=87646215-6df9-4205-87a4-1bd0736307a6
Après faudrait encapsuler tout ça dans une petite boite , qui peut-être petite et cheap, même pas étanche... c'est sur que ça fait plusieurs étapes d'assemblage, et c'est ce qu'on essaie d'éviter au max... c'est à bien y penser... mais c'est quand même moins d'étape que le boitier d'interface qu'on a fait au dernier atelier et pour une résultat final bien meilleur à mon avis!

jayserf, 2019-01-29:
Très d'accord avec cela.

Nice idea.

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

yoangp, 2019-02-16:
Concernant le clavier pour la nouvelle version de l'Otomate, est-ce que vous pouvez me trouver un keypad plug-and-play? J'ai fouillé sur Aliexpress, Digikey, etc. Je n'ai rien trouvé d'intéressant. Le modèle que tu proposais Loup avec connecteur RJ45 n'est pas dispo en ce moment sur Aliexpress. Perso, je mettrait vraiment l'ancien clavier sur une plaquette de plastique protectrice devant le PCB, à l'intérieur de la boîte, comme on a déjà discuté (ou sinon sur le devant de la boîte avec une rallonge cable plat 8 fils). Pour avoir utilisé le clavier de 2018 pendant un an, j'ai trouvé qu'il faisait vraiment la job et que les touches répondaient bien.

yoangp, 2019-02-17:
Décision finale: Utiliser ancien clavier matrix 4x4 de 2018 avec chip mcp23008 sur le pcb. Le clavier sera dans la boîte sur la plaque de plastique ou à l'extérieur de la boîte avec une extrension du flat cable.

LoupHC, 2019-02-17:
Attends attends!
Je ne trancherais pas aussi vite.
Si on change la chip I/O expander du clavier je dois changer ma librairie et ça peut potentiellement être long et pénible.
Est-ce qu'on pourrait pas plutôt utiliser cette chip :
http://www.ti.com/lit/ds/symlink/pcf8574.pdf
C'est celle qu'utilise le module jaune associé au clavier.

LoupHC, 2019-02-17:
En l'installant de façon à utiliser l'addresse 0x26.

yoangp, 2019-02-17:
Ok pour utiliser la chip pcf8574, Digikey en on en masse de dispo en format dip.

Closed 2019-02-17.

Thread 68 (2019-01-20):

PCB - Switchs manuelles en cas de bug de l'arduino

yoangp, 2019-01-20:
L'idée est la suivante:

- En conditions normales, toutes les actions du fermier pour bypasser le mode automatique passent quand même par l'arduino. Il est possible via le clavier et l'écran de forcer l'ouverture ou la fermeture des roll-ups/ventilation/fournaise pendant x temps ou x% ou indéfiniment. Loup, t'as déjà codé tout ça, donc super!

- Sur le PCB, il y a des switchs pour passer en mode réellement manuel, mais c'est utilisé juste si n'importe quoi dans le circuiterie lâche (sauf les relais et l'alimentation 24VDC) ou que l'arduino capote.

Assez straight forward à implanter ces switchs sr le pcb, je propose le même montage que ce qui avait été fait pour les switchs manuelles de l'Otomate 2018, sauf que ça sera sur le pcb avec des switchs style: https://www.digikey.ca/product-detail/en/nidec-copal-electronics/AS2E-2M-10-Z/563-1588-ND/5086845

Des commentaires? Sinon je crois que ça c'est réglé.

LoupHC, 2019-01-21:
Est-ce qu'on peut quand même avoir des mini-switchs à bascule? C'est ben plus le fun à actionner! ;)

Au niveau du code je suis rendu à l'intégrer dans l'interface, ça j'en ai pour un bout encore, mais ça sera fait je vous jure!

yoangp, 2019-01-21:
Switch a bascules 2x plus cher, ça vaut tu la peine? Surtout que si les
switchs coutent pas cher, on peut aussi en mettre pour la ventilation,
fournaise, etc.

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

jayserf, 2019-01-29:
No comment....

Hard decision.

External switch means more wiring.
Internal means opening the box.

But if the interface is easier, people will actually use the override and
learn how to use the Keypad vs just defaulting to the big external switches
(observation from my farm)

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

Thread 69 (2019-01-20):

PCB - SMT ou through hole

yoangp, 2019-01-20:
En gros, pour continuer sur le commentaire de Jason, est-ce qu'on y va pour full SMT ou full through hole?

Pour moi, ça se résume à:
SMT:
- Moins cher (il faudrait évaluer la différence en $ mais surement assez important)
- Moins durable, mais le l'arduino mega est déjà full SMT..
- Moins facile à réparer, mais quand même possiblement réparable selon Jason.
- Fait plus de sens si on veut mettre un coating de protection contre l'humidité, mais ça veut dire qu'il n'y a pas de possibilité de réparer la chose.

Through hole:
- Plus cher
- Plus durable
- Il reste potentiellement juste les capteurs de courant pour les moteurs de roll-up qui sont difficile à trouver pas SMT ou sur socket intéressant.
- Plus facile à raparer si quelque chose brûle, mais difficile à dire si dans la vrai vie c'est vraiment applicable. On avait avancé l'idée que si quelqu'un a un board de brûlé, il pourrait nous l'envoyer en échange d'un board neuf et nous pourrions faire la réparation et revendre comme réusiné. Par contre, est-ce que ce scénario tient la route économiquement? Si on offre un service genre garanti an an sur les pièces, alors là on perd un peu moins d'argent si on peut réparer ce qui est brisé et le revendre. Si la pièce n'est pas garantie et qu'il faut que le fermier achète un nouveau board plein prix, c'est quoi son incitatif pour nous envoyer le board brulé? On peut bien payer le shipping du board brûlé en se disant qu'on va récupérer ce coût sur la revente du board réparé, mais si on voit que le board est full scrap lorsqu'on le reçoit (tombé dans l'eau, foudroyé à mort, etc.), alors il y a rien à faire avec.

Des commentaire? De mon côté, je pense qu'il serait pertinant de faire une petite recherche rapido pour estimer la différence de coût entre les deux. Si SMT c'est moitié moins cher et que ça réduit significativement le coût, ben là il va falloir bien y penser.

LoupHC, 2019-01-21:
Personellement j'ai jamais été foutu de souder autre chose que des résistances surface mount sur un board... et encore en sacrant pas mal... Les transistors je les brûlent 1 fois sur 2, les ICs on en parle pas j'ai hurlé en essayant de souder moi-même les sondes de courant sur un board une fois!

L'arduino MEGA est SMT c'est vrai! Mais au moins il est produit en série et on peut se dire que virtuellement on aura toujours la possibilité d'en trouver un autre quelque part pour le remplacer. Notre board non!
Aussi si je comprend bien, du moment qu'on a des conducteurs qui doivent rester exposés, comme nos connecteurs à vis par exemple, on doit laisser tomber pour le conformal coating? C'est pas possible de traiter seulement une partie du circuit si j'ai bien compris... à valider!

Perso je vote vraiment vraiment vraiment plus pour le through-hole! Surtout pour la possibilité de pouvoir rentrer les chips dans des sockets! Même pas de soudure impliquée! Réparer de l'électronique au tournevis, c'est pas génial ça?
Limite, je vois ça comme un argument de vente!
Si on offre une garantie (ce qui serait aussi potentiellement un excellent argument de vente!), faudrait bugetter le coût réel pour nous d'appliquer la garantie. Si on estime que réviser un board et le remettre en état ça nous prend tant de temps, faut facturer ce temps dans le prix de base, ou sinon le facturer au moment du switch. Genre on offre le service d'échanger le board pour un montant X, qui inclut le temps nécessaire pour le réparer et le shipping, plus un pourcentage de la valeur du board neuf pour compenser la dépréciation ou quelques pertes totales de temps à autres. Si les gens peuvent payer 200$ pour une remise à neuf, c'est quand même moins cher qu'un board neuf, ça couvre nos frais et ça évite de jeter de l'électronique inutilement!

Au niveau du coût, si on se fie aux couts de l'an passé, le prix des 3 boards+assemblage+pièces c'était environ 150$. 150$ sur 650$ de hardware et sur 900$ de prix de vente.
Si avec du surface mount on réduite le prix de 30%, ça fait quand même juste 5% de diminution du prix de vente total...

Je pense que j'ai un conflit personnel à work out avec le SMT... ;)

LoupHC, 2019-01-21:
Aussi un autre argument pour la durabilité, l'espacement entre les pattes... apparemment plus deux pôles négatif/positif sont proche, plus il peut y avoir de la corrosion par électrolyse sur le circuit. Avec du TH on a au moins 3x la distance entre les pattes qu'une pièce SMT!

yoangp, 2019-01-22:
J'approuves tes arguments Loup, allons y avec through hole. Il reste donc juste la question des capteurs de courant, les seules pièces SMT. Je sais que tu avais regardé pas mal de pièces sans trouver un autre format de chip intéressant. Je vais quand même regarder un peu de mon bord et si je trouve rien, ben on reste avec ce qu'on a.

yoangp, 2019-01-22:
Hmm, les shield de courant pour arduino sont tous fait avec le même genre de capteur de courant SMT, sinon through hole c'est pour du gros courant avec un fils qui passe dans un trou - pas pour nous. Le socket à soic-8 a l'air fou, gros et coute cher. Bon, je pense que je penche pour laisser le même chip et me casser la tête sur autre chose.

En passant, est-ce que tu as trouvé le courant maximal que peut prendre la chip? J'ai vu que le voltage de sortie va saturer à 5V si le courant est plus haut que 5A, mais j'aimerais savoir si la chip va exploser à 10A.. D'un autre côté, si on continue avec le power supply Meanwell 24V 6,25A, le risque est pas trop grand que ça arrive. Le power supply est fait pour jamais dépasser 100% de l'ampérage max.

LoupHC, 2019-01-22:
C'est assez rugged comme chip d'après ce que j'ai vu. C'est un capteur magnétique donc il n'y a aucun contact entre le courant mesuré et le signal envoyé, avec une isolation de 2400V! Ça veut aussi dire que le output peut pas dépasser la tension d'allimentation de la sonde, donc on est safe d'être toujours dans un range acceptable.
Il n'est pas indiqué de tension maximale dans le datasheet mais il y a une configuration de la chip qui permet de mesurer jusqu'à 50A donc on est au moins tranquille jusque là!

Une alternative si on veut pas souder la chip en surface mount c'est de mettre un header femelle pour emboiter un module comme celui-ci :
https://www.aliexpress.com/item/NEW-30A-Hall-Current-Sensor-Module-ACS712-model-30A-In-stock-high-quality/754724680.html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,searchweb201602_1_10065_10068_10130_10547_319_317_10548_10696_453_10084_454_10083_433_10618_431_10139_10307_537_536_10059_10884_10887_100031_321_322_10103,searchweb201603_51,ppcSwitch_0&algo_expid=a728d383-2808-48c5-b98d-996d60fa318f-0&algo_pvid=a728d383-2808-48c5-b98d-996d60fa318f
On pourrait le faire tenir au board avec un ti-wrap pour qu'il tienne plus fermement en place.
Qu'est-ce que t'en penses?

LoupHC, 2019-01-22:
Shit oui mets-en! C'est à voir s'ils peuvent le faire, si oui, on devrait s'en commander une couple de modules d'extra!!

yoangp, 2019-01-22:
C'est certain qu'on pourrait avoir des modules d'extra, méga facile à réparer par la suite. Et fini le SMT sur le board principal :-)

Jason t'en pense quoi de l'idée que j'ai lancée pour les pcb soic-8 à dip-8 avec PCBway??

Thread 70 (2019-01-20):

PCB - Protection surtension et inversion de polarité

yoangp, 2019-01-20:
Loup, est-ce que tu considère que cette problématique est suffisament robuste sur le modèle Otomate 2018?

Voici mes idées:

- Vu qu'on pense avoir des DC-DC converters 24V à 12V et 24V à 5V, il serait surement suffisant d'avoir la protection d'inversion de polarité sur l'entrée 24VDC.

- Sur l'Otomate 2018, la protection de surtension était sur le 5VDC.. Si la protection de surtension est sur le 24VDC, on protège du même coup le 12V et le 5V right? C'est sur que si le DC-DC converter 24V à 5V lâche sans raison et fait brûler l'arduino avec c'est poche. D'un autre côté, si la protection est juste sur le 5V et qu'une surtension passe sur le 12V ça risque de faire sauter le capteur de pluie Hydreon qui marche sur 12V. On pourrait mettre un DC-DC converter 5V à 12V pour garder le 12V protégé, mais ça pas l'air d'un super bon design, toujours mieux de mettre des DC-DC converter vers une tension plus basse pour réduire la demande en courant, ça fait aussi ben des converters en série. Ou bien on protège aussi le 12V séparément, mais c'est ben du trouble pour pas grand chose il me semble.

Donc, la question c'est : Est-ce qu'on déplace la protection sur le 24VDC ou on la garde sur le 5VDC ou on fait d'autre chose? J'ai pas encore mon idée de faite la-dessus, je dirais de garder la protection sur le 5V, mais ça m'achale que le 12V ne soit pas protégé et qu'on puisse faire sauter le capteur de pluie à 59$US c'est plus cher que l'Arduino!

N.B. En passant, j'ai vu que ça prend souvent une charge minimum de 10% de la capacité avec un DC-DC converter. Si c'est un risque pour nous, on pourra toujours mettre une résistance comme load minimale, ça a l'air d'être ça qui est utilisé habituellement pour des petits DC-DC converters. Certains DC-DC converter de qualité n'ont pas de minimum load.

LoupHC, 2019-01-21:
Pour l'inversion de polarité, en magasinant un peu on peut probablement trouver un régulateur de voltage qui a ce genre de protection intégrée. En même temps une diode schotky c'est pas cher payé et ça donne une tranquilité d'esprit supplémentaire.

Pour les surtensions je dirais que pour le arduino on doit être très prudent parcequ'on alimente le mega en 5V direct, et que son voltage maximal est de 5.5V. Le capteur de courant a probablement un régulateur de voltage intégré (je pourrai vérifier, j'en ai un chez nous!) donc on peut peut-être être un peu plus permissif au niveau des fluctuations de tension momentanées.
Dans les deux cas ça prend des condensateurs!

Ce que Daniel m'expliquait aussi, c'est que les circuits simples pour protéger des surtensions sont pas très précis, et peuvent fluctuer selon la température. Malheureusement on peut pas vraiment avoir une protection assez précise pour permettre 5V de passer, mais bloquer à 5.5V, de façon fiable tout le temps. À quelque part, on est un peu obligé de faire confiance au régulateur de voltage. Par contre! Pour limiter le risque on peut protéger le régulateur de voltage en amont. Comme ça on est certain que le régulateur reste à l'intérieur de ses specs en tout temps.
Faque quant à moi je mettrais seulement une protection entre l'alim 24V et les régulateurs 12v et 5v. Genre un gros varistor avec une fuse ou un crowbar circuit, comme le circuit déjà designé pour la dernière version.

Une de mes préoccupations aussi, c'est comment on va protéger les régulateurs des back-emf des moteurs... J'avais lu là-dessus un peu et ça disait que les régulateurs mettent un peu de temps à s'ajuster quand ya une variation rapide de tension et ça peut se répercuter sur la ligne de l'autre côté.
Dans le cas du arduino, vu qu'on a .5V de jeu, c'est risqué non?
On peut probablement faire un circuit filtre pour prévenir le problème mais ça implique des calculs qui dépassent mes compétences... et qu'il faudrait valider à l'oscilloscope!
Est-ce qu'on ferait pas mieux de rentrer le 12V dans le circuit par un transfo séparé, et de le rabaisser à 5V pour le contrôleur?

Le 24V des moteurs et des relais peut-être un peu plus freestyle quant à moi c'est moins téteux que des processeurs! Peut-être juste les varistors comme sur les drivers de moteurs feraient la job.
Avec un limiteur de courant pour pas griller les transistors!

Pour la charge minimum, c'est quoi l'effet contraire sinon?

yoangp, 2019-02-17:
Bon, pour la protection d'inversion de polarité sur le 24V, je trouve que le plus simple c'est de garder le design avec diode vu qu'on va descendre tout le reste sur le 12V. Mais je garde l'idée d'un P-Mosfet au cas ou...

Thread 71 (2019-01-21):

PCB - Provenance des pièces (Aliexpress/Digikey/Autre...)

yoangp, 2019-01-21:
Est-ce que ça vaut la peine d'acheter des pièces du PCB en chine puis les shipper au fabricant de PCB en chine plutôt que de dire au fabricant de pcb d'achter eux-même les pièces chez Digikey?

Aliexpress c'est sûr que c'est moins cher, mais surement aussi moins fiable.
Digikey ça me semble moins de trouble si on a pas à gérer l'approvisionnement des pièces au fabriquant de pcb.

LoupHC, 2019-01-21:
Pcbway peuvent acheter des pièces localement en Chine, on avait fait ça pour les gros connecteurs verts entre autre.
Je pense que tout ce qui est quincaillerie générique (switchs, fuse holder, connecteurs, résistances, sockets, condensateurs) ça vaut la peine de l'achèter en Chine.
Pour les pièces particulières (diodes, régulateurs de voltage, varistor) on devrait passer par digikey

yoangp, 2019-01-21:
Comment ça avait fonctionné avec PCBway? Est-ce que vous avez dit à PCBway:
telles pièces doivent venir de Aliexpress et telles autres pièces de
Digikey et arrangez-vous pour faire venir tout ça vous même à votre
compagnie pour l'assemblage?

Le lun. 21 janv. 2019, à 12 h 01, LoupHC <notifications@github.com> a
écrit :

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

LoupHC, 2019-01-22:
De souvenir on leur a juste envoyé les liens des pièces à acheter sur Aliexpress, et ils se sont occupé du reste!

Thread 72 (2019-01-22):

Service après vente

LoupHC, 2019-01-22:
Comment on s'organise à ce niveau-là? Je propose qu'on en discute!
Déjà je splitterais ça en deux temps :
- service après-vente pour l'atelier 2018
- service après-vente pour les futures versions du contrôleur

Pour le premier, on a discutté des possibilités suivantes :
- appeller tous les participants du dernier atelier et évaluer les besoins en soutien technique
- proposer un service de dépannage à la ferme (coût à évaluer)
- faire des capsules vidéos pour montrer comment faire les modifications nécessaires pour rendre le contrôleur fonctionnel.
- autre?
Comment on se situe par rapport à ces possibilités-là? C'est quoi l'engagement qu'on est prêt à mettre là-dessus cette année?

Pour les futures versions, on s'est plutôt dit qu'on visait un service après vente plus léger, quelque chose que les gens peuvent installer eux-même sans soutien technique et avec une formule de soutien qu'on peut faire à distance, quelque chose comme :
- manuel d'installation et d'utilisation en bonne et due forme
- formule de "garantie" du circuit, en cas de bris, on renvoit un exemplaire neuf en échange de l'ancien
(on doit déterminer comment les frais associés à cette garantie seraient assumés, à l'achat, ou on moment d'appliquer la garantie)
- ligne téléphonique de dépanage
- autres idées?
Comment on appliquerait ça concrètement?

yoangp, 2019-01-22:
Il faut que j'y penses bien mais je peux déjà dire:

On pourrait essayer de penser à des features de vérification de
fonctionnalité sur le monveau pcb, les leds et le paramètre de test c'est
déjà bien, mais il faudrait penser en détail, si tel bout du circuit fait
défaut, comment le savoir facilement.
Ex.
- Ajout led alim 5V on
- Ajout led alim 12V on
- Ajout led alim 24V on
- Ça serait vraiment le fun des leds à la sortie des relais pour s'assurer
qu'ils opèrent correctement, mais pas si simple à implanter. À l'atelier de
2016, les leds en parallèle avec les moteurs ont fait de beau feu
d'artifices, j'imagine à cause des spikes de voltage lors de l'arrêt des
moteurs.
- Une led qui clignote indiquant que l'arduino est pas stallé.
- Messages sur l'écran si c'est une faute détectée par l'arduino

Aussi, ce qui me préoccupe un peu sur le service aux gens avec le modèle
2018, c'est l'ajout d'embouts de métals sur les fils connectés aux
connecteurs étanches. C'est pas mal de temps de notre part pour rien de
nouveau pour les fermiers, sinon c'est quand même touchy de laisser les
gens faire ça par eux même. En même temps, si cette modif n'est pas faite,
il y a un risque significatif pour qu'une mauvaise connection pose
problème. Je sais pas trop, je vais continuer d'y penser.

Le mar. 22 janv. 2019, à 10 h 01, LoupHC <notifications@github.com> a
écrit :

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

Thread 73 (2019-01-23):

SOFTWARE - interface

LoupHC, 2019-01-23:
Je suis en plein dans le pimpage de l'interface et j'ai besoin de vos conseils et idées!

Jusqu'à maintenant, j'ai réussi à faire deux améliorations majeures :
- contrôlers les rollups, fans,  fournaises en mode semi-automatique (avec ou sans timer) à partir de l'interface
- changer la décimale lorsqu'on modifie un paramètre, en appuyant sur la touche '0'. Ex, si je modifie la température cible, avec les flèches je monte/descend de 0.1 à chaque touche, si j'appuis sur '0', je passe à +-1, si j'appuis encore sur '0', je passe à +-10 et si j'appuis encore sur '0' je retombe à +-0.1.
Ça  fait vraiment du bien!

- Prochainement, je pensais intégrer dans le menu "Action", des raccourcis vers les menus auxquels on accède généralement avec le code à 4 chiffres. Au lieu de se rappeller du code, les gens pourraient garder 9 menus en mémoire et les activer d'un seul clique.
Les menus peuvent modifier un paramètre ou lancer une action selon le cas, ils sont tous référencés par un numéro à 4 chiffres.
Trouvez vous que c'est une bonne idée? Ça donnerait une possibilité de customization intéressante je trouve!

Avez-vous d'autres suggestions d'améliorations à apporter à l'interface?

yoangp, 2019-01-23:
Tu travailles fort sur l'interface dis donc! :-)

Commentaires (certains ont l'air négatifs, mais c'est voulu constructifs!):
Personnellement, je trouvais que 1dégré d'incrément c'était suffisant comme précision et step de température. On sait qu'on veut rester dans un range 5degrésC à 30dégrésC environ. Des steps de 10 degrés c'est pas assez précis et ça oblige de savoir qu'il faut peser sur 0 pour switcher de mode pour aller mettre des incréments de 1degrésC. De plus, la température à différents endroits de la serre peut varier de plusieurs degrésC selon la position du soleil, l'entrée d'air extérieur, la distribution égale ou pas du chauffage dans la serre, etc. Des steps de 0.1 degré c'est bien au-delà de la précision réelle qu'il est possible d'atteindre.

Par contre, des steps de 0.5 degrés ça pourrait permettre d'introduire un certain ordre de priorités autour d'une température cible. Ex. 24.5degréC démarrage des fans pour entrer de l'air extérieur, 25degréC début d'ouverture des roll-ups.

Je trouve aussi que ça ajoute un niveau de complexité pour le fermier cette possibilité de swticher d'un mode à l'autre. Si tu veux tout de même garder ce feature. je proposes que tu mettes 0.5, 1 et 5 plutôt que 0.1,1 et 10.

Je sais que je t'en ai déjà parlé, mais quand j'ai utilisé le contrôleur d'irrigation HydroRain, j'ai trouvé ça merveilleux à quand point la programmation était simple à utliser et rapide à apprendre. Je pense qu'il y a juste 4 boutons et une roulette de sélection de la chose qu'on désire configurer. C'est sur qu'il y aura plus de paramètres à programmer sur le contrôleur, mais je te renvoie tout de même le "Simple is beautiful" ;-) Je peux te garantir qu'il y a une tonne de fermiers qui ont zéro intérêt à passer plus que 5min à apprendre comment le contrôleur marche. À la limite, il faudrait leur mettre dans les mains sans guide d'utilisation et qu'ils soient capable de le programme tout de suite juste de même.

Pour les raccourcis, je comprends ton idée, mais dans la réalité si les paramètres profond du contrôleur sont modifiés 5à10 fois dans l'année c'est probablement le gros max. Ensuite, ils vont pitonner des choses, mais ça va se limiter à changer quelques températures ou heures.

Moi, je pense qu'il faut que tu regarde ton interface avec des yeux neuf. Demande à quelqu'un qui connais rien de ton controleur de changer la consigne de température des roll-ups, ou le % d'ouverture des roll-up du stage 1, etc. Elle (la personne je veux dire, pas nécessairement une fille :-)) va surement te dire qu'elle a besoin d'informations pour faire l'action. Si elle trouve ça trop compliqué c'est qu'il y a un problème de design.

J'écris à voix haute...
Un redesign de l'interface pour rendre cela mega easy.
- Faire en sorte que toute action demande un code de 3 chiffres (ça donne quand même 999 posibilités)
- Ensuite tout ce qui peut être fait sur le contrôleur dépend d'un code.
Voici comment c'est présenté: Un des bouton est bien identifé en rouge avec
"1. Peser ici pour entrer code"
À côté, une liste bien claire de tout les codes, séparés selon que ça soit une action ou un paramètre à changer ou bien un autre écran d'infos à voir. (L'été passé j'étais souvent mélangé entre les bontons a,b,c,d quand ça fesait un mois que j'avais pas utilisé l'interface)
Ensuite ça peut être quelque chose du genre comme 3 boutons: "Augmenter", "Diminuer", "Entrer".
Si t'as plus qu'un paramètre à entrer dans l'écran en question, le "Entrer" te mène au prochain paramètre. Le paramètre en cours de modif est clignotant. (une grosse partie fonctionne déjà comme cela)
Donc, 4 bontons bien identifiés et une liste de paramètres.

En tout cas, c'est pas obligé d'être de même, mais l'idée c'est qu'il faut que ça soit méga simple, le moins de fonctions d'interfaces différentes à apprendre...

C'est quoi ton feeling là dessus?
On s'en rejase ;-)

LoupHC, 2019-01-23:
Autre question existentielle :
- les timepoints, est-ce que tu trouves ça trop abstrait comme concept? Est-ce qu'on devrait pas les catégoriser plus tôt comme :
T-nuit
T-dif
T-jour
T-pré-nuit
J'essaye de me débarrasser du plus d'abstractions possibles...

LoupHC, 2019-01-23:
Aussi, j'ai la bonne nouvelle à t'annoncer que j'ai maintenant du code qui me permet de faire presque tout ce que je veux avec l'interface!
Des architectures de menus, de l'affichage, de la modification de paramètres numériques, choisir parmis plusieurs nametags...

LoupHC, 2019-01-23:
Je garderais le code à 4 chiffres par contre, il y a une logique derrière :
premier chiffre = type de paramètre (timepoint, rollup, fan, fournaise...)
deuxième chiffre = #d'item
troisième et 4e = paramètre à modifier
Vu la longueur de mon fichier de code, faut que je garde de l'ordre là-dedans au minimum

Par contre les codes plus usuels on peut les numéroter 0001, 0002, 0003

LoupHC, 2019-01-27:
Tu vas me trouver tannant... j'ai encore changé d'avis!
Je pensais à ton idée d'utiliser un code à 2 chiffres, qui pourrait ensuite appeller un code à 4 chiffres défini dans le code.
Pis là j'étais comme... pfff ça va être du trouble!
Et là je me suis dit, tant qu'à ajouter une couche de programme, au lieu de créer un numéro qui appelle un numéro, pourquoi pas créer un nametag qui appelle un numéro, là ça prend plus son sens selon moi!
Autrement dit, d'un point de vue de programmation, c'est pas plus compliqué pour moi de faire un menu de texte qui appelle le numéro de programmation nécessaire.
Ex.
-set Rollup1 (affiche successivement les paramètres du rollup1)
-set Rollup2 (idem pour rollup2)
-set Device1 (idem pour device1)
-set Device2 (idem pour device2)
-set T nuit (idem pour timepoint 3-4)
-set Tjour (idem pour timepoint 1-2)
-Overrides (modifie les paramètres des overrides (autre menu)
-#code (entrer un code pour modifier un paramètre isolément)

Boom... changement de paradigme!
Qu'est-ce que t'en penses?

jayserf, 2019-01-29:
Very elegant and easy to understand!

Nice one!

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

LoupHC, 2019-01-29:
Les résultats de ma petite expérience comportementale (merci à Ève qui a tenu jusqu'au bout malgré l'envie de rage quit plusieurs fois) :
- les menus déroulants, c'est en général plus intuitif que les codes
- elle aimait mieux se faire guider à travers les paramètres un à la suite de l'autre plutôt qu'entrer uns par uns les codes correspondant aux paramètres à modifier.
- remarque intéressante : on utilise le clavier numérique seulement pour rentrer les codes, mais pas pour modifier les valeurs de paramètres, c'est contre-intuitif! À la place, on devrait utiliser les flèches pour naviguer à travers les chiffres (pour changer de décimale) et utiliser le clavier pour modifier la valeur de la décimale sélectionnée. C'est plus intuitif selon elle que le concept d'appuyer sur zero pour modifier la décimale.

yoangp, 2019-01-29:
Intéressant, une autre option serait d'entrer des valeurs comme au guichet
automatique, Exemple:
"Entrez la valeur : 00.0"
Taper le chiffre 2 donne:
"Entrez la valeur : 00.2"
Taper le chiffre 5 donne:
"Entrez la valeur : 02.5"
Taper le chiffre 0 donne:
"Entrez la valeur : 25.0"

Le mar. 29 janv. 2019, à 17 h 41, LoupHC <notifications@github.com> a
écrit :

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

LoupHC, 2019-01-30:
En tout cas guys, je m'embarque dans quelque chose de gros! Je vais vraiment avoir besoin de votre avis là-dessus!
J'ai fait un diagramme fonctionnel de la future interface du contrôleur, je pense enfin avoir rien oublié!!
Ça va être une belle interface à menu classique, mais la plus épurée possible (j'ai essayé).
J'ai essayé de m'imaginer le workflow que j'avais l'an passé quand je gossais sur le iGrow, ça donne ça :
https://www.draw.io/#G1ctQ59Fbii_Kc-W_18nohk9aDOSgipiFA

C'est un gros chunk mais vos commentaires sont plus que bienvenues! Dites le moi si ya des bouttes pas clairs. Les embranchements représentent différentes options sous-jacente à un menu.

LoupHC, 2019-01-30:
Idéalement il serait possible de naviguer dans ces menus-là dans les deux sens, c'est à dire en descendant ou en remontant les chaines de menus. À la fin d'une chaîne on reviendrait au menu principal ou au front screen (avec la température, les % d'ouverture...)

LoupHC, 2019-01-31:
Au cas ou ça bug sur draw.io
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

LoupHC, 2019-01-31:
En fait, je dirais que je suis pas mal rendu là. J'évalue qu'il me reste un bon 40h pour me rendre ou je veux...
Mon système d'overrides fonctionne comme je veux (pour la pluie, l'humidité, un override programmable à heure fixe par sortie, mode semi-automatique), pour l'override vent ça vaut pas la peine que je m'y mette avant d'avoir un setup physique où le tester.
Il me reste les fusibles électroniques à programmer aussi, mais sans setup physique c'est difficile aussi.
C'était pas mal mes gros chantiers pour cet hiver!

yoangp, 2019-02-02:
Pour commencer je vais essayer de mieux comprendre toutes tes fonctions.

-Dans Ajustement, C'est quoi l'ajustement pour T24h? Est-ce que tu peux mettre une valeur cible de T24h?
-Pour les ajutements météo, ça serais-tu possible de faire remonter cela d'un niveau car c'est de quoi qu'il va falloir changer quotidiennement, donc idéalement le moins de pitonage pour changer la valeur. Ex: "Menu Principal"/"Ajustements Météo"/ Soleil ou Mi-Mi ou Nuage. L'affaire c'est la T24h qui est problématique à garder dans ce menu. T'as tu une sugestion?
- Rien à dire pour "Config menu" a part que le nom n'est pas super intuitif. Mais j'ai pas vraiment de meilleur nom. "Paramètres fixes"? "Config initiale". Oui, "Config initiale" je pense que c'est bon, c'est clair qu'il faut le faire une fois au début puis il n'est plus nécessaire de s'en occuper.
- C'est quoi le menu "Capteurs", est-ce juste pour spécifier quel capteur est branché? Si oui, ça pourrait aller avec le menu config initiales...
- C'est quoi T jour/Dif?
- C'est quoi T nuit/Pré-nuit
- Ça serait super d'avoir une façon de désactiver tous les paramètres qu'on veut pas utiliser, afin de ne pas avoir à se casser la tête pour changer la température lorsque le contrôleur n'est pas installé sur une serre à tomates. Ex.: Moi mon tunnel multiusage, je l'utilisait juste avec les roll-ups avec une seule temp réchauffement et une seule temp refroidissement. C'est basic, mais ça fait déjà mille fois mieux la job que d'ouvrir à la main et c'est pas compliqué à gérer. Mes suggestions; Soit que dans le menu config initial, il soit possible d'activer ou de désactiver certaines fonctions (ex.: Pré-nuit: ON/OFF). Sinon, dans le menu en tant que tel. Ex de l'écran lorsque tu arrives dans le menu Pré-nuit:
"Congif Pré-nuit"
"ON/OFF"
"Clock/Sunrise"
En fait, je viens de voir que tu as mis un paramètre Activer/Désactiver sur les Roll-ups, fan,fournaise. Dans le fond, il serait peut-être possible de mettre ça sur les menus : Tjour/Dif, Tnuit/Edit, Tjour/Pré-nuit.
- Ça se peux-tu qu'il devrait y avoir Sunset dans tes settings et pas juste des Sunrise ;-)
- Temps de rampe, si c'est pas utilisé, ça pourrait être par défaut à zéro... C'est dans le fancy ce paramètre!
- Paramètres roll-ups: Je sais pas si tu as pensé à ça mais ça prend une façon de clearer la jupette qui ne fait pas parti des paliers de refroidissement. Je pense que le plus simple, serait d'ajouter le temps pour passer la jupette comme premier paramètre (j'ai déjà ajouté une boîte pour ça dans ton schéma draw.io). Plus de détails: Lorsque la serre est complètement fermée, ça ne peut pas être flush avec la jupette, il faut que ça descende plus bas que le haut de la jupette pour s'assurer que le vent et le froid ne rentre pas trop dans la serre. Donc, si le roll-up descend plus bas que le bas de la jupette, ça fausse le premier palier d'ouverture si on en tient pas compte. Avec tes paramètres de 2018, il était possible de faire avec mais ce n'était pas propre. Dans le cas de mon tunnel, j'avais 4 paliers de 25% et le premier palier ouvrait juste une mini ouverture en haut de la jupette, le palier 2 ouvrait donc presque 1/3 de la surface d'ouverture. Tout ça pour dire, que ça serait vraiment moins mélangeant avec un paramètre spécial pour la jupette. Est-ce que c'est assez clair comme explication? On peut s'en parler au téléphone aussi..
- Pour les Enable-diasble des overrides, je mettrait ça en premier. Ex.: "Pluie"/"Enable-Disable"/"%". Si on sélectionne "Disable", il faudrait sortir tout de suite du menu, sinon c'est mélangeant de spécifier un % sur un paramètre disablé.
- A quand endroit tu spécifie "Sonde temp extérieur connecté/pas connecté" ? J'ai vu le commentaire, mais dans quel menu ça se retrouve exactement?
- Dans "Force close"/"Délai(min)", est-ce dans ce menu que tu peux mettre un temps infini quand il faut mettre à off de manière permanante?
- Il faudrait un menu pour indiquer s'il y a ou non un anémomètre (et lequel), un capteur de pluie (et lequel), etc. Mais en fait, peut-être le fait que l'override soit "Enable ou diasble" fait la job. En tout cas, ça fait bizarre que le capteur de temp intérieur soit à part. Est-ce que tu l'as mis à part car il est utilisé partout (roll-ups, fan, fournaise)?

Bon, je pense que tu as quelques piste de réflexion ;-)

LoupHC, 2019-02-02:
Nice!!! wow ça c'est du feedback! Thanks man!
- mettre Ajustements en haut de liste : bonne idée, c'est vrai que c'est la fonction la plus utilisée
- l'ajustement T24h, c'est pour moduler la T24h vers le haut ou vers le bas en fonction de la charge en fruit. Ça modifie tous les paramètres de températures de tous les timepoints de +-X*C
- Hmm effectivement, c'est le genre de trucs qui tu définis juste une fois.
- Le Dif, c'est une période de chauffage avant le lever du soleil pour réveiller les plants avant que la chaleur commence à monter brusquement. Ça permet de contrôler la longueur des entre-noeuds, ça limite la condensation, etc. On pourra activer/désactiver cette fonction.
- La pré-nuit c'est une technique pour augmenter le calibre des fruits en faisant dropper drastiquement la température au coucher du soleil, et de remonter graduellement par la suite.On pourra aussi activer/désactiver cette fonction.
- Tu penses que ça pourrait être pertinent d'utiliser juste la T jour? Je comprend pas trop comment tu utilisais la température de réchauffement avec les rollups... seulement la température de refroidissement et l'hysteresis est pris en compte normalement.
Faudrait juste pas que ĉa soit possible de désactiver la T nuit ET la T jour par accident, parceque là ça ferait crasher le programme...
- lol oui, blame it on the copy/paste
- pour le temps de rampe, c'est pas aussi évident quand tu automatises seulement des rollups, mais avec des fournaises et de la ventilation, sans ramping, ça peut créer des changements de température assez drastique et ça stress les plants. Mais c'est vrai qu'on peut le mettre a zéro par défaut.
- la manière la plus straight forward selon moi serait de jouer sur les pourcentages. Ex. tu pourrais avoir ton premier palier à 40% puis le deuxième à 60%, puis 80%, puis 100%.
- enable des overrides : bonne idée de le mettre en haut!
- temp extérieure : nulle part vraiment, en même temps on pourrait inclure un système de reconnaissance software qui détecte automatiquement si une sonde d'extra est connectée.
- par défaut la durée du bloquage est infinie, en jouant avec les flèches on peut faire varier la vitesse entre 1min et 24h.
- la seule raison pour ça c'est que le code est compatible avec deux sondes différentes pour la température intérieure, mais seulement une sonde de pluie (pour l'instant). S'il y a un seul choix supporté, j'irais avec la reconnaissance automatique.
En tout cas merci pour les commentaires je vais dormir là-dessus!

LoupHC, 2019-02-22:
Nouvelle utilisation du clavier à bouton (idée) :
- On supprime les boutons ABCD
- On garde seulement les boutons 1234567890*#
Le bouton * devient le bouton SCROLL et permet de passer d'un menu à l'autre.
Le bouton # devient le bouton SELECT et permet de sélectionner un menu ou de confirmer une nouvelle valeur
Les numéros servent à entrer la valeur du paramètre, guichet automatique style, ou à appeller des fonctions toutes faites ex :
1 permet d'appeller la fonction d'override manuel du premier rollup
2 permet d'appeller la fonction d'override manuel du 2e rollup
3 permet d'appeller la l'override du 3e équipement
...
9 permet de sélectionner la météo du jour
0 permet d'ajuster la T24h
Trouvez-vous que ça a de l'allure?

Thread 74 (2019-01-25):

PCB - Alimentation 120V ventilation

yoangp, 2019-01-25:
Quand même pas mal comme patente:

https://www.amazon.ca/Iot-Relay-Enclosed-High-power-Raspberry/dp/B00WV7GMA2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

Pas acheter de boîte, pas de montage à faire et super easy à installer.

Mais c'est juste 12 ampères. Y'a peut-être d'autres modèles.

yoangp, 2019-01-25:
Les plus gros fan jet que j'ai trouvé sur le net jusqu'à maintenant c'est avec un moteur de 1HP (16A) pour des grosses fan de 30 pouces. Le max serait des fan jet de 1/2HP (10A) avec un Powerswitch tail par Fan jet.

LoupHC, 2019-01-25:
Nice!
C'est bête n'empêche... c'est les même specs que les relais dans le boitier...

LoupHC, 2019-01-25:
Sinon avec un module comme ça on peut avoir une sortie à 20A, faut faire des connexions mais au moins ya pas de conducteur exposé:
 https://www.amazon.com/dp/B01B60RZPA/ref=sspa_dk_detail_1?psc=1

jayserf, 2019-01-29:
That's a sweet find. Both of them.

I guess this is to not have 120 going to relays in our control box?

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

yoangp, 2019-01-29:
That’s right, no 120v in the box mean less danger for farmers without
electrical knowledge and maybe easier later to certify if we what to sell
the thing elsewhere than Québec.

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

jayserf, 2019-01-30:
Got it. Cool

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

Thread 75 (2019-01-31):

Sondage pour suivi atelier 2018

yoangp, 2019-01-31:
Allo Loup,

J'ai rajouté une option pour donner de l'aide via un webinaire, plutôt que visite sur place ou atelier de mise à niveau (j'ai ajouté cette colonne dans le fichier Excel). J'ai déjà 3 personnes qui trouvent que le webinaire serait le mieux.

J'ai rejoint 5 personnes,mais ça va prendre encore un petit bout de temps pour faire le tour de tout le monde. J'ai laissé plusieurs messages vocals que je suis pas sur d'avoir un retour d'appel. Je vais peut-être m'essayer pas courriel si j'ai pas de feedback téléphonique. Au moins pour savoir le minimum par rapport aux questions du sondage qu'on a.

Finalement, je vais mettre mes données dans le fichier en ligne lorsque j'aurai contacté tout le monde, car j'ai des problèmes d'internet et Excel en ligne me joue des tours...

LoupHC, 2019-01-31:
Hein oui bonne idée!
Ça serait moins de trouble à organiser qu'un atelier. Et un bonne alternative à une visite personnelle pour quelqu'un d'un peu patenteux!

LoupHC, 2019-01-31:
De mon côté pas encore commencé les appels, je m'y met demain!

yoangp, 2019-02-01:
J'ai commencé à envoyer des courriels à ceux qui répondent pas au téléphone, voici le message que j'ai envoyé si tu veux faire de même de ton côté:

Allo xx et yy!

Loup et moi faisons un petit suivi des contrôleurs de serre de la CAPÉ autoconstruits en 2018 pour voir si un coup de main peut être donné au besoin et nous enligner sur la prochaine version du contrôleur que nous sommes en train de concevoir.

J'aimerais bien vous parler au téléphone environ 10min (819-434-6801 en tout temps), mais sinon une réponse par courriel suffira.
Voici nos quelques questions:

1. Est-ce que votre contrôleur de la CAPÉ est installé?
Si oui, que contrôlez vous? Roll-ups, fournaise, fan?
Si non, pourquoi?

2. Avez-vous fait un update du code ou modifié le circuit pour corriger les petits bugs suite à l'atelier?

3. Votre objectif en 2019 avec votre contrôleur? Installer dessus les roll-ups / fournaise / ventilateurs?

4. Pour utiliser le plein potentiel de votre contrôleur, seriez-vous intéressé à l'une des options suivantes?
- Une visite en personne payante - mais à coût moindre qu'on technicien de serre
- Un atelier de mise à niveau cet hiver à un endroit au Québec à définir
- Un webinaire de mise à niveau cet hiver pour avoir un complément d'information pour l'installation des roll-ups, fournaise, ventilateur et voir comment faire vous même les quelques corrections aux bugs.

5. Autre commentaire? Bug sur le contrôleur installé / amélioration à faire / etc.

C'est tout! Merci d'avance pour votre temps!

Yoan et Loup

yoangp, 2019-02-02:
J'ai mis mes infos recueillies jusqu'à mainteant dans le fichier en ligne.

yoangp, 2019-02-08:
Je pense que j'ai fait le tour de mon côté pour le sondage, il y a 3 personnes que je n'ai pas pu avec de réponse (Arnaud Mayet, Olivier Painchaud et Vazouk Poisson). Pour l'instant, au total on a juste 6 boîtes qui ont été mis en fonction; Lève tôt, Tessa, Nues mains, des libellules, rouge tomate (en cours d'installation), Tournesol (juste drivers utilisés). La plupart de celles par intallées c'est qu'ils n'ont pas encore de serre. Il faudrait ajouter le contrôleur de Carya et le mien dans la liste pour faire le tour. Je vais faire une ligne pour moi et est-ce que tu peux remplir celle de Carya?

Thread 76 (2019-02-01):

PCB - Protection physique du circuit

yoangp, 2019-02-01:
Détails à venir

yoangp, 2019-02-01:
Peut-être au lieu de mettre un collantsur le panneau de plastique protecteur, le texte pourrait être gravé au laser? Ça se fait-tu facilement Jason avec une machine comme vous avez à votre travail? Est-ce que la puissance du laser peut être ajustée pour par passer au travers du plastique?

LoupHC, 2019-02-01:
Avec des overrides switchs comme celles-là :
https://www.aliexpress.com/item/Promotion-5-Pcs-AC-ON-OFF-SPDT-2-Position-Latching-Toggle-Switch-6A-125V/32813324272.html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
On pourrait facilement faire passer la switch de l'autre côté de la protection en plastique et même la bolter après!
Ça donnerait quelque chose de très solide je pense!

yoangp, 2019-02-01:
On a juste à les mettre dans les coins, pas besoin de spacers ;-)

yoangp, 2019-02-17:
Remplacer fusible sur le 5VDC par [circuit breaker 1.5A ](https://www.digikey.ca/product-detail/en/e-t-a/1410-L110-L1F1-S01-1.5A/302-1409-ND/3987396)

Exemple varistor vraiment solide:
[Varistor 100joules](https://www.digikey.ca/product-detail/en/littelfuse-inc/V20E20P/F11291-ND/4285775)

Ça fait environ 20$ de plus pour par avoir à s'occuper d'un fusible brulé. En même temps, j'ai comme l'impression que le DC-DC converter 5V ne sera pas en forme après qu'il ait eu 33V en sortie, donc s'il faut changer le régulateur, un fusible de plus ou de moins, bof. Laissons le fusible pour l'instant je dirais.

yoangp, 2019-02-17:
LM317:  https://electronics.stackexchange.com/questions/266054/lm317-explosion

Ça l'air que ça ne fait pas une super protection de court-circuit d'utiliser un lm317 tout seul car il va dissiper toute la puissance. Il faudrait y ajouter une autre affaire pour réellement déconnecter l'alimentation lorsque la sortie est shortée.. Mais ça peut faire une bonne première ligne de défense le temps qu'une fuse saute genre.. Qu'est ce que tu en penses?

LoupHC, 2019-02-18:
Je suis d'accord que si on ajuste de 24v à 12v et de 12v à 5v... ça fait pas mal de circuiterie à traverser avant d'arriver au contrôleur. Et les modules dc-dc que tu m'as montré ont une protection intégrée contre les courts-circuits non?
Peut-être que c'est suffisant!

yoangp, 2019-02-18:
Low dropout regulator pour doubler protection sur le 5V, tout en limitant la baisse de la tension:
https://www.digikey.com/product-detail/en/texas-instruments/TPS7150QP/296-8050-5-ND/373253

Thread 77 (2019-02-02):

Webinaire hiver 2019

yoangp, 2019-02-02:
But: Passer de l'info sur comment réparer bugs du contrôleur 2018 et comment installer fan et fournaise + autres questions des gens.

À faire:
- Trouver un contrôleur pas modifié et pas loin de chez Loup ou Yoan pour le webinaire
- Voir quel système de webinaire on utilise. Ça marche pas pire avec le compte Via de la CAPÉ, mais il faut utiliser des téléphones mobiles car son via l'internet terrible. Est-ce que ça va bugger avec la vidéo en plus.. à tester. Sinon, Jason a suggéré un autre système (Zoom Video Communications). Mais ça change pas que si les gens ont une connection internet pourrite, ils sont mieux avec téléphone pour poser des questions lors du webinaire.
- Faire un powerpoint pour le contenu
- Faire une pratique du webinaire (possible à distance??)
- Une fois que c'est plus avancé, afficher une date
- Faire le webinaire à Victo. Yoan se déplacera chez Loup pour faciliter l'affaire et aider à filmer le webinaire.
- Mettre l'enregistrement du webinaire en ligne (Youtube), avec une liste indiquant à quelle minute on parle de quoi pour aider les gens à trouver ce qu'ils ont besoin dans l'enregistrement.

LoupHC, 2019-02-05:
Ok de quoi on devrait parler pendant le webinaire en question :
- problématique du power supply qui lâche : comment le corriger
- comment renforcer les connexions
- comment tester la continuité
- comment brancher une fournaise (terminaux contacteur)
- comment brancher un équipement sur le 120VAC (parler de calibre de fil, specs de relais)
- utilisation de l'IDE pour télécharger le programme
- autre chose?

yoangp, 2019-02-05:
Il serait bien de parler aussi de toit ouvrant. À part Coeur de légumes, il y a Simon Leduc qui veut installer un toit ouvrant similaire. À Tourne-sol aussi ils ont un toit ouvrant sur leur nouvelle serre, même si Reid utilise un iGrow... Tout ça pour dire qu'il y a quand même quelques grosses serre à toit ouvrant. De son côté, Simon, voulait 2 roll-ups, 1 fan, 1 fournaise et 1 toit ouvrant (sur 2 sorties). Est-ce que ton code s'adapte facilement pour faire ça?? En fait, je viens juste de penser que le toit ouvrant pourrait être en parallèle avec les côtés ouvrants. Donc pas de sorties additionnelles nécessaires. Est-ce comme ça que ça fonctionne pour Coeur de légume?

Est-ce qu'on était d'accord sur le version du code qui devrait être mise à jour dans les contrôleur de 2018? Comme j'avais dis, je pense qu'il faudrait y aller pour le minimum de changements pour éviter d'autres nouveaux bugs, je vois ceci qui est essentiel:
- Correction bug lorsques plusieurs paliers au même pourcentage
- Côtés qui s'ouvrent pas en même temps pour réduire les drops de tensions au maximum (exemple, Yan a encore des problèmes de roll-ups stallés sporadiquement, même avec le bypass de la résistance) surtout qu'il y a des gens pour qui les moteurs tirent pas mal plus de courant et le power supply de 6A est limite lorsque 2 moteurs partent en même temps.
- Je mettrais incrément de 0.5 degré C, plutot que 0.1 degré C lors de l'ajustement de la température avec le clavier, sans changer rien d'autre au code pour ça.

Pour l'instant, c'est ce qui me vient en tête...

LoupHC, 2019-02-05:
C'est tout à fait possible de mettre deux sorties en parallèles sur le même output! Les transistors sont vraiment overkills. Par contre les temps d'ouverture/fermeture seront identiques.
Pour l'instant le code de base permet de gérer 4 devices : 2 rollups et 2x fan OU fournaise
Il y a une sortie d'extra mais pas prise en charge avec l'interface, par contre c'est possible de l'utiliser directement dans le code.
Recommandation de Reid à ce sujet par contre :
- un toit ouvrant, c'est un gros risque! C'est beaucoup plus sécuritaire si on peut inclure un anémomètre. certains voudront peut-être attendre qu'on ait implémenté cette fonctionnalité avant de le mettre en fonction.

Les corrections dont tu parles sont assez simples (pour l'affaire des pourcentages je vais voir si c'est rétrocompatible). Pourrais tu m'envoyer ta version du code pour l'histoire des deux rollups en alternance?

yoangp, 2019-02-08:
J'ai mis un premier draft de la présentation powerpoint sur Dropbox.
Je vais voir comment organiser la question du filmage du webinaire. Est-ce que tu peux t'occuper spécifiquement de la préparation du montage qui sera requis pour le webinaire vu que tu auras une vrai boîte avec toi? J'aimerais qu'on s'arrange pour que je n'aie pas à aller 2 fois à Victo en une semaine. Si on pense manquer de temps de préparation, je peux venir vendredi avant l'atelier en fin de journée, mais à voir selon notre niveau de confiance. Qu'est-ce que tu en dis?

yoangp, 2019-02-08:
Pour l'affaire de toit ouvrant, est-ce qu'il y a quelque chose de facile à faire pour le code d'ici l'atelier, ou ça sera obligatoirement une version du code à tester dans le futur?

LoupHC, 2019-02-08:
Tu peux venir vendredi soir ou samedi matin tôt comme tu préfères, le vendredi je vais revenir vers 7h par contre vu que je vais travailler sur les contrôleurs de Coeur de légumes pendant la journée.
Mais oui j'aimerais bien qu'on se fasse une petite générale avant, le live c'est intimidant quand même hehe.
Je pense qu'on peut monter la présentation à distance d'ici là, on s'appelle si y faut. J'ai fait une couple de schemas de filage sur draw-io je te les enverrai! Je jette un coup d'oeil à l'instant sur le draft!

Pour le toit ouvrant, c'est possible dès maintenant sans modifications dans le code si on branche les rollups en simultané. Je vais faire un schema pour ça aussi je sais que Coeur de légumes en veulent un aussi!

yoangp, 2019-02-12:
Salut Loup, pour la rencontre pour le webinaire, je vais venir samedi matin,  je serai chez toi entre 8h30am et 9h30am (à moins que la météo à court terme soit vraiment pourrie pour samedi, dans ce cas ça serait vendredi soir).

yoangp, 2019-02-12:
Salut Loup,

Est-ce que tu sais qui est responsable du compte Via de la CAPÉ? Il faudrait s'assurer de ne pas entrer en conflis avec une autre activité pour le webinaire de samedi. Je voulais justement tester des affaires avec la compte et j'étais en plein dans une conférence! Il doit y avoir un calendrier d'utilisation à quelque part...

LoupHC, 2019-02-12:
Je nous ai réservé la plateforme!

yoangp, 2019-02-12:
Comment as-tu fait cela? Il faudrait que je la réserve pour mes tests de
filmage..

Le mar. 12 févr. 2019, à 12 h 12, LoupHC <notifications@github.com> a
écrit :

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

yoangp, 2019-02-14:
J'ai fini mon travail sur le fichier dans Dropbox qui est maintenant nommé : Otomate V1 - Contrôleur de serre - Feuille des fonctions et paramètres.xlsx. J'ai mis aussi une version pdf, mais gène toi pas si tu veux qu'on change encore quelque chose dans les descriptions.

yoangp, 2019-02-15:
Allo Loup,

Je pense avoir fait mon tour de la présentation Powerpoint.
- j'ai mis en bas à gauche qui parle à chaque slide
- j'ai regroupé les sujets qui seront filmés ensemble vers la fin afin de faire une seule interruption dans le webinaire
-J'ai ajouté des infos par-ci par là dans la présentation

Regarde tout cela si tu peux et on s'en reparles en personne ce samedi am!
Je compte être chez toi tel que prévu entre 8h30am et 9h30am.

LoupHC, 2019-02-24:
Le lien du webinaire : https://www.youtube.com/watch?v=BzGnGOEXX9k&t=1599s

Closed 2019-02-24.

Thread 78 (2019-02-15):

Collaboration avec CEGEP Outaouais

yoangp, 2019-02-15:
À faire:
- Discuter des modalités d'une collaboration possible
- Mettre en forme les besoins futurs qu'on a pour le contrôleur Otomate et voir comment ça peut se matcher avec le porjet du CEGEP.

Copie des courriel:
---------- Forwarded message ---------
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

Thread 79 (2019-02-15):

PCB - Carte SD

yoangp, 2019-02-15:
Vous pensez quoi d'un petit module [comme ça](https://www.aliexpress.com/item/New-TF-SD-Card-SD-Ramps-3D-Printer-Assembling-Module-For-Ramps-1-4-Diy-Kit/32958286211.html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,searchweb201602_1_10065_10130_10068_10547_319_317_10548_10696_453_10084_454_10083_10618_10139_10307_537_536_10902_10059_10884_10887_321_322_10103,searchweb201603_70,ppcSwitch_0&algo_expid=15ac42e1-a81a-4f09-8b8d-198c14975599-7&algo_pvid=15ac42e1-a81a-4f09-8b8d-198c14975599&transAbTest=ae803_4) pour la carte SD. J'aime que le module est 100% monté, avec un socket pluggable et alimenté en 5V. il y a des shields cool RTC + Carte SD, mais il y a souvent d'autres choses que j'aime pas. Aussi, au moins avec ce petit module, on peut faire du développement compartimenté.

yoangp, 2019-03-03:
Celui là utilisé maintenant:

https://www.aliexpress.com/item/Micro-SD-card-mini-TF-card-reader-module-SPI-interfaces-with-level-converter-chip-for-arduino/1865616455.html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,searchweb201602_1_10065_10130_10068_10547_319_317_10548_10696_453_10084_454_10083_10618_10139_10307_537_536_10902_10059_10884_10887_321_322_10103,searchweb201603_70,ppcSwitch_0&algo_expid=b954736b-9f09-4db5-9a39-782ed62f5310-2&algo_pvid=b954736b-9f09-4db5-9a39-782ed62f5310&transAbTest=ae803_4

Thread 80 (2019-02-17):

PCB - Override des moteurs

LoupHC, 2019-02-17:
J'ai essayé de trouver un nouveau circuit de switchs simple pour dealer avec le nouveau setup de relais ce matin.
J'ai rien trouvé à date... à part avec des switch dp4t et autres affaires weirds...
Je me demande à quel point on se donne du trouble pour enlever un relais du circuit. Celui qu'on a, on sait qu'il marche, et qu'il est facile à utiliser.
Et puis l'enjeu de perte de puissance, c'est assez spécifique au problème de peak current des moteurs, au pire si les gens veulent utiliser les overrides, on inclue une note qui indique "start motors one at the time" ou quelque chose du genre.

S'il y a un problème avec le contrôleur, l'alternative la plus efficace, c'est de mettre les deux moteurs à "ouvrir" et de partir faire ses affaires pendant la journée, plutôt que de mettre un moteur à "ouvrir", attendre 2 minutes, et mettre le 2e à "ouvrir".
Aussi, c'est pertinent de pouvoir bloquer un moteur pendant que l'autre roule en automatique, si en le bloquant on bloque aussi le relais d'inversion de polarité on n'est pas plus avancé.
Je dis qu'on garde le circuit à 2 relais par moteur et le même filage de switchs.
Qu'est-ce que t'en penses?

LoupHC, 2019-02-22:
Qu'est-ce que t'en penses?

yoangp, 2019-02-22:
Oupss, j'avais pas vu passé celui là..

Oui, on peut faire comme tu dis. J'avais comme dans l'idée de mettre un 8ième relai juste comme spare si un des 7 autres lâche. Pis là je me suis dit que si on remet le circuit des moteurs à 4 relais, mais qu'il est possible de faire fonctionner le tout avec juste 3, ben un jumper pourrait permettre de retirer un des relais et s'en servir comme back-up.. Mais ça a l'air trop compliqué il me semble. C'est certain qu'on peut mettre aussi un 9ième relai de spare sur le circuit, mais là là, il va y en avoir du relai là-dessus!!

En bref, je peux commencer par remettre le circuit des moteurs sur 4 relais.

Thread 81 (2019-02-17):

PCB - Condensateur pour inrush current du moteur 24V

yoangp, 2019-02-17:
Courant nominal moteur: I = P/V = 100W/24V = 4,17A

Formule pour inrush current moteur: Imax = 3*I = 12,5A

Formule énergie inrush current moteur DC: V*Imax*t = 24V*12,5A*0,2s =60J

Formule énergie condensateur : J = 0,5*C*V*V
Convertie pour Capacitance: C = J/(0.5*V*V)
Pour un drop 2V, C = 60J/(0.5*2*2) = 30F

En gros, ça prendrait un trop gros condensateur sur l'alim 24V pour absorber la drop de tension générée par les moteurs. On va placer plutôt un plus petti condensateur sur les sorties d'alimentation 12V et  5V pour garder le 12V et le 5V stable vu que la charge sur le 5V et le 12V est beaucoup inférieure.

Article intéressant là-dessus:
https://www.element14.com/community/thread/60512/l/capacitor-to-smooth-out-raspberry-pi-power-dips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

Sur le 5V, Otomate 2018: I = 0,17A avec test paramètre 5555.
1v de drop sur l'alimentation du Atmega semble possible
C = I*dt/dV = 0,17A*0,02s/1V = 3400microF, Max régulateur DC-DC par output = 2200microF (même si plus élevé si juste 1 output...).
Choisi valeur de 2200microF, durée de vie étendue (10000hrs à 105degrés C, donne plus de 100000hrs à temp ambiante).

Thread 82 (2019-02-17):

Capteur de lumière

yoangp, 2019-02-17:
Capteur de lumière proposé par Loup:

https://www.aliexpress.com/item/Light-transmitter-sensor-0-10V-0-5V-4-20mA-RS485-200000Lux-65535Lux-industrial-light-intensity-illumination/32860403692.html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

Loup, on se donne tu le trouble d'une connection en RS485 pour avoir une donnée de luminosité précise digitale en lux, ou on fait simple avec entrée analog 0-5V?

LoupHC, 2019-02-17:
analogue!

LoupHC, 2019-06-01:
Les équipements sur le 12V (sonde de pluie + sonde de lumière) font pas tellement de bruit électronique, je ne pense pas que ce soit problématique de relier les grounds ensemble!
Dans le pire des cas, la zener qui protège les ios va clamper les surtensions induites sur la ligne, qu'est-ce qui pourrait arriver d'autre?

LoupHC, 2019-06-01:
Premières données enregistrées du capteur de lumière!!!
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

Thread 83 (2019-02-17):

PCB - Capteurs de température et humidité

yoangp, 2019-02-17:
À part la protection des IOs, il n'y a rien à changer sur les sorties digitales (connecteurs P7 et P8 de l'Otomate 2018) pour les capteurs d'humidité et de température.

LoupHC, 2019-02-22:
nope!

Closed 2019-02-22.

Thread 84 (2019-02-17):

PCB - Capteurs de pluie

yoangp, 2019-02-17:
- Utiliser le tipping bucket de [Sparkfun](https://www.sparkfun.com/products/8942)
2 pins pour contact de switch lorsque le bucket se vide

ou

- Utiliser [Hydreon RG 11](https://www.fondriest.com/pdf/hydreon_rg-11_manual.pdf)
2 pins pour alimentation 12VDC
2 pins pour sortie de relai

Thread 85 (2019-02-17):

PCB - Girouette

yoangp, 2019-02-17:
- Girouette de [Sparkfun Weather meters](https://www.sparkfun.com/datasheets/Sensors/Weather/Weather%20Sensor%20Assembly..pdf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)
Besoin de GND et sortie analog. La sortie analog doit être connectée à une résistance de 10K au 5V, car dans la girouette c'est seulement une résistance qui change, donc il faut créer un diviseur de tension externe.

ou

[Girouettee de Davis](http://cactus.io/hookups/weather/anemometer/davis/hookup-arduino-to-davis-anemometer)
Besoin de GND, 5V et sortie analog. La girouette a un potentiomètre interne monté en diviseur de tension qui fait varier la sortie de 0 à 5V.

yoangp, 2019-03-03:
Analyse pour voir si possible d'éliminer la switch pour sélectionner entre les girouettes Sparkfun et Davis:

-Valeurs de résistance girouette Davis: 0 à 20k
-Valeurs de résistance girouette Sparkfun: 0,688k à 120k

Si les deux girouettes utilisent le même montage en diviseur de potentiel avec tension de référence de 4,7V et une résistance sur le PCB de 10k ça donne les ranges de voltage suivant:

-Valeurs de tension girouette Davis: 0V à 3,13V
-Valeurs de tension girouette Sparkfun: 0,3V à 4,34V

Ça semble acceptable comme plages il me semble.

Le courant entre la résistance Vref de 4.7V et le gnd sera:
I max (avec R = 10k): 0.47mA (potentiomètre à 0k avec girouette Davis)
I min (avec R = 120K + 10K) : 0.04mA (résisance max dans la girouette Sparkfun)

Je trouve que ça a l'air vraiment faible comme courant, donc plus facile d'être affecté par des perturbations électromagnétiques (passage d'un fils électrique à proximité, etc), mais en même temps le pire c'est le 0.04mA dans la Girouette Sparkfun et c'est exactement comme cela qu'il est conseillé de l'utiliser. Anyway, je pense qu'on peut l'essayer comme ça et voir ce que ça donne. On pourras toujours changer la valeur de la résistance du diviseur de tension ou le tension et la tension de référence sur le 12V si on a des problèmes de mesure. De toute façon, la girouette c'est la mesure la moins critique de tous nos capteurs il me semble.

En conclusion: J'enlève la switch et il y aura juste 2 fils à connecter avec les 2 modèles de girouettes. Le fils qui connecte normalement le 5V sur la girouette Davis sera ni utilisé ni connecté.

Le seul changement à faire sera à sélectionner dans le code quel modèle de Girouette est utilisé afin d'utiliser la bonne table de correspondance pour la valeur de tension analogique versus direction du vent.

Thread 86 (2019-02-18):

PCB - Anémomètre

yoangp, 2019-02-18:
- Anémomètre [Sparkfun](https://www.sparkfun.com/datasheets/Sensors/Weather/Weather%20Sensor%20Assembly..pdf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)

ou

- Anémomètre [Davis](http://cactus.io/hookups/weather/anemometer/davis/hookup-arduino-to-davis-anemometer)

Les deux fonctionnent avec 2 pins de switch qui s'activent à chaque tour complet de l'anémomètre
Sur entrée digitale avec pull-up de 4.7k au 5V
La différence c'est que la vitesse du vent des deux anémomètres n'est pas pareille pour une rotation. À paramètrer dans le code selon l'anémomètre installé.

LoupHC, 2019-03-11:
J'aurais le goût de tester ces deux capteurs météo aussi tant qu'à faire des tests :
https://abra-electronics.com/sensors/sensors-temperature-en/sens-ef10121-wind-speed-sensor-anemometer-three-aluminium-cups.html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
Et
https://abra-electronics.com/educational-kits-trainers/educational-kits/arduino-educational-kits/sen0170-anemometer-kit-0-5v.html

Celui à 35$ est ridiculement pas cher et simple et celui à 100$ est en alluminium, potentiellement plus durable que ceux en plastique de Davis Instruments et Sparkfun

yoangp, 2019-03-12:
Ok, Je jetterai un coup d’oeil pour voir si ces sondes seront
automatiquement compatibles..

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

Thread 87 (2019-02-18):

PCB - Lora

yoangp, 2019-02-18:
Module à implanter:

https://www.aliexpress.com/item/LoRa-E32-TTL-100-long-range-UART-SX1278-433mhz-100mW-SMA-antenna-wireless-module-3km/32918242151.html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,searchweb201602_1_10065_10130_10068_10547_319_317_10548_10696_453_10084_454_10083_10618_10139_10307_537_536_10902_10059_10884_10887_321_322_10103,searchweb201603_51,ppcSwitch_0&algo_expid=3622036b-d182-48c1-9cd1-bf168ac30310-29&algo_pvid=3622036b-d182-48c1-9cd1-bf168ac30310

yoangp, 2019-02-18:
Mode | M1 | M0 | Explanation
-- | -- | -- | --
Normal | 0 | 0 | UART and wireless channel is good to go

yoangp, 2019-03-03:
Celui-là maintenant: https://www.aliexpress.com/item/868MHz-SX1276-LoRa-100mW-Serial-Port-Wireless-Transceiver-E32-868T20D-868-MHz-IoT-Module-RF-Transmitter/32953427158.html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,searchweb201602_1_10065_10130_10068_10547_319_317_10548_10696_453_10084_454_10083_10618_10139_10307_537_536_10902_10059_10884_10887_321_322_10103,searchweb201603_60,ppcSwitch_0&algo_expid=c2755db7-56d3-40dd-a2e5-6c051e4573cf-0&algo_pvid=c2755db7-56d3-40dd-a2e5-6c051e4573cf&transAbTest=ae803_4

jayserf, 2019-04-28:
A noter que ce modele est UART.
En essayant de prototyper avec MySensors librairie, ca semble supporter juste du SPI pour LoRa avec chipset SX1276 :-(

Alors faites attention au compatibilite hardware vs librairies radio avant d'acheter.

j'ai commandé qqs uns de cela pour faire du dev plus tard cet été...
https://www.aliexpress.com/item/SX1278-LoRa-module-Anxinke-LORA-spread-spectrum-wireless-module-RA-02/32964176718.html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

yoangp, 2019-04-28:
Ok, merci Jason.

Bon début de saisons!

Yoan

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

yoangp, 2019-05-14:
Bon, ben, j'ai fait une petite revue de la partie sur le module Lora. Jason, le module que tu proposes fonctionne en 3,3V. J'ai cherché un module équivalent avec le dc-dc converter 5V à 3,3V, level shifter  pour la communication et antenne inclus sans rien trouver de bien concluant.

Si on veut avoir un prototype cette année, voici ma proposition, je laisse tomber la partie Lora sur le prochain PCB. Avant d'intégrer cela à un potentiel Otomate V3, on pourra toujours tester que ça va vraiment marcher via le shield https://www.dragino.com/products/lora/item/102-lora-shield.html. Même juste avec ce shield, il y a une grosse job à faire de programmation pour faire fonctionner tout ça dans le code de l'Otomate d'après moi.

Je me suis donné 30h pour terminer le prototype d'ici le 1er juillet, incluant finir le pcb, commander les pièces et faire le montage, et il n'y a pas de façon de faire ça simple pour le module Lora intégré. Désolé!

yoangp, 2019-05-14:
Infos pour commencer avec tout cela éventuellement: https://www.youtube.com/watch?v=duwUwXt-hs8

jayserf, 2019-05-17:
a man I love that guy, awesome videos!

Yoan, no problem! doesnt have to be integrated I can always test with a
3.3V supply / buck or something like this (which i have)
https://www.aliexpress.com/item/New-Socket-Adapter-plate-Board-for-8Pin-NRF24L01-Wireless-Transceive-module-51/32642877857.html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

after checking the pins...

or just get a shield, thats a nice one you found.

Amazing for a v2 proto for july 1st. also ambitious :-)
good luck and i'd be happy to look at it any time. Hope the v2 is easier
than the v1 now that we have some experience!

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

Thread 89 (2019-02-22):

PCB - Choix des connecteurs

LoupHC, 2019-02-22:
On a vu l'an passé les problèmes qui peuvent être occasionnés par des connecteurs interchangeables (l'histoire de Reid qui a brûlé une diode du driver en inversant la sortie moteur et le input).
Donc pour partir du bon pied cette année je propose qu'on revoit notre code de connecteurs!

Il y a deux types de connecteurs qui se plugguent sur Aliexpress, [ceux-là](https://www.aliexpress.com/item/10-Pcs-Pitch-3-5mm-Angle-4way-pin-Screw-Terminal-Block-Connector-Green-Color-T-Pluggable/564809969.html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,searchweb201602_1_10065_10130_10068_10547_319_317_10548_10696_453_10084_454_10083_10618_10139_10307_537_536_10902_10059_10884_10887_321_322_10103,searchweb201603_51,ppcSwitch_0&algo_expid=7b20744f-8807-4b70-b67c-1f44a4596277-35&algo_pvid=7b20744f-8807-4b70-b67c-1f44a4596277 (on va les appeller type 1) et [ceux-là](https://www.aliexpress.com/item/10pairs-Solderless-docking-2EDGRK-5-08-2p3p4p5p6p7p8p9p10p-pluggable-terminal-block-2-24P-two-wire-connection/32845728247.html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,searchweb201602_1_10065_10130_10068_10547_319_317_10548_10696_453_10084_454_10083_10618_10139_10307_537_536_10902_10059_10884_10887_321_322_10103,searchweb201603_51,ppcSwitch_0&algo_expid=7b20744f-8807-4b70-b67c-1f44a4596277-2&algo_pvid=7b20744f-8807-4b70-b67c-1f44a4596277 (on va les appeller type 2).

yoangp, 2019-02-22:
Intéressant!
C'est sur que si on y va pour des connecteurs 2,3,4,5,6 pins X 2 types ça fait pas mal de possibilités de connecteurs pour éviter qu'un conneteur se ramasse à être branché au mauvais endroit.

L'autre affaire, que tu dis pas directement, mais que tu as surement déjà pensé, c'est qu'on pourrait quand même dire que si des entrées ou des sorties sont similaires, elles pourraient être sur le même type de connecteur vu qu'il y a pas de danger de faire sauter de quoi. Exemple, on pourrait dire que:
- Les sorties des 3 relais extra utilisent les même types de connecteurs.
- Les sorties des 2 moteurs utilisent les même types de connecteurs.
- etc.

L'autre affaire, c'est l'hiver. Je pense qu'on en a déjà parlé, mais c'est certain que si le contrôleur n'est pas utilisé pendant 4 à 6 mois, il va avoir une meilleure durée de vie dans la maison que dans la serre. Sans compter que si quelqu'un veut reprogrammer sur contrôleur au chaud dans la maison avec son ordi (mais là c'est vrai qu'il peut juste arracher l'Arduino du PCB de l'Otomate). Est-ce qu'on se donne le trouble de trouver comment les gens peuvent rentrer leur coutrôleur?  Le but de mon affaire, c'est que probablement que les connecteurs ne peuvent pas sortie des cable gland sans défaire le fil du connecteur. Et pour moi défaire les fils des connecteurs c'est pas une bonne option. Avec l'Otomate 2018, il était possible de défaire tous les connecteurs externes, dévisser la boîte et rentrer la boîte au complet. Là, je dirait que le plus évidant serait de défaire les connecteurs du PCB, dévisser le pcb et le rentrer dans la maison. Pour moi ça serait le best.

LoupHC, 2019-02-22:
Une solution potentielle pour tout déplugger en dehors de la boite pour pas trop cher :
- jumeler ce type de [connecteur à vis](https://www.aliexpress.com/item/IP67-Waterproof-IP67-T-Shape-Junction-Box-Connector-3-Pin-250V-15A-Cable-Wire-Gland-Sleeve/32812065944.html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,searchweb201602_1_10065_10130_10068_10547_319_317_10548_10696_453_10084_454_10083_10618_10139_10307_537_536_10902_10059_10884_10887_321_322_10103,searchweb201603_51,ppcSwitch_0&algo_expid=7526e077-7735-4343-b6c7-86ec470916f6-33&algo_pvid=7526e077-7735-4343-b6c7-86ec470916f6)
J'en ai commandé un qui est arrivé ce matin! Les vis sont plus grosses, c'est vraiment mieux fait que les connecteurs étanches bleus.
- avec ce type de [connecteur dépluggable](https://www.aliexpress.com/item/10-pairs-2-3Core-BLACK-Waterproof-pigtail-20cm-long-each-male-and-female-male-connector-s/32761066190.html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,searchweb201602_1_10065_10130_10068_10547_319_317_10548_10696_453_10084_454_10083_10618_10139_10307_537_536_10902_10059_10884_10887_321_322_10103,searchweb201603_51,ppcSwitch_0&algo_expid=7526e077-7735-4343-b6c7-86ec470916f6-29&algo_pvid=7526e077-7735-4343-b6c7-86ec470916f6)
Ça reviendrait, avec le cable gland, à genre 6$ la sortie de sonde... pas si pire. PAr contre je sais pas s'ils ont du fil avec calibre suffisant pour avoir le même principe avec le fil de moteur par exemple...

LoupHC, 2019-02-22:
Honnêtement je pense déjà que s'il faut dévisser tout le circuit, c'est déjà trop de trouble et les gens le feront pas... les connecteurs internes je vois ça plus pertinent peut-être si quelqu'un doit faire un swap de circuit parceque le siens est défectueux... ou veut changer le filage sans tout démonter son setup...

yoangp, 2019-02-24:
Pour ce qui est d'enlever le circuit de la boîte, il y a peut-être de quoi qu'on peut trouver qui permet de déclipser ou dévisser à la main le pcb de la boîte vraiment rapidement (vis papillons pour pcb?). Ça n'a pas besoin de tenir super fort, la boîte ne bouge pas.

Une option, 4 vis comme ça dans les 4 coins, on même juste deux dans les coins opposés + 2 snaps dans les autres coins:
https://www.ebay.com/p/15-Pieces-M5-X-10mm-304-Stainless-Steel-Wing-Bolt-Butterfly-Screw-Bolt/1666263379

Sinon, je suis vraiment pas chaud pour les connecteurs waterproof à vis.
- Ça coûte cher par rapport à des cable gland juste pour entrer un fils rond ordinaire dans la boîte
- C'est une étape de plus à monter
- C'est un risque de plus de mauvaise connection car on introduit un connecteur de plus sur chaque câble.

De toute façon, en y repensant bien, mon guess c'est que la majorité des gens vont laisser le circuit en place tous les hiver. Ils vont avoir un millions d'affaire plus urgentes à faire que de rentrer le circuit dans la maison. Dans ce cas, on se casse peut-être trop la tête à faire que ça soit rapide et facile à enlever. C'est certain que si le circuit est mort (on met déjà pas mal d'effort pour que ça arrive le moins souvent possible), il faut que ça soit minimalement facile de remplacer le circuit. Je pense que enlever 4 vis et déplugger tout les connecteurs du circuit est assez simple selon moi.

En bref, mon gros panchant:
- 4 vis dans les coins du pcb
- Cable gland ordinaires
- Pas de connecteurs en plus.

Qu'en dit-tu? Si tu es fortement en faveur de remettre des connecteurs waterproof à vis, parlons-en avec Reid et d'autres geeks du réseau pour avoir leur opinion d'utilisateurs.

LoupHC, 2019-02-24:
La boîte que je t'ai envoyé a seulement un point d'attache à chaque extrémité, donc effectivement deux bolts papillons ça serait parfait.
Faut voir s'il y aurait pas moyen de dévisser le circuit ET la plaquette d'acrylique en même temps. Sinon ça fait beaucoup de pièces à gérer dans ses mains en meme temps.

Pour les connecteurs étanches, effectivement je pense que le mieux sera de demander l'avis des gens en temps et lieux... c'est un bon point que tu soulèves... rendu là c'est pas ben ben plus compliqué d'enlever le circuit vs dévisser tous les connecteurs.

yoangp, 2019-02-24:
D'accord avec toi pour le dévissage et la plaque d'acrylique. On pourrait reprendre l'idée de ce montage:
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

Le circuit est monté sur la plaque d'acrylique et c'est la plaque d'acrylique qui est vissé à la boite. Sauf que dans notre cas, ça serait plutout l'inverse, le pcb en dessous, l'acrilique sur le dessus avec spacers. Ou bien le PCB est vissé direct sur la boîte, le plaque d'acrilique est plus petite et tient sur des spacers ailleurs sur le pcb, ou trous dans l'acrylique pour dévisser les vis qui tiennent le pcb à la boite. En tk, pleins d'options à analyser. On est vraiment rendu à se faire un dessin du montage...

yoangp, 2019-02-28:
Proposition pour connecteurs pour ne pas avoir de risque de brancher à la mauvaise place:

Description   connecteur | Pins connecteur | Types connecteur
-- | -- | --
Temp + hum | 8 | 1
Capteur Pluie   + light sensor | 7 | 1
Girouette +   anémomètre | 5 | 1
24VDC | 2 | 1
Alarme | 2 | 2
Moteurs | 4 | 1
Relai extra | 4 | 2
Relai extra | 4 | 2
Relai extra | 4 | 2

yoangp, 2019-03-03:
Mise à jour:

Description   connecteur | Pins connecteur | Types connecteur
-- | -- | --
Temp + hum | 8 | 1
Capteur de   lumière | 3 | 1
Girouette +   anémomètre + Capteur pluie | 8 | 2
24VDC | 2 | 1
Alarme | 2 | 2
Moteurs | 4 | 1
Relai extra | 4 | 2
Relai extra | 4 | 2
Relai extra | 4 | 2

Thread 90 (2019-02-22):

Assemblage du boitier

LoupHC, 2019-02-22:
J'ai eu un flash en regardant ce modèle spécifique du (iGrow)[https://www.greenhousemegastore.com/equip/controls-measuring-tools/environmental-controls/igrow-1400-greenhouse-controller]
Le circuit est bolté sur le couvercle!
C'est intéressant comme idée, comme ça on peut garder le clavier à proximité du circuit même en ouvrant la porte. Faut juste s'assurer que les relais seront pas trop collés aux bords de la boite pour pouvoir ouvrir la porte.

yoangp, 2019-02-22:
Intéressant,

Il y a plusieurs choses à considérer.
- L'écran finalement n'as pas à être connecté directement au pcb, car je me connecte comme sur l'Otomate 2018, c'est-à-dire via le petit connecteur I2C sur le côté qui est pas full pratique via un flat cable 4 conducteurs à un header sur le PCB. Donc l'écran peut aussi être flippé ou positionné ou qu'on veut. En tout cas, c'est pas encore final, il faut y penser pour que ça soit le plus simple.

- Admettons qu'on five le PCB au couvercle, il faut penser comment les switchs manuelles vont être accessible, si c'est via des trous dans le couvercle, le problème c'est que les switchs sont vraiment moins longues que les relais, les condo, etc. L'autre affaire, c'est le paquet de cables, s'ils sont pris dans un (des) cables gland, comment on peut ouvrir la porte? Ça fait méchamment du filage de surplus à avoir dans la boîte pour que le couvercle s'ouvre...

- Pour revenir aux switchs, c'est peut-être une bonne affaire si elles sont accessibles juste dans la boîte, ça veut dire qu'il faut pas y toucher (sauf bris majeur de l'arduino ou bug informatique ou etc.).

- Il va falloir voir c'est quoi les options de spacers pour tenir le pcb/mettre une plaquette devant, etc. Je sais pas si c'est encore une bonne idée de mettre une rail comme en 2018. Une rail c'est pratique quant il faut pouvoir connecter plein d'affaires dessus. Là peut-être jusque 4 vis dans les coins ferait l'affaire.

- Pour les cables gland, le Farmbot a fabriqué un seul cable gland sur mesure... Genre de long rectangle en 2 morceaux en caoutchouc avec tous les trous pour les cables dedans.

- Ça prendrait une genre de vue 3D de la patente je crois pour se faire une bonne idée.. Éventuellement un dessin Sketchup. Mais, en tout cas, si au moins on se fait une bonne idée de comment ça pourrait s'assembler facilement, on saura comment placer les composantes sur le pcb.

LoupHC, 2019-02-22:
- J'aurais inversé le PCB face vers l'intérieur... mais à bien y penser, ton argument des cables me convainc complètement...
- Oui je pense aussi que c'est une bonne idée les switchs à l'intérieur du boitier!
- Perso je laisserais faire le rail pour mettre des vis aux quatre coins, et donc on pourrait adapter assez flush le PCB aux dimensions de la boîte.
- Pour un autre projet j'avais trouvé des spacers sur digikey qui fittaient parfaitement avec les boites de polycase! Je pourrai les retrouver au besoin!
- le dernier détail qui me gosse, c'est le clavier... est-ce qu'on le fixe dans la boîte? C'est risqué de faire entrer autant d'humidité à n'importe quelle heure de la journée dans le circuit je trouve...
Est-ce qu'on le fixe à l'extérieur de la boîte? Ça va être chiant de gérer le flat cable du clavier si on a à ouvrir la boîte...à cogiter...

LoupHC, 2019-02-22:
Oh j'ai une idée finalement!! On instale le clavier au dessus de la charnière!! Comme ça pas de torsion du flat cable... faut juste que la boîte soit assez mince pour que ça marche...

LoupHC, 2019-02-22:
Avec une boite comme ça ça serait limiter correct :
https://www.polycase.com/wq-50

LoupHC, 2019-02-24:
Autre idée (plus étroite par contre) :

LoupHC, 2019-02-24:
[Problème réglé : ] (https://www.aliexpress.com/item/50pcs-lot-2-54mm-Board-Spacer-1-40P-17mm-Long-Pin-Header-Straight-Single-Row-Double/32355465352.html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,searchweb201602_1_10065_10130_10068_10547_319_317_10548_10696_453_10084_454_10083_10618_10139_10307_537_536_10902_10059_10884_10887_321_322_10103,searchweb201603_51,ppcSwitch_0&algo_expid=a042329a-93a0-4798-89b1-cc57835917e5-1&algo_pvid=a042329a-93a0-4798-89b1-cc57835917e5)
On pourra mettre du heat shrink autour pour éviter d'avoir trop de métal exposé. Je dis qu'on prend la grosse boîte!

yoangp, 2019-02-24:
Je suggère qu'on essaie Sketchup pour faire le design du montage mécanique de l'Otomate.

Procédure:
1. Créer un compte Sketchup cloud-based (gratuit):
https://www.sketchup.com/plans-and-pricing/sketchup-free
2. télécharger le modèle courant de l'Otomate disponible sur dropbox (https://www.dropbox.com/home/autoconstruction_private/AutoConstruction%202019/projet-Otomate)
Document nommé Otomate V2.skp
2. Une fois danas Sketchup, avec le menu en haut à gauche, ouvrir un dossier, puis faire "Add model", puis "Browse", puis loader le modèle dans ton compte Sketchup.
3. Une fois terminer, il y a une option "Download" pour télécharger le modèle et ainsi mettre la dernière version dans Droxbox.

Pour l'instant il y a juste un rectangle de 150mm x 300mm qui ressemble à ça:
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

yoangp, 2019-02-24:
Pour revenir à tes commentaires Loup, je comprends pas ou tu veux mettre le clavier et ce que tu veux faire avec les spacers pour les headers? Je comprends pas non plus sur quoi tu base la recherche du format de la boîte et qu'est-ce que ça veut dire une boite plus mince? Plus de détails stp!

yoangp, 2019-02-24:
Pour les vis sur la boite, si je comprend bien il y a 2 insets en métal à ces places là (image ci-dessous) pour des vis en métal, est-ce bien cela et c'est bien ce que tu propose pour visser le PCB?

L'affaire c'est que si le pcb est collé dans fons de la boîte, les autres protubérances de platiques pour visser des vis ailleurs dans le fond de la boîte risquent d'interférer avec les soudures et les petits bout de pins des pièces through hole sur le revers du pcb.

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

LoupHC, 2019-02-24:
Imagine [cette boite](https://www.polycase.com/wq-50) face à toi qui s'ouvre comme un livre.
Si le clavier est branché dans le pcb à travers le couvercle va falloir le déplugger à chaque fois qu'on ouvre la porte, c'est pas pratique.
Maintenant imagine que la charnière est située en bas de la boite, qu'on déclipse par en haut. Comme la flexion se fait dans le sens de flexion naturel du flat cable du clavier, c'est beaucoup moins pire.
Par contre comme le flat cable est assez court (8,5cm), faut pas que la boîte soit trop épaisse sinon on n'arrivera pas à brancher le clavier même le couvercle fermé.

LoupHC, 2019-02-24:
Le header-spacer permet de gagner quelque cm de de hauteur au niveau du connecteur.
À 8,5cm(flat cable) + 2 cm(spacer) ça nous donne 9,5cm de jeu

LoupHC, 2019-02-24:
J'avais pas pensé aux bosses de soudure... au pire on met un washer?

LoupHC, 2019-02-24:
Si on visse le circuit après la feuille d'acrylique et la feuille d'acrylique au boitier avec des spacers ça règle aussi le problème!

yoangp, 2019-02-24:
Ok, je comprend ton idée pour le clavier... C'est bien, mais je vais y penser encore un peu pour voir si j'ai pas d'autrs options à te proposer. Il y a toujours une rallonge de flat cable qui est une autre option.

Pour la grosseur de la boîte, ça prend une surface interne de 450cm2 environ, donc la boite WQ-50 est pas mal trop petite d'après moi. Aussi, euh, ça serait bien si le circuit pouvait fitter dans la boite de métal à 16$ d'Addison.. Pour l'option pas cher...

LoupHC, 2019-02-24:
Boitier retenu  :
https://www.polycase.com/yh-100804

yoangp, 2019-02-27:
Référence pour clearances holes sur le pcb pour fiter avec vis 10-32 aux quatre coins du boîtier retenu:
http://faculty.etsu.edu/hemphill/tap_drill.htm
= Mouting pad avec trou de 5.5mm sur le PCB dans KiCAD

yoangp, 2019-02-28:
J'ai mis à jour le dessin de coupe du PCB avec les trous correspondant à ceux de la boîte. Est-ce que tu pourras double vérifier les dimensions que j'ai utilisé? C'est un peu weird avec les coins à 45 degrés.
Voici ma feuille de calcul pour les dimensions:

  | in | mm
-- | -- | --
Longueur boîte | 10,069 | 255,7526
Longueur entre   trous | 8,25 | 209,55
Longueur entre   deux (car coins en 45 degrés ) | 9,1595 | 232,6513
Bord du pcb   par rapport au trou |   | 10
  |   |  
Largueur boîte | 8,069 | 204,9526
Largeur entre   trous | 6,25 | 158,75
Longueur entre   deux (car coins en 45 degrés ) | 7,1595 | 181,8513
Bord du pcb   par rapport au trou |   | 10
  |   |  
Longueur pour   trous du milieu |   | 104,775
  |   |  
Largeur pour   trous du milieu |   | 79,375

yoangp, 2019-03-10:
Allo!

J'espères que tout va bien pour vous en ce début de mars! Moi j'essaie d'avancer la partie physique du contrôleur petit à petit, au travers de mon nouveau travail..

Voici mes réflexions pour le montage de l'écran et du claviers
- Finalement, je ne metterais pas de plaque de plastique pour protéger le circuit. Je ferais en sorte qu'il faut ouvrir la boîte juste s'il y a un problème majeur. C'est à dire; changer un fusible ou autre pièce défectueuse, activer les switches manuelles d'urgence.
- Voici les idées de placement de l'écran et du clavier sur la boite:
Sur les images ci-dessous, il y a une option ou je considère la boite no YH-100806 qui est plus épaisse pour mettre l'écran sur le côté de la boite. Si le clavier est sur le dessus du couvercle, il faut absolument une rallonge de câble. Ça semble quasi impossible de trouver un cable male-femelle 8 pins, donc il faut une rallonge femelle-femelle + afadpteur male-male, c'est un peu poche comme montage je trouve..
-En tout cas, dites-moi quelles options vous semble préférable ou si vous avez d'autres idées. Merci! PS: Il faut regarder les images à l'endroit pour avoir la bonne orientation de la boîte, les lignes sur la page devraient être à l'horizontal, désolé pour les sens mélangés.
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

LoupHC, 2019-03-10:
Je vote pour le clavier et l'écran à l'avant du boitier!
Si on veut s'épargner le paneau d'acrylique, on pourrait aussi faire imprimer un grand rectangle blanc sur le couvercle, avec une fenêtre transparente pour voir le clavier, qui est fixé directement au couvercle avec des bolts auto-scellantes et des spacers.
Pour le clavier, j'irais avec une rallonge, avec en masse de jeu, vu que le couvercle serait imprimé ça serait pas trop grave même si c'est un peu moche, quelque chose comme :
- https://www.digikey.ca/product-detail/en/adafruit-industries-llc/3633/1528-2642-ND/7918051
+
- https://abra-electronics.com/interconnects/connectors/connector-housing/1907-pololu-01-254mm-crimp-connector-housing-1x8-pin-10-pack-1907-pololu.html

LoupHC, 2019-03-10:
À partir de 25 boîtes, ça revient à 10$ par boîte pour l'impression, et 15$ par boite pour le perçage sur deux faces (couvercle et dessous).

yoangp, 2019-03-10:
- Ok pour clavier sur le couvercle avec rallonge... Moi ce que j'ai trouvé de meilleur pour l'instant c'est : https://www.digikey.ca/product-detail/en/te-connectivity-amp-connectors/A9BBG-0804F/A9BBG-0804F-ND/161772 (pas de montage à faire, le cable est déjà complet), et vu que tout ces connecteurs sont femelle-femelle ça prend aussi : https://abra-electronics.com/interconnects/connectors/headers/male/1065-pololu-double-sided-straight-male-snappable-header-1-row-x-40-pins-1065-pololu.html
- Ok pour impression couvercle
- Pour l'écran je vettrait des spacer sur le pcb, donc par de trous dans le couvercle et pas de fils

T'en penses quoi?

LoupHC, 2019-03-10:
Yes ça a ben de l'allure ça!
On pourrait mettre la charnière dans le bas de la boîte, pour pas tordre le flat cable quand on ouvre le couvercle, qu'est-ce que t'en penses?
Aussi je calcule ça... avec l'extension de 10cm et le flat cable du clavier de 8cm, on est un peu juste avec la boîte de 7 po de haut. La boîte de 5po de haut(YH-100804) ferait la job à mon avis c'est la même hauteur que le boitier qu'on avait au dernier atelier.

yoangp, 2019-03-10:
Design global choisi pour l'assemblage pcb/boiter/écran/clavier:

https://drive.google.com/file/d/1wt2NEwKWlfCWdSCmHsxkXo7DZFxuQrOY/view?usp=sharing

yoangp, 2019-05-19:
Allo Loup,

Est-ce bien un sample du https://www.icotek.com/en/kel-dpz-24/ que tu as reçu? Ça va faire l'affaire pour le nombre de trous et la grosseur des trous d'après toi?

LoupHC, 2019-05-19:
yep! On a pas loin de 30 trous là dessus!

LoupHC, 2019-05-19:
J'ai juste hâte de voir si le "stress relief" est adéquat mais à part ça c'est vraiment bien fait et solide

jayserf, 2019-05-23:
wow these are super cool!

best find ever! tres hate de pas avoir de cable glad si ca marche :-)

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

Thread 91 (2019-02-22):

PCB - Prototypage

yoangp, 2019-02-22:
Moi je pense qu'on va oublier quelque chose de critique et qu'il va falloir faire faire au moins 2 pcb comme en 2018, même si on est pas en production. C'est pour cela que je proposais de montrer un pcb à la main et le tester au fur et à mesure. L'autre affaire, c'est que dans ma tête c'est quand même un gros travail d'indiquer tous les petits détails que les monteurs de PCB way devront suivre, si en plus le design risque de changer significativement, il me semble que c'Est le double de travail. Bon, peut-être que je sous estime le temps de souder un seul pcb à la main..

Sinon, côté coût: Une batch de minimum 5 pcb 30cm x 15cm pas montés c'est 79$ avant shipping. Ton prixà 330$ est-ce que c'est sans le shipping? Et pour combien de pcb montés, 3 ou 5?

La drop du prix à partir de 20 unités c'est surment qu'à partir de ce volume ils font les soudures dans une machine spéciale.. Je ne pense pas qu'on devrait se lancer dans un volume aussi grand sans encore savoir quels sont les défaut de notre design.

LoupHC, 2019-02-22:
Le 330$, c'était incluant le shipping.
moitié pour imprimer 5 pcbs
moitié pour en assembler 2
Là je me rend compte qu'on a vraiment pas les mêmes chiffres je me demande si j'ai manqué des trucs, je vais réessayer.
Je pense que c'est important de demander l'assemblage, ne serait-ce que de un. La dernière fois on a dû déssouder tous les capteurs temp/humidité parce qu'on avait skippé cette étape là. Mais c'est vrai que si on a aucune pièce surface mount, techniquement on aura aucun problème à le faire nous-même.
Au pire peut-être qu'on peut leur dire de nous envoyer les 4 pcb d'extra des quils sont fait et on en assemble chacun de notre côté?

yoangp, 2019-02-24:
Ma proposition, c'est est-ce qu'on s'occupe d'organsier la procédure
d'assemblage plus tard pendant l'été, plutôt que tout de suite quand on a
besoin d'avoir un prototype fonctionnel à installer ASAP.

Voici donc ma suggestion:
1. Faire faire 5 pcb vide shippés dès que possible.
2. On les assembles nous même et on fait des ajustement au pcb en fonction
de nos tests.
3. Si possible, on peut déjà utiliser ces pcb comme prototype à faire
fonctionner dès le début de la saison.
4. Lorsqu'on aura le temps en cours d'été, faire une nouvelle demande de
fabrication de 5 pcb, avec 1 ou 2 unités montés.
5. Recevoir les nouveaux pcb, vérifier les problèmes de montage et swaper
les nouveaux pcb sur les serres de tests.

Comme ça, on a minimum 2 runs de pcb avant de lancer la production l'hiver
prochain.
Qu'est-ce que tu en penses?

Le ven. 22 févr. 2019, à 17 h 55, LoupHC <notifications@github.com> a
écrit :

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

LoupHC, 2019-02-24:
Je suis d'accord avec ce plan-là moi!

Thread 92 (2019-02-24):

PCB - schematics

LoupHC, 2019-02-24:
Salut Yoan!
Quelques petits commentaires, j'attend ton ok pour faire les modifications dans les schematics:
- pour la protection des inputs, je remplacerais les ptc par des résistances 220ohm, je ne trouve rien en TH qui face la meme job que dans leur circuit :
https://www.rugged-circuits.com/10-ways-to-destroy-an-arduino/
avec une résistance, on n'aura pas l'effet fusible, mais au moins on est sûr de rester en bas de 20mA meme avec des spikes de 50V
- pour l'autre ptc avant le driver de relais, les transistors vont fuser avant elle, donc je ne pense pas que ça vaille la peine non plus...
- les deux ptc avant les modules dc-dc, quelle est leur fonction?
- est-ce qu'on met vraiment un fusible sur le 24v en plus du circuit de protection contre les surtension du PS?
- quelle est la fonction de la switch pour changer de modèle d'anémomètre?
- il n'y a pas de fusibles en série avec les moteurs, est-ce que c'est voulu?

yoangp, 2019-02-25:
- Pour les inputs, j'avais trouvé le PTC suivant: https://www.digikey.ca/product-detail/en/amphenol-advanced-sensors/YQD100N1000/235-1259-ND/2324591
C'est le seul qui semblait faire environ la job, résistance de base de 1kohm, courant trip 30mA. J'ai vu que 1kohm de résistance pouvait être correct sur les inputs.
Tu peux regarder ça de ton bord, mais si on laisse faire le ptc et qu'on met juste une résistance, alors je m'assurerait qu'elle est assez élevé pour qu'on moins 12V en entrée ne fasse pas buster le courant max permi sur les inputs du Atmega.

- ok pour enlever le ptc avant le driver de relais

- Les deux ptc avant les modules dc-dc c'était pour limiter le courant qui rentre dedans si ils font défaut. Mais je sais pas si c'est vraiment nécessaire. Ils sont vraiment pas mal bien protégés ces nouveaux dc-dc. Faudrait voir dans les datasheets s'ils recommandent un fusible en avant, avec l'ancien module que l'avais sélectionné c'était recommandé. Sinon, regarder sur le net si c'est une bonne pratique.. Si pas nécessaire, on les enlève.

- Fusible sur le 24v; je pense que c'est important, car c'est la première protection si le DC-DC converter 24V fait défaut ou laisse passer un spike de voltage relativement gros. Je ne sais pas vraiment à quel point le surge protector élimine tout.. Je pense que ça empêche de détruire le power supply, mais c'est peut-être pas suffisant pour que la sortie du DC-DC reste clean pendant la surtension...

- * switch pour changer de modèle d'anémomètre; voir le issue sur l'anémomètre, mais en gros c,est pour changer de modèle d'anémomètre entre Davis et Sparkfun. Davis est construit avec potentiomètre en diviseur de tension (l'output sur pin du milieu, GND et +5V aux extrémités). Sparkfun construit comme résistance variable; donc ça prend une résistsance sur le circuit pour faire le diviseur de tension. Mais on pourrait peut-être juste brancher les 2 comme une simple résistance variable, donc pas besoin de switch (mais ajustement dans le code car les valeurs de résistances et donc de tension analog ne seront pas pareilles)... Il faudrait juste regarder les valeurs de résistances dans 2 modèles et voir si ça va être relativement similaire dans les valeurs de tension lues.

- Pas de fusibles moteurs, je pense qu'on devrait vraiment mettre le courant max dans le code via les acs723. Si court-circuit moteur, ça arrête à 6A, ce qui donne pas beaucoup plus que les 100W max des moteurs.

Ciao!

yoangp, 2019-03-03:
- Je propose de remplacer les pct sur les inputs par des résistances de 1K, si les inputs sont à low (0V) et qu'il y a 24V en entrée ça fait 24mA qui passe dans la pin d'input.

- J'ai enlevé les ptc sur les DC-DC converters, la fuse de 1,5A devrait faire la job s'il y a un short dans la circuiterie d'input d'un des deux dc-dc conveter 5V et 12V.

Thread 93 (2019-03-29):

PCB - Feature pour panne d'électricité

yoangp, 2019-03-29:
Allo,

Je veux pas faire de quoi de trop compliqué pour le prototype actuel, mais il serait possible d'introduire quelque chose d'assez simple si on veut mettre l'Otomate sur un UPS, mais qu'il puisse quand même détecter une panne d'électricité. Ma proposition: Un connecteur sur lequel 2 fils sont connectés à un relais branché sur le 120V qui est alimenté en permanence. Une panne d'électricité change l'état OPEN ou CLOSE du relais qui déclenche un interupt dans l'Arduino. En bref: sur le pcb c'est juste un connecteurs et quelques résistances. De plus, externe au contrôleur, il faut un relais 120V + base relais à vis + cable et prise 120V.

Thread 94 (2019-03-31):

Circuit d'alarme

LoupHC, 2019-03-31:
Nouveau circuit (un peu) plus compliqué pour l'alarme. Il comprend deux nouveaux features :
- interruption du buzzer interne grâce à un pushbutton plutot quune switch à bascule.
- une led reste allumée tant que le problème persiste
- une fois que le problème est détecté et corrigé, le buzzer est ré-armé pour sonner au prochain problème

Le circuit comprend aussi un connecteur pour brancher une alarme externe basique avec alarme+switch_sirène
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

Description du fonctionnement :
1. Un problème (court-circuit, température trop élevée) relâche le relais qui ferme le circuit d'alarme
2. le condensateur 22uF génère un pulse unique de quelques mili-secondes
3. le pulse "arme" le circuit flip-flop pour le mettre en mode "buzzer"
4. une pression sur le pushbutton met le flip-flop en mode "muet"
5. Tant que la tension ne baisse pas au pôle positif du condensateur, le circuit reste bloqué en mode muet. Quand l'alarme est désactivée, le condensateur se décharge et est donc prêt à générer un deuxième pulse la prochaine fois que le relais se relâche.
6. la LED reste allumée tant que le relais est relâché

yoangp, 2019-05-06:
Cool! Est-ce que tu as testé ton circuit sur bread-borad ou bien on y va cowboy et on teste sur le pcb prototype?

yoangp, 2019-05-07:
Allo Loup, est-ce que tu as updaté une version du schéma avec cet ajout pour l'alarme? Je le trouve pas sur Dropbox ou dans Github. Sinon, est-ce que tu voulais que j'intègre cela au schéma que j'ai fait? Merci!

LoupHC, 2019-05-10:
Ah oui justement! J'ai modifié le circuit et ce coup-ci il marche super bien
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

LoupHC, 2019-05-10:
oups!! D33 est à l'envers!

yoangp, 2019-05-19:
Ou as tu trouvé les transistors S9013? Il n'y en a pas chez Digikey...

yoangp, 2019-05-19:
Ça aurait été cute un IC flip-flop tout en un..

LoupHC, 2019-05-19:
Hmm faudrait trouver un transistor EBC de remplacement...
je peux essayer de trouver ça...
Sinon ce site suggère qu'on peut utiliser des darlingtons pour un flip flop, en modifiant les valeurs des résistances... si c'est le cas on pourrait réutiliser le mêm ULN2075 du circuit de drive des relais
http://www.techlib.com/electronics/flipflopflash.htm
Je peux essayer de breadboarder ça vite fait cette semaine!

LoupHC, 2019-05-19:
avec des darlington en plus on pourrait brancher une alarme mega forte sur le même circuit dans soucis

yoangp, 2019-05-22:
Ajout d'une mesure du potentiel de la batterie de l'alarme pour vérifier si la batterie est trop déchargée ou déconnectée. Infos sur le diviseur de potentiel à ajouter : https://forum.arduino.cc/index.php?topic=99318.0

yoangp, 2019-05-22:
Laisse faire pour refaire le circuit, je vais essayer de trouver un équivalent au transistor: https://alltransistors.com/crsearch.php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

yoangp, 2019-05-22:
Bah! J'ai pas assez d'infos sur le transistor que tu as utilisé! C'est quoi le numéro exact du transistor que tu as pris? S9013... ? Sinon les valeurs de résistances et tout ce qui va autour doit changer. C'est plus rapide si on change rien du tout à part le numéro de transistor.

yoangp, 2019-06-01:
Loup! Si t'as quelques minutes pour me donner le numéro complet du S9013 que tu as utilisé ça serait super! J'ai besoin de cela pour vérifier la datasheet et trouver le bon équivalent chez digikey.. Merci ;-)

LoupHC, 2019-06-01:
Je n'ai rien d'autre que S9013 écris... mais n'importe quel transistor avec le pinout CBE fera la job, le max de courant C-E  correspont au courant max qui passerait dans une sirène, en haut de 500mA on est safe je pense.
Pour la tension C-E max le s9013 est raté à 25V, je pense qu'on pourrait viser quelque chose de plus élevé, par sécurité, mais en même temps c'est pas un circuit très à risque.

LoupHC, 2019-06-01:
Ça devrait le faire ça : https://www.digikey.ca/product-detail/en/central-semiconductor-corp/2N5551/2N5551CS-ND/4806921

Thread 95 (2019-04-06):

Contrôle de toit ouvrant

LoupHC, 2019-04-06:
Salut Yoan, j'ai fait une petite modif de rien sur le PCB ce matin.
Je cherchais une façon d'intégrer des connexions pour actionner des relais externes plutôt que directement les moteurs.
J'ai réalisé que la sortie moteur agit comme deux sorties 24V qui alternent entre le GND et +24V. Si on connecte chacune de ces sorties à des relais externes, qui eux sont connectés au GND, on obtient deux signaux indépendants. Quand le circuit est censé faire tourner le moteur d'un bord, une sortie est à +24V, donc active, et l'autre est à GND, donc inactive. Quand on change le sens de rotation, les états s'inverse.
Penses-tu que ça devrait marcher?

yoangp, 2019-05-06:
Allo Loup!!
Pour le toit ouvrant, ça peut potentiellement marcher pour inverser le sens du moteur, mais ça prend aussi un état OFF, donc pas le choix que d'utiliser 2 sorties de relais minimum pour le toit ouvrant. Mais surement possible, on a 3 relais extra; on peut en prendre 2 pour le toit ouvrant et 1 pour une fournaise dans ce cas.

LoupHC, 2019-05-10:
Quand le signal n'est ni open, ni close, la sortie moteur peut être considérée à off non?

yoangp, 2019-05-11:
Ok, je reformule autrement, est-ce que tu veux dire qu'on pourrait utiliser 2 relais extra pour le toit ouvrant; le premier ayant les état OFF ou OPEN et l'autre OFF ou CLOSE?

LoupHC, 2019-05-11:
non, mon idée serait d'utiliser la sortie moteur comme sortie pour toit ouvrant, vu qu'elle oscille entre trois états, OFF(circuit ouvert), Polarité1 (24V-GND) et Polarité2(GND-24V). Si on rajoute un troisième contact GND on peut avoir l'équivalent de deux sorties 24V (en les branchant comme ça : M1-GND et M2-GND) On s'appelle cet aprem?

Thread 96 (2019-05-07):

PCB - Règles de routing

yoangp, 2019-05-07:
Pour dimensions reliées au routing, commencer par copier ce qui a été fait pour Otomate V1, sinon; spec générales pour routing:

Largeur track puissance 24V:
2mm

Bus d'alimentation 5V, 12V, 24V:
2.5mm si possible, sinon 2mm

Largeur track actionnement des relais, etc.:
1.27mm (anciemment 1mm)

Largeur track de signaux sensors, IO Arduino, low power, etc: 0.635mm (0,254 pour signaux pas long entre pads serrés de l'Arduino par exemple)

Distance minimale entre tracks de signaux: 0.6mm (ref sur internet: 0.4mm)

Distance miminale entre tracks de puissance: 1.0mm

Distance minimale entre pads: 0.6mm

**Pads standards**
Épaisseur du pad à ajouter à la grosseur du trou pour avoir le diamètre du pad :
1.2mm

**Pads de puissance:**
Épaisseur minimale du pad à ajouter à la grosseur du trou pour avoir le diamètre du pad:
1.6mm

**Trous petites pièces through hole:**
Jeu de plus que la grosseur de la patte de la composante (grosseur de la composante = dia de la patte ronde ou diagonale d'une patte rectangulaire, prendre aussi la tolérance maxd de la pin pour les calculs de grosseur de trou):
0.3mm total

**Via standards:**
-Largeur pad: 1.0mm
-Grosseur trou: 0.6mm

**Via signaux:**
Largeur pad: 0.508mm
Grosseur trou: 0.3302mm

yoangp, 2019-05-07:
Loup, t'as utilisé dans méchand petits via sur l'Otomate V1. C'est ou que tu as trouvé la référence que c'était assez gros??

LoupHC, 2019-05-10:
je me rappelle pas d'avoir vu de référence pour la grosseur des vias... je crois que jai pris ceux par défaut...
est-ce que le via doit être plus gros que la trace?

yoangp, 2019-05-22:
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

Thread 98 (2019-06-19):

PCB - Preparer doc pour soumission de PCB

yoangp, 2019-06-19:
Paramètres de fabrication:

**fabrication_parameters.txt**
2 layers FR4
Finish board thickness 2mm
TOP and BOTTOM copper thickness (1.0oz)
White solder mask on both side
Black silkscreen on both side
HASL lead free finish
tolerance on drills (3mils)
minimal drill size (12mils)
minimal isolation (5mils)
minimal trace width (5mils)
PTH vias
Manufacturer code accepted on PCB
Tab-Routed panel

**CAD Package**
KiCAD 5

**Gerber files format (to validate)**
RS-274X format (Embedded D-Codes)
2.4 digits english
All files are gerber-X format, except drills (.DRILL)
origin at 0,0

**Excellon files format (*.DRILL) (to validate)**
Excellon format (Embedded Drill Rack)
Dimensions 2.4 digits OMIT LEADING ZEROS

**included files (to validate)**
*.DRILL : drill file
*.GTL : copper layer TOP
*.GBL : copper layer BOTTOM
*.GTO : silkscreen layer TOP
*.GBO :	silkscreen layer BOTTOM
*.GTS : soldermask layer TOP
*.GBS :	soldermask layer BOTTOM
*.GTP :	stencil layer TOP
*.OUT :	board outline layer
*.GD1 :	drill symbol layer
*.MOUNT :	pick and place coordinates
*.png	:	extra pcbs information

Super video pour détails sur fabrication des pcb à considérer pour top design: https://www.youtube.com/watch?v=VXE_dh38HjU

yoangp, 2019-06-24:
Création Gerber dans KiCAD 5 pour PCBWay:
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
Création drill file dans KiCAD 5 pour PCBWay:
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
Spec PCBWAY (.drl drill file de kiCAD renommé .drd, .gm1 edge cut de KiCAD renommé .gko pour correspondre aux extensions demandés par PCBway):
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
Options de fabrication sélectionnés avec PCBWay:
[Prototype PCB - Online PCB Quote - Full feature custom PCB prototype service at low cost -PCBWay.pdf](https://github.com/LoupHC/controleur-CAPE/files/3319037/Prototype.PCB.-.Online.PCB.Quote.-.Full.feature.custom.PCB.prototype.service.at.low.cost.-PCBWay.pdf)

yoangp, 2019-06-24:
Gerber et drill file:
[CAPE_Controller_schield V2.zip](https://github.com/LoupHC/controleur-CAPE/files/3319190/CAPE_Controller_schield.V2.zip)

yoangp, 2019-06-24:
Update projet kicad:
https://drive.google.com/open?id=1a0vi4IcmhUphmeWHJLTSHl-V3yY9OoP-

Thread 99 (2019-07-20):

Test du nouveau PCB

LoupHC, 2019-07-20:
Après avoir geeké autour du nouveau circuit, j'ai trouvé quelques petits bugs mineurs (rien qui compromette beaucoup le circuit) :

- les sondes de courant sont affectées par le bruit des relais (c'est des capteurs à l’effet hall), après avoir gossé un peu, avec, j'ai déterminé qu'elle devraient être relocalisées à au moins 5cm des bobines.
- inversion des lignes SDA/SCL pour la chip mcp23008
- petite erreur dans les inscriptions sur les connecteurs : +5V correspond à l'entrée analogique de la station météo et AD3 correspond plutôt à un ground protégé par une résistance 1K
- le pullup de la l'entrée analogique de la station météo (R6) doit être enlevée, ça fausse les données du capteur
- le circuit d'alarme est à refaire (même la dernière version que j'avais envoyé sur github marche pas finalement), je pourrai faire les modifs ça changera pas grand chose au routing.
- la PTC de protection des optocouplers sert pas à grand chose vu qu'ils sont déjà protégés par des résistance 10K
- le gros condo C1 sert-il à quelque chose finalement? Est-ce qu'on peut ajouter des diodes pour l'isoler des moteurs?

J'ai quelques suggestions d'améliorations aussi :
- ajouter une sortie relais en parallèle des relais on/off moteurs (pour pouvoir convertir les sorties moteurs en sorties devices)
- mettre une ptc 0,5A en série avec l’alimentation des sorties 24V actionnées par les relais 6-7-8, en cas de court-circuit, ça évitera de faire un spark de 6A
- mettre l’alimentation 12V en parallèle de l’alimentation par batterie 9v, avec diodes pour empêcher les retours de courants (comme ça, sauf en cas de panne d’électricité, c’est le power supply 12v qui alimente l’alarme
- ajouter un +gros condos du côté de l’alim 5v (pour coupures de courant brèves)
- je rajouterais une alimentation 12v sur le gros connecteur pour les sondes meteo, ça éviterait d'avoir à mettre deux fils dans le même trou!

Mais bon c'est pas grand chose... une petite soirée de touch-ups et on est all set  je dirais!
Bravo Yoan!!!

jayserf, 2019-07-31:
THAT'S awesome news guys!!!

When is the party for touch ups? I'd like to bring the beers 😁

Congratulations to both of you

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

LoupHC, 2019-07-31:
Est-ce que tu viens à l'Expo-champ le 1er septembre?
Le 17 aout on pensait monter un demo de serre automatisée pour montrer là-bas, you should join us!!

jayserf, 2019-08-01:
Great I'll be there! (for both but def on the 17)

Let me know where
And I can laser cut some plastic or wood (1/8 plywood or thicker acrylic)
if we need parts for our mini greenhouse

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

LoupHC, 2019-08-14:
Après avoir installée l'Otomate 2.0 dans une vrai de vrai serre aujourd'hui, j'ai quelques commentaires aditionnels :
- les connecteurs des 3 devices sont pas dans le même ordre que les switchs qui les overrident, c'est un peu mêlant (C'est device1-device2-device3 pour les switchs et device1-device3-device2 pour les connecteurs)
- le connecteur jack pour la brancher la batterie 9v est trop prêt de la paroi de la boîte pour mettre une plug jack ordinaire. J'ai réussi à brancher un connecteur jack à angle droit par contre mais on doit le brancher avant de visser le pcb.
- c'est difficile de déplugger les connecteurs du côté droit, on réussit à peine à glisser ses doigts entre les relais et la boîte. Une fois que le cable est installé par contre c'est facile de juste tirer sur le cable pour le déplugger.

Mais malgré ces petits détails, à date, c'est 100% fonctionnel!!!

jayserf, 2019-08-14:
Amazing!

What's up for Saturday?
Where do I meet you two?

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

LoupHC, 2019-08-15:
Hey man!
I can't anymore for saturday. Besoin urgent d'aller faire mon lavage en ville hahaha.
I chat on the phone earlier with Yoan we tought maybe we could meet up next saturday instead? (the 24) Does it fit for you?
We could meet at Croque-saison.
Testing the device, making the demo for Expo-champ, discussing lasercut acrylic cover, connectivity issues and electromagnetic noise... bref, some awesome geek-to-geek catch up!
Sounds nice to me!

jayserf, 2019-08-15:
Hey! Cool for me for this weekend, gives me more time to work on some more
nerd stuff to show you.

What about sunday? (or even this sunday.?)
Sat is the Garlic festival at our market and I dont really want to miss it
(and I should help out too), but again we only have a week

sounds good for the discussions, lots to cover and make.

weird to be making plans on github :-)

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

jayserf, 2019-08-16:
So no go for this Sunday.

Gotta deliver some roquette to lufa now 😉

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

LoupHC, 2019-08-16:
Hey it could finally happen this saturday! I changed my plans a bit, i'll be at Lingwick now all weekend. Is it still ok for both of you?
Next weekend it could only be saturday for me tho.
Sorry for the last minut call!

jayserf, 2019-08-16:
Sure, I still can, in lingwick?
Let me know so I can go to sleep early 😉

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

yoangp, 2019-08-17:
Ok, ça peut marcher pour moi aussi, sauf que je serai là un peu plus tard,
il faut que je prépare mon matériel à apporter. Je peux être là vers 10h00
à 10h30 à Croque-saisons.

Est-ce que vous pouvez envoyer une confirmation finale?

À demain!

Yoan

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

LoupHC, 2019-08-17:
Awesome!
Je suggère qu'on se retrouve chez moi au 46 route 108, Lingwick vers 10h30 pour que vous m'aidiez à amener mon stock hehe. La ferme est à 2 minutes de char!

jayserf, 2019-08-17:
Cool! I just got to figure out a car 🤔

See you there!

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

jayserf, 2019-08-17:
Hey!  for some reason I can't find your phone numbers but I'm in East
Angus. And Google says I'll be there in 20 minutes. My number is
514-781-1122

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

Thread 100 (2019-07-21):

Augmenter la durée de vie des relais-moteurs

LoupHC, 2019-07-21:
Est-ce que ça pourrait être une façon de réduire le sparking?
https://www.illinoiscapacitor.com/pdf/Papers/spark_suppression.pdf

yoangp, 2019-07-23:
J'ai fait un petit calcul rapide et je me trompe peut-être avec la formule
mentionnée dans le document, mais ça me donne une super grosse valeur de
condensateur, genre C = I*I/10 = 5*5/10 = 2.5...   2.5Farad??? Si oui,
c'est malade, mais possible et vraiment gros et vraiment cher. En tout cas,
j'ai pas encore trop approfondi l'affaire. Il faut que j'étudie les
circuits à mon travail pour voir comment ils font pour avoir une durée de
vie de 10ans..

Le dim. 21 juill. 2019, à 12 h 21, LoupHC <notifications@github.com> a
écrit :

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

yoangp, 2019-07-28:
Je pense que j'ai une solution intéressante:

1. Modifier le code pour que le fonctionnement des moteurs soit:
1.1 Actionner le relai d'inversion en premier
1.2 Délai
1.3 Actionner le relai d'activation.

Si on peut faire que les délais s'appliquent même à la configuration de l'Otomate V1, alors ce changement a un impact minimal pour les Otomates V1 tout en gardant une seule version du code. Pas d'impact si les relais s'activent pas en même temps sur l'Otomate V1. Il faudrait juste voir ce qui va se passer dans la logique de diodes des drivers de moteurs 2018..

2.Ensuite, on change les relais d'activation de l'Otomate V2 par: https://www.digikey.ca/product-detail/en/ixys-integrated-circuits-division/CPC1709J/CLA280-ND/1277135

LoupHC, 2019-07-28:
Pour la modique somme de 156$, on peut même les avoir sur les même sockets qu'avant... ;)
https://www.digikey.ca/product-detail/en/omron-automation-and-safety/G9H-210S-DC24/Z9531-ND/3475018
L'idée est bonne, et probablement beaucoup plus durable. Par contre je ne suis pas sur comment on peut rétrofitter cette logique-là sur les contrôleurs de l'ancienne version?

LoupHC, 2019-07-28:
Si on passe au solid state, faut aussi penser à des stratégies de limitation de courant, vu que c'est la raison la plus probable de défaillance des relais...

yoangp, 2019-07-28:
Pour la limitation de courant, vu que le power supply est limité à 6,5A, on est pas pire en partant..

LoupHC, 2019-07-29:
Bon point!
Est-ce que le moteur peut générer des spikes de courant lui-même?

yoangp, 2019-07-29:
Possible que le moteur génère des spikes... J'ai commandé 4 ssr, 2 pour moi et 2 pour toi si ça marche.. Le courant peak est de 40A. Courant max coutinu sans heat sink de 9A.

LoupHC, 2019-07-31:
Version chinoise de relais SSR sur sockets à 15$/unit. Compatibles avec les sockets de relais précédents :
https://www.aliexpress.com/item/32883085495.html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
Pour avoir un délais entre le relais direction et le relais on/off, un circuit comme celui-ci pourrait faire l'affaire  :
https://www.electroschematics.com/4826/delay-on-circuit/
La séquence d'activation ressemblerait à :
1. signal envoyé au driver de moteur (active ou non le relais de direction)
2. délais de 1 ms
3. activation du relais on/off

La séquence à l'arrêt serait  :
1. arrêt instantané du SSR
2. le relais de direction relâche quelques microsecondes après, le temps que la bobine se décharge

Dans les deux cas le ssr gère l'inrush et l'interruption de courant, le changement d'étât du relais de direction se fait "à vide"

jayserf, 2019-07-31:
Are you guys having problems with relay life in your greenhouses?

Ours are still working super well, have not had to change one yet.

or is this for moving to solid state?

Sorry im late to the conversation , catching up now.

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

LoupHC, 2019-07-31:
Some had trouble with sparking in the direction relay... causing bad contact and motor opening instead of closing...
SSR would be a great solution to this issue... plus theres a chinese module with the same form factor than previous relays!

jayserf, 2019-08-01:
Got it. Thanks good for the ssr and keeps the design compatible with cheap
mechanical relays also.

Don't they need heatsink sometimes though? Or we're at too low current and
voltage?

C$ 7.91  5%OFF | SSR-40 DA-H DC-AC Solid State Relay SSR 40A 3-32V DC /
90-480V AC w Heat Sink
https://s.click.aliexpress.com/e/bkebzT3S

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

yoangp, 2019-08-01:
Ya, at low current, some ssr don‘t require heatsink.

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

LoupHC, 2019-08-01:
Under 5A they rarely need one

jayserf, 2019-08-04:
That's sweet! Good idea then, thanks

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

LoupHC, 2019-08-18:
Hey guys!
J'ai eu la possibilité de tester le nouveau circuit de driver de moteur ce matin! Ça marche au quart de tour!
Le condensateur prend environ 1 seconde à se charger et 1 seconde à se décharger, ce qui est en masse suffisant pour supprimer le problème de sparking.
Aussi les SSR sont plugs and play avec l'ancien driver de moteur (pour le relais on/off) ça peut donc être une solution partielle à ceux qui ont des problèmes de sparking...

Concernant ton inquiétude Yoan d'avoir une activation partielle vu que la led semblait s'allumer graduellement, j'ai testé ça à l'oscilloscope. Le ssr a probablement effectivement un mécanisme de déclanchement abrupte parceque ça semblait assez instantané, de l'ordre de quelques ms.

yoangp, 2019-08-19:
Cool! Maintenant ça serait un bon test de comparer ce setup avec le setup
de relais actuel via un cyclage automatique pour voir combien de cycles ça
peut marcher et convertir cela en années d’utilisation.. Apres l’expo-champ.

Yoan

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

LoupHC, 2019-08-19:
Nice!
Faudra juste se trouver une pesée de 100kg, après j'ai la poulie qui faut! :P

yoangp, 2019-08-19:
Allo Loup,

Est-ce que tu peux m’envoyer un petit plan de ton circuit de délai et aussi
le plan du circuit d’alarme aisni que les numéro de pièces de tout cela?

Je vais commencer à réviser le circuit..

Merci

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

jayserf, 2019-08-19:
You guys are MACHINES!

My question, if we add the delay circuit components and still use a
mechanical relay, does it reduce the sparking at all?

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

yoangp, 2019-08-20:
Hey Jason!

So the idea is for one motor we use one solid state relay (SSR) and one
mechanical relay. The delay circuit first close the mechanical relay,
without load (so no spark), and after the delay it activate the SSR. No
spark in the SSR under load.

Ciao!

Yoan

Le lun. 19 août 2019, à 18 h 36, jayserf <notifications@github.com> a
écrit :

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

yoangp, 2019-08-20:
Loup,

Ça me fait penser, il faut que le circuti de relai fonctionne pour
démarrage et arrêt. C'est à dire qu'il faut activer le SSR après le relai
mécanique pour le démarrage du moteur. Mais pour l'arrêt, il faut d'abord
désactiver le SSR, puis le relai mécanique.

Est-ce que le circuit de délai tient compte de cela?

Sinon, je sais que t'aime pas l'option software, mais j'ai pensé qu'il
pourrait y avoir une pin de l'arduino shorté à 5V et lorsque le code
détecte cela, il sait qu'il s'agit du circuit de l'Otomate V2 et alors il
introduit le délai software.

C'est quand même pas si grave de changer des relais sur l'Otomate V1 une
fois de temps en temps. En plus, c'est pas tout le monde qui aura
rapidement des problèmes, Jason par exemple n'a eu encore aucun problème de
relai et Reid m'a dit qu'en général il n'a pas trop de problèmes de ce côté
là non plus.

Le lun. 19 août 2019, à 21 h 08, Yoan Gardner Patry <yoangp@gmail.com> a
écrit :

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

jayserf, 2019-08-20:
OK I get it, so doing the modif to theboard and still using mechanical
donesnt change anything.

i know you explained it like 8 times sat...thanks

well I still maintain that the relays are so cheap and easy to find that
unless we do testing to show its a problem thats widespread its more effort
and cost than just having spare relays and changing them once a year like
batteries in a thermostat.

is it possible that with the new programming where only one rollup works at
a time, then problems are really minimized and it might be years before
some fail?
or does it really depend on meteorological conditions etc than it does on
load?

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

yoangp, 2019-08-20:
Hi jason, goos question, but one motor at a time doesn’t help with this
problem.

The problem with failing relay is mainly when it happen, you may have a big
problem if the roll up are stuck because of a failed relay when it’s
freezing outside or crazy hot inside. So a higher fiability is a big plus!

Ciao

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

Thread 101 (2019-07-29):

Proto V2.0 - Interférences mesure de courant (ASC723)

yoangp, 2019-07-29:
Tout ce qu'il y a à savoir d'après moi:
https://www.allegromicro.com/en/insights-and-innovations/technical-documents/hall-effect-sensor-ic-publications/managing-external-magnetic-field-interference-acs71x-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

Donc voici les 3 solutions que je vois:
1. On éloigne les ACS723 des relais
2. On trouve une façon de faire tenir le ACS723 verticalement pour réduire le flux magnétique des relais qui le traverse. (Possible mais trop cher il me semble: https://www.digikey.ca/product-detail/en/aries-electronics/08-810-90/A117-ND/106399)
3. On met un shield comme mentionné dans l'article ci-dessus. Sur Digikey ils sont des tapes qui peuvent faire un shield, mais j'ai pas encore trouvé un shield pour soic8.

LoupHC, 2019-08-09:
J'ai essayé de faire un shield maison avec des assiettes en allu... mais à date je suis pas convaincu...
J'ai aussi essayé l'inclinaison perpendiculaire, je pense que l'interférence de la bobine est juste trop forte pour tout ça, ce qui marche vraiment, c'est de déplacer les capteurs de courant, à au moins 5 cm.
Pas la solution la plus élégante, mais au moins la plus facile pour avoir à changer tout le routing du pcb, on pourrait mettre des sockets à l'autre extrémité du pcb, et les connecter au circuit de relais avec un flat cable comme ça :
https://www.digikey.ca/product-detail/en/samtec-inc/IDSS-16-D-05.00-G/SAM9041-ND/4386575
Faudrait juste faire les calculs pour voir combien de cable ça prend pour supporter le courant des moteurs (le ribbon cable en question c'est du awg28)

yoangp, 2019-08-09:
Allo Loup,

Alu ça marchera pas, il faut un matériau magnétique comme le fer qui va
dévier le magnétisme. J‘avais pensé à un tuyau de plomberie en acier coupé
en 2 sur la longueur qui couvre les 2 asc723 comme un tunnel.

Sinon, à voir si on déplace les asc723 plus loin sur le pcb, c‘est surement
faisable.

Pas sur pour le flat ribbon,  c‘est fait pour des signaux. Je pense que ça
en prendrait vraiment beaucoup en parallèle.

À plus,

Yoan

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

LoupHC, 2019-08-09:
Si on en utilise 3 en parallèle pour chaque input de moteur ( 3 in + 3 out) on pourrait théoriquement monter jusqu'à 4A en restant dans les specs du fil, on aurait besoin de 10 connecteurs par sonde de courant donc un connecteur de 2x10 pourrait faire l'affaire pour les deux sondes.
Mais bon, c'est à utiliser au pire des cas...
Je vais essayer avec un tuyau morceau de tuyau en fer!
http://www.mosaic-industries.com/embedded-systems/electronic-instrument-design-new-product-development/cables/ribbon-cable-current-rating

LoupHC, 2019-08-31:
Tout compte fait, j'ai trouvé que la solution la plus simple consistait à mettre une plate de métal 1-8 entre les relais et le reste du board. La lecture des sondes de courant passe de 0.2 à 0.05A quand le courant ne circule pas dans les moteurs mais que les relais à proximité sont allumés.

yoangp, 2019-09-02:
Bon à savoir! Ça fait un shielding suffisament efficace...

Ciao!

Yoan

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

Thread 102 (2019-07-30):

Proto V2.0 - LCD interférences

yoangp, 2019-07-30:
De https://community.particle.io/t/i2c-lcd-display-getting-corrupted-solved/9767/28:

À essayer:
-Voir s'il y a des pull-ups en parallèle (sur le circuit et back-pack du LCD), semble être le cas. Enlever les pull-ups du circuit sur SDA et SCL pour voir si ça aide.

-"I2C depends strongly on timing. So normaly, during a I2C communication every interrupt should be disabled / suppressed (including Serial Communication)"...

-"Add some 0.01uF and 100uF capacitors across the power supply leads to the display as close to the display as possible."

-"Make every wire as short as possible.", peut-être flt-ribbon du lcd de 2in plutot que 4in si possible à trouver.

-Update de librairie pour le LCD...

yoangp, 2019-07-30:
Allo, enlève les pull-up R8 et R10 sur le I2C, ça aide déjà beaucoup l'écran.

LoupHC, 2019-07-31:
Tu constates déjà une différence??

yoangp, 2019-07-31:
Oui!

Le mar. 30 juill. 2019, à 20 h 40, LoupHC <notifications@github.com> a
écrit :

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

LoupHC, 2019-07-31:
Quelle genre de différence?

jayserf, 2019-07-31:
That sucks...

there's always the 27,000 cables on digikey to choose from for shorter ones
though, 1 problem solved.

https://www.digikey.ca/products/en/cable-assemblies/rectangular-cable-assemblies/450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

yoangp, 2019-07-31:
Hello Jason,

No problem here, in fact it helps that I removed the pull-ups on the I2C data lines (R8 and R10) because there is already pull-ups on the LCD backpack I2C pcb. I believe it helps because voltage value for "0" is closer to 0V. No big change here on the Otomate PCB, just no R8 and R10 resistors installed or removed altogether from the next PCB design.

jayserf, 2019-08-01:
Ok cool that we're not having flickering screen issues. Tks

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

Thread 103 (2019-08-04):

Proto V2.0 - Modif rain software

yoangp, 2019-08-04:
Allo! :-)

Modification apportés au code pour que le rain bucket du Sparkfun fonctionne:

- Ajustement du paramètre de quantité de pluie pour le tipping bucket
Dans Grennhouse_3.sensors.h, modification de la quantité de pluie par tipping du bucket:
_#define Bucket_Size **0.2794** // bucket size to trigger tip count **(mm of rain)**_

- Modification de GetRain pour que l'activation rain = true et rain = false fonctione correctement (voir section RG11 en gras que j'ai utilisé pour le Sparkfun):
_void getRain(){
  //Normally open contact rain sensor
  if(greenhouse.rainSensor.value() == NO_CONTACT){
    if(digitalRead(RAIN_SWITCH) == LOW){
      rain = true;
    }
    else{
      rain = false;
    }
  }
  //Normally close contact rain sensor
  else if(greenhouse.rainSensor.value() == NC_CONTACT){
    if(digitalRead(RAIN_SWITCH) == HIGH){
      rain = true;
    }
    else{
      rain = false;
    }
  }
  **//RG11 - 0.01'' bucket rain sensor
  else if(greenhouse.rainSensor.value() == RG11_BUCKET){
    //bucket mode
    if(totalRainfall > rainSample + rainSetpoint){   //If rainfall increased
      if(rainSampleCounter < rainSampleDelay){   //If the time since the last tipping bucket is shorter that the max delay between two tipping of the bucket, then rain started
        rain = true;
        rainSample = totalRainfall;      //Ajust current rainfall total based on actual total rainfall
        rainSampleCounter = 0;           //Reset counter to time till next rainfall increase
      }
      else{
        rainSampleCounter = 0;            //Reset counter to time till next rainfall increase
        rainSample = totalRainfall;       //Ajust current rainfall total based on actual total rainfall
      }
    }
    else{                 //No new bucket tipping since last time GetRain looped
      if(rain = true){     //Rain already True
        if(rainSampleCounter > rainSampleDelay){   //If the time since the last tipping bucket is longer that the max delay between two tipping of the bucket, then rain stopped
          rain = false;
        }
      }
    }
  }**
}_

- Ajout de commentaires et valeurs utilisées pour mes tests:
_float rainSetpoint = 0.5; //Min mm of rain to decide that it's really raining
unsigned long rainSampleDelay = 10000; //Max delay between two rain bucket tipping that define that it's raining (normalement pour déclancher  à pluie modérée de 2.5mm/h : 720000 = 12minutes)_

- Ça prendrait aussi un paramètre sur l'interface pour ajuster ce paramètre quand il faut que la variable rain s'active en dixième de mm/hr. (ex sur l'affichage: "Min rain trigger: [2.5] mm/h")

LoupHC, 2019-08-04:
Normalement le compteur prend seulement le compte quand le signal de High à Low, donc un signal bloqué à low va seulement être compté comme un click.
Merci pour les commentaires! Je vais checker ça pour programmer le rain bucket dans l'interface

yoangp, 2019-08-04:
En fait, j'ai aussi oublié, si le code ou les paramètres sont
nécessairement défférents du RG11, est-ce que tu peux ajouter dans le menu
de config des capteurs météo : NC, NO, RG11 rain bucket* ou Sparkfun rain
bucket*.

Quand tu auras le temps...

Merci!

Le dim. 4 août 2019, à 17 h 06, LoupHC <notifications@github.com> a écrit :

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

Thread 104 (2019-08-04):

Expo-champs 2019 - setup de démo

yoangp, 2019-08-04:
Allo,

Loup, est-ce que tu peux voir s'il y aurait un morceau de plastique de serre chez croques saisons qu'on peut utiliser pour la mini-serre pour l'expo champ (et nos futurs tests après...)?

Je verrais une mini-serre en forme de prime à base triangulaire équilatéral, chaque côtés du triangle de 6pieds de long (pour utiliser les tiges de support à moteurs que j'ai déjà sans les modifier) et longueur de la mini-serre, genre 6 pieds aussi.

Donc, il faudrait un morceau de plastique rectangulaire de 13pied par 6 pieds et 2 petits morceaux en triangles pour fermer les bouts. Ça peut aussi être une bâche ou du plastiques d'ensillage.

Je pense que j'ai les planches 2x4 qu'on pourrait utiliser pour la structure.

LoupHC, 2019-08-05:
13'x6'!!!
Faut pas oublier que ça doit rentrer dans mon char hahah!
Sinon j'ai des retailles de galvanisé chez nous, au lieu de prendre le tiens on pourrait plutôt faire un mini bras articulé de rollup (genre 2 pieds de long, pour pas trop avoir ça dans les jambes à l'expo-champ).
Je me disais qu'on pourrait fixer ça après le board de démo, pour servir d'équerre au board en même temps, donc 3 pieds de long max.
C'est sûr que ça serait moins impressionnant comme installation mais... un peu moins intense à assembler et trimballer? :P
Je pense pouvoir piquer une retail de wirelock et le plastique pour l'installation!

yoangp, 2019-08-05:
Ok, à voir pour la grandeur. Je pensais à un montage facilement
montable/démontable avec quelques vis.

Liste de matériel:
-2x4 yoan
-Plastique de serre Loup
-Vis à bois Yoan
-Support à station météo Yoan
-2ieme prototype Yoan
-Station météo - Yoan/Loup
-Moteurs - Yoan
-Chaufrette - Yoan
-Ventilateur carré 120V - Loup? J'en ai un d'ordi 12V avec power supply...
mais c'est assez poche
-Power supply - Yoan/Loup
-Perceuse et mèches - Yoan
-Scie sauteuse - Yoan
-Ruban à mesuer - Yoan
-Kit de soudure & électronique - Yoan/Loup
-Capteurs temp/hum/lumière- Yoan/Loup
-Multimètre - Yoan/Loup

Le dim. 4 août 2019, à 20 h 39, LoupHC <notifications@github.com> a écrit :

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

Thread 105 (2019-08-07):

Futur..

yoangp, 2019-08-07:
Juste pour le fun:

https://youtu.be/WvOuL1qq4rU

Avantages:
-Pas de figuolage pour boutons, écrans, leds d'indication
-Interface moderne, facile à utiliser
-Accès web aux données de la serre
-Connecteurs pour io au dos du bidule
-Full rapide à programmer (sutout qu'on sait déjà ce qu'on veut que le code fasse)
-Possiblement pas plus cher que ce qu'on a déjà développé sur une technologie qui commence à être pas mal ancienne.

Désavantages:
-Plateforme pas open-source, mais possible de garder le concept de contrôleur de serre libre de droits. Après c'est transférable sur n'importe quelle plateforme.

Thread 106 (2019-08-09):

Proto V2.0 Capteur SHT10

yoangp, 2019-08-09:
Allo Loup,

Je viens de recevoir le capteur SHT10 que j'ai commandé sur Amazon. Hé ben, c'est exactement le même que celui que j'ai commandé d'Aliexpress, il vient assurément de la même compagnie chinoise. Dans tous les cas, j'ai encore le même problème, aucune communication.

Est-ce que tu pourrais regarder le tiens et le séparer à la base du capteur et me dire à quoi correspond les numéros de pins 1 à 4 (Vcc, GND, DATA, CLOCK). Peut-être que le code de couleur des cables n'est pas bon...
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

Aussi quand j'ouvre le capuchon métalique de mon capteur, je peux voir que les pins 1 et 2 sont du côté top layer du pcb du capeur, le côté sur lequel est soudé le capteur d'humidité. Mais je peux rien voir de plus car tout est dans un genre de rubber imperméable.

Merci!

LoupHC, 2019-08-13:
Peut-être que ça peut t'aider, j'en ai branché une tantôt et donc j'ai dû me demander quel fil va où...
Dans mon cas : rouge (5V) bleu (gnd) jaune et noir (clock/data me rappelle plus quel est quel)

Entre le 5v et le gnd, sur le pcb de la sonde, il y a un petit condo de filtrage. J'espère qu'il est pas complètement enfouie dans le coating dont tu parles.

yoangp, 2019-08-14:
Moi j'ai pas de fils rouge, j'ai un fils brun dans les 2 cas, mais mon fils brun est supposément le 5V.. Il y a peut-être juste de quoi pas correct dans mon code, on va voir cela en fin de semaine.

Thread 107 (2019-08-09):

Proto V2.0 - Wind

yoangp, 2019-08-09:
Allo!

J'ai testé le capteur de vent avec le kit sparkfun, ça marche :-) Woohoo!!

Il manque cependant quelque chose dans le code Loup. On peut mettre la vitesse du vent qui déclanche la fermeture des côtés ouvrants, mais il faut aussi mettre un délai avant la réouverture de la serre car lors d'une tempête de vent ça vient par bourasques.

Voici l'algorythme proposé:
-Dans le menu, après que l'usager à sélectionné la vitesse du vent maximale, il doit entré la durée du délai de réouverture.

Dans le code, il faut que ce délai corresponde à un countdown. À chaque fois que la vitesse du vent redépasse le seuil de fermeture défini pas l'usager, il faut que le countdown se reset.

Note sur le code:
Loup, est-ce que c'est ok pour toi si je te dis les ajouts de codes qu'il faut mettre pour l'instant vu que c'est toi le mastermind derrière tout cela, tu as une meilleure vue d'ensemble. Si tu préfères qu'on ajoute du code chacun de notre bord pour te sauver du travail, il faut s'entendre pour que le dernier code soit toujours à jour sur Google drive et qu'on s'avertisse par Hangout quand quelqu'un travailles sur le code.

Sinon, pour l'instant, voici ce que j'ai ajouté pour que je puisse utiliser mon anémomètre à switch (car le tiens était analogique):
Dans Greenhouse_3.sensors.h:

_#define switch_delay_to_wind_speed 2.4 // 2.4km/h = 1 trigger/second_
_volatile unsigned long contactTimeAne; // Timer to manage any contact bounce in interrupt routine for anemometer_
_elapsedMillis AneSampleCounter;    //Anemometer switch counter; elapsed time in millisecond since last trigger_

_// Interrupt handler routine that is triggered when the anemometer make one rotation
void isr_ane() {
  if((millis() - contactTimeAne) > 15 ) { // debounce of sensor signal
    windSpeed = switch_delay_to_wind_speed*1000/AneSampleCounter;
    if(windSpeed < 1){
      windSpeed = 0; //Avoid low speed when no wind, so if windspeed lower than 1km/h than reset to 0km/h
    }
    AneSampleCounter = 0;
    contactTimeAne = millis();
  }
}_

_void getWind(){
  //  Yoan commented analog anamometer
  //0-5V (0-30 m/s) analog wind sensor
//  int aRead = analogRead(WIND_ANALOG_SENSOR);
//  windSpeed = (float)108/(float)1023*(float)aRead; //108km/h = 30m/s
}_

Il faudrait aussi ajouter du code pour sélectionner l'anémomètre à switch ou analogique dans le menu.

yoangp, 2019-08-09:
By the way, ça prendrait aussi un raccourci dans le menu pour accéder à l'écran "Weather station", je pense qu'il y a juste via Config/sensors/weather/... qu'il est possible de voir cet écran. C'est bien cool de regarder ces données météo quand on pris dans la serre en pleine tempête!! :-)

yoangp, 2019-08-09:
Hey, je suis en pleine grosse tempête juste là là!! Plate que mes capteurs météo de l'Otomate soient dans la maison et pas dehors.. Bah, si le toit arrache, je vais pouvoir voir des données météo malade!!

LoupHC, 2019-08-10:
Hey malade! Nice job pour le programme d'interrupt avec l'anémomètre. Je vais pouvoir l'intégrer facilement.
On va aussi pouvoir le rendre compatible avec le capteur de Davis instruments avec ĉa!
Je pensais à ça justement, ajouter un délai avant la reconfirmation de la vitesse du vent. L'autre paramètre qu'on peut ajuster, c'est l'hystéresis avant de désactiver l'override de fermeture.
Mis tout ensemble ça ferait :
1. surveillance en temps réel de la vitesse du vent
2. Si la vitesse dépasse X km/h, on ferme et on part un timer
3. Toute les Y minutes, on vérifie si la vitesse du vent est passée en dessous de X km/h - hysteresis
pour savoir si on doit réouvrir, sinon, on reset le timer

LoupHC, 2019-08-10:
Je pense que c'est bon si tu me copy paste tes modifications, pour que je les assimile avant de les intégrer au code officiel.
C'est rendu tellement organique mon affaire... des fois je dois remonter 4 ou 5 pages de code pour dépister des bugs, c'est bon que je me tienne à jour! :)

yoangp, 2019-08-11:
Allo!

Je suis pas certain de comprendre à 100% l‘idée de l‘hytérésis. Il faudrait
pas que la serre s‘ouvre parce qu‘il y a eu une mini accalmie entre deux
bourasques dans une tempête de vent..
Est-ce que tu peux m‘expliquer ton idée plus en détails?

Yoan

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

LoupHC, 2019-08-12:
Exemple, s'il le setpoint de vent est à 70km/hm et que l'hysteresis est de 10, ça veut dire qu'il va pas ré-ouvrir avant que le vent redescende en bas de 60km/h.
Mais en y pensant bien, pas sûr que ça soit la meilleure solution. Faudrait plutôt se baser sur une moyenne des 10 dernières minutes mettons.

yoangp, 2019-08-12:
Par rapport à ton idée de moyenne, je dirais que c‘est les bourasques qui
peuvent arracher une serre. Mettons une tempête à 60km/h de moyenne sur
10min, mais avec des pointes à 90km/h, c‘est ça qui me ferait plus peur..
Mais l’idée d‘hystérésis pourrait être bonne afin d‘ouvrir la serre quand
la vitesse de vent a réellement baissé à un niveau acceptable. Je vote pour
cela.

Yoan

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

Thread 108 (2019-08-20):

PCB V2.1 - Espace

yoangp, 2019-08-20:
Allo,

Donc j'ai pensé au PCB seconde version. Voici les changements que je propose:

- On garde la même boîte et la même grosseur de PCB, on est capable ;-)
- On fait de l'espace entre les connecteurs pour les doigts.
- On met un connecteur barrel jack vertical et le circuit d'alarme dans le bas du circuit pour que la batterie soit simplement dans le fond de la boîte.
- On met le module RTC et SMD card vertical pour sauver de l'espace. (le module RTC toujours dans le bas de la boîte pour éviter les problèmes de batteries du module RTC qui coulent)
- On met des fusibles plus petits pour sauver de l'espace.
- On enlève les trous inutilisés autour de l'Arduino.
- On met les ACS723 en SMD.
- On ajoute un thermistor pour en avoir un par moteur.

à suivre

jayserf, 2019-08-20:
I know its a slippery slope, but surface mount Varistor and thermistor? I
didnt know they existed:

https://www.digikey.ca/products/en?keywords=VARISTOR%2047V%202KA%20

really easy to desolder guys! I promise

Is it bad to not remove the arduio pin expansion? I think its really useful
for the like 5 or 10 of us that would add other shit to the arduino...

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

yoangp, 2019-08-20:
Hi Jason,

I would say, for the ones who want to add extra stuff on the Arduino, they
can buy a shield. And seriously, who would develop other stuff from scratch
on the Arduino? Maybe Jenna, Loup, Reid, you and me. Who would do it, less
than that. And us 3 doesn’t count because we will built a new circuit
instead..

But I can try to leave a footprint for I2C and SPI communication.

Is that a good compromise? :-)

Ciao,

Yoan

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

LoupHC, 2019-08-20:
I actually need them for the wifi relay interface... i could select a few and tell you which tho... and we remove the extras.
Mais à part ce détail je suis 100% d'accord avec tes propositions Yoan! Bonne idée de mettre les modules à la verticale!

yoangp, 2019-08-20:
Ok super, tu me diras quels io garder accessibles pour ton module relay
wifi. :-)

Le mar. 20 août 2019, à 07 h 39, LoupHC <notifications@github.com> a écrit :

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

jayserf, 2019-08-20:
Hey Yoan.

Yeah agree with you on that one.

Not sure about upside-down shield use, might be complex but possible...

Ok for spi and i2c (I only need spi)

Thanks!

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

yoangp, 2019-08-27:
Ok! :-)

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

jayserf, 2019-08-27:
😎

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

Thread 109 (2019-09-08):

Datalogging

LoupHC, 2019-09-08:
Hey guys!
J'ai joué un peu avec le générateur de graphiques de google calc, c'est vraiment bien fait!
Regarder le beau graph que ça m'a fait avec interractions lumière/température intérieure/extérieure/consignes de température du contrôleur!!!
J'imagine qu'il serait facile de programmer un bouton "import" qui irait copier les données du fichier .txt que génère le arduino sur la carte sd pour automatiser un peu la patente?

Est-ce que t'as de l'expérience en scripts java Jason? Does it sound like an easy task?
Ou une super app génératrice de graphiques encore mieux à nous proposer?
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

Thread 110 (2019-09-22):

Température de backup

LoupHC, 2019-09-22:
J'ai eu une petite idée la semaine passé :
- les capteurs temp/hum SHT10 et DS18B20 sont bien mais ce sont des capteurs digitals, donc ils sont plus sensibles aux interférences electromagnétiques.
- dans un cas d'installation où le fil du sensor est trop proche d'une ligne 120vac ou d'un transfo, ça peut faire chier la lecture
- un capteur de température intérieure qui chie, ça peut avoir de graves conséquences...

Donc je me demandais si on pourrait pas rajouter un petit thermistor bien cheap, à l'extérieur du boitier, en backup de la sonde température/humidité intérieure, ces sensors la sont à peu près bullets proofs a cause de leur haute impedance...
Vous en pensez quoi?
