LoupHC/controleur-CAPE/KiCad Files/Controller_Schematics_pdf/CAPE_Controller_schield.pdf

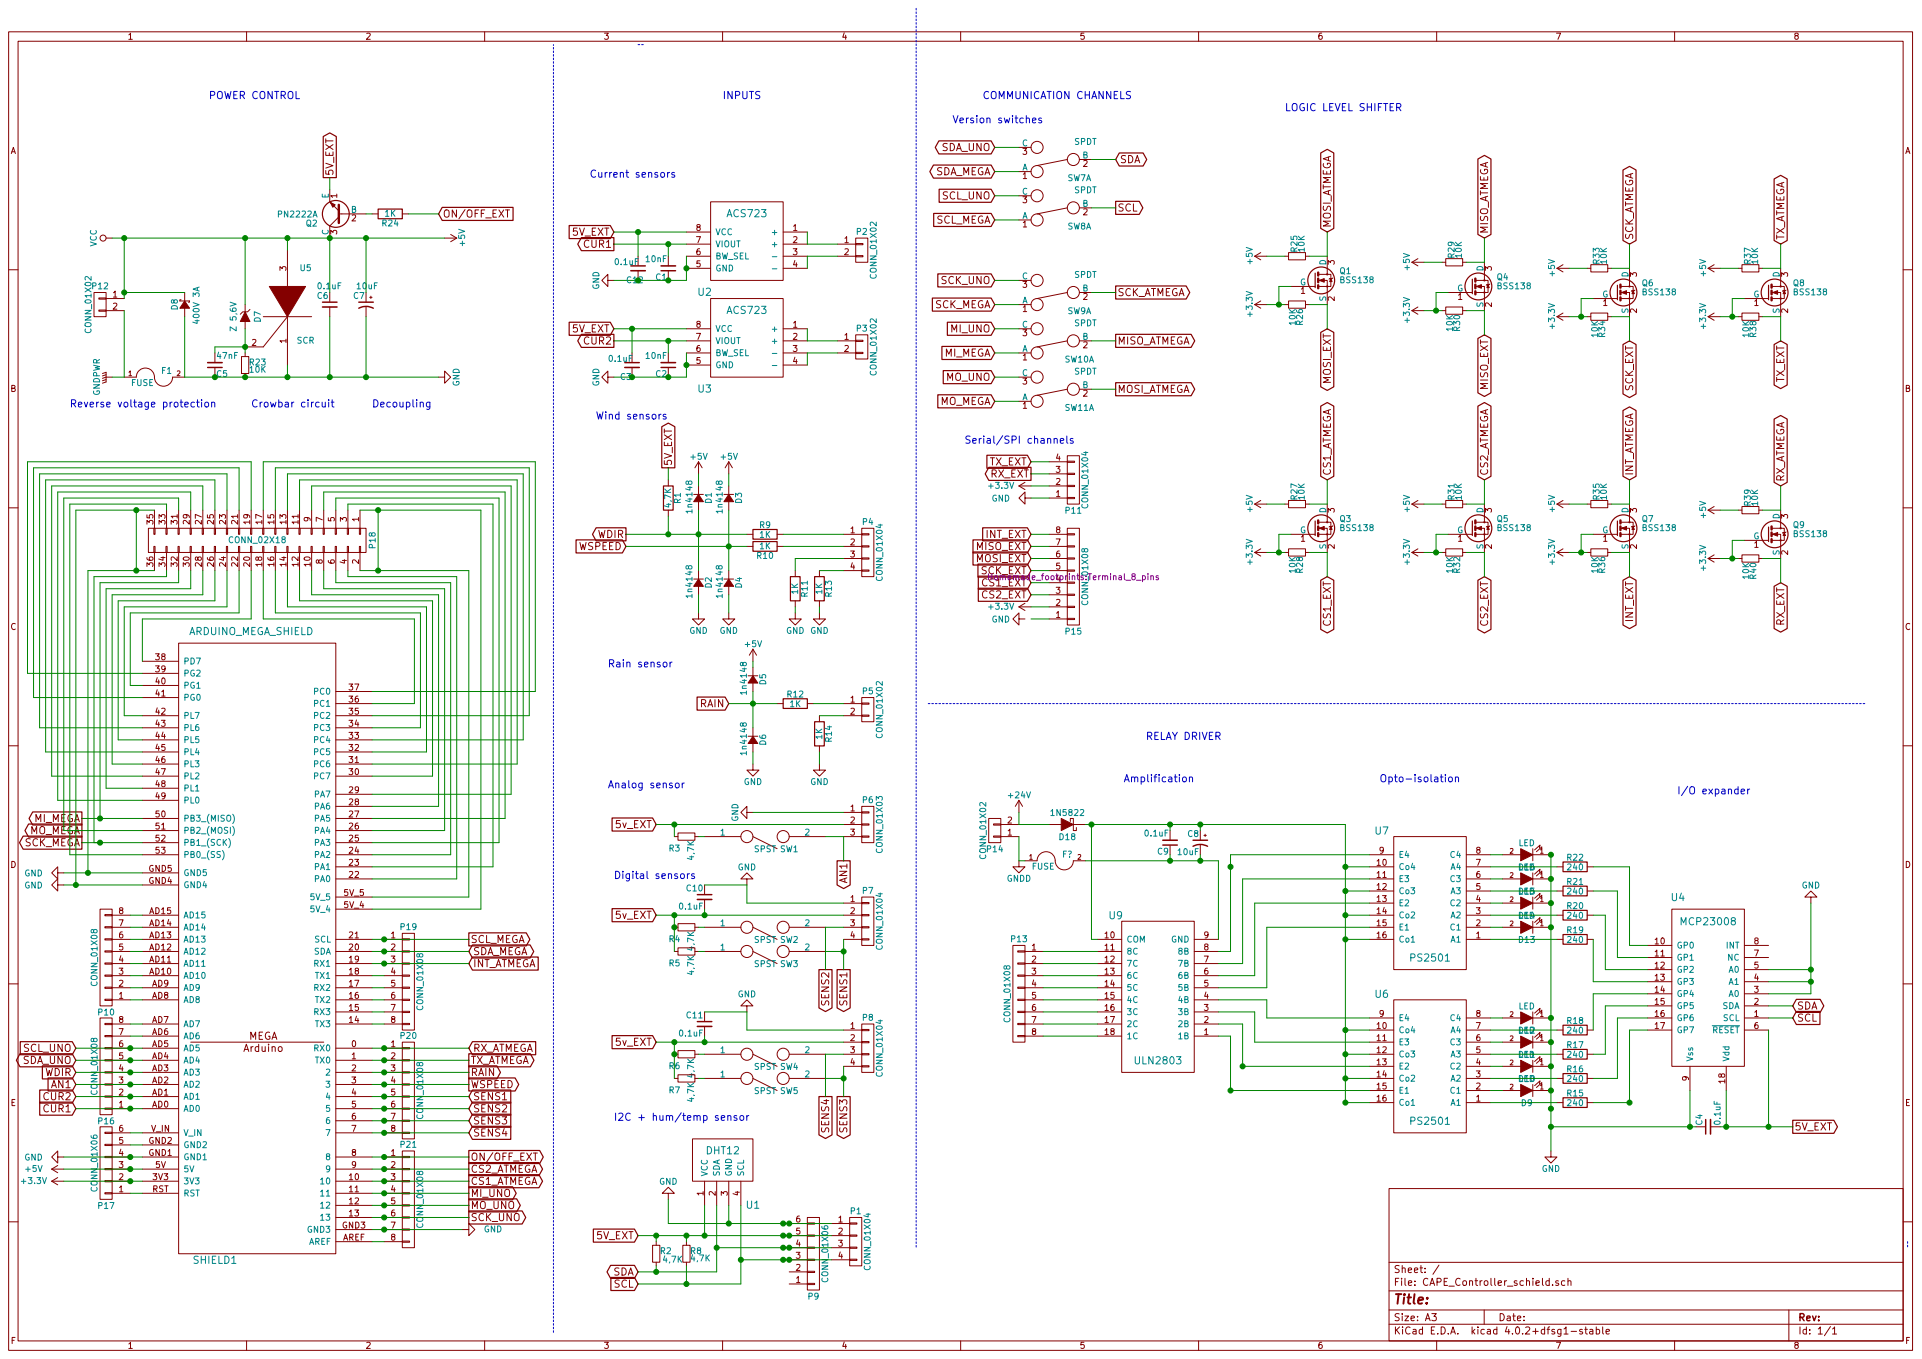
[picture p17: page 1]

Version switches Serial/SPI channels
SPDT A

Current sensors Wind sensors Rain sensor Analog sensor

2 3
3 4
4 5

6 7

5 | 4 P1 CONN_01X04 R2 2
