LoupHC/controleur-CAPE/Greenhouse_controller_CAPE_v1.1/Greenhouse_sensors.h

//Select your sensors

//Temperature sensor
#define TEMP_DS18B20
//#define TEMP_DHT22
//#define TEMP_DHT11
//#define TEMP_DHT12
//#define TEST_TEMP

float testTemp = 15.00;
float TEST_MAX = 30.00;
float TEST_MIN = 15.00;
float TEST_STEP = 0.02;
boolean rise = true;

//Humidity sensor
//#define HUM_DHT22
//#define HUM_DHT11
//#define HUM_DHT12

//Real time clock
#define CLOCK_DS3231
//#define TEST_CLOCKF
//#define TEST_CLOCKFF

int startMin = 0;
int startHour = 5;
int startDay = 1;
int startMonth = 1;
int startYear = 18;
int MINUT_JUMPS = 1;


//Temerature pin
#define TEMP_SENSOR          7 //connect this pin to the DS18B20 data line

#ifdef TEMP_DS18B20
  #include <OneWire.h>
  #include <DallasTemperature.h>
  //Create DS18B20 object
  OneWire oneWire(TEMP_SENSOR);
  DallasTemperature sensors(&oneWire);
#endif

#ifdef HUM_DHT11
  #include <DHT.h>
  //Create DHT object
  DHT dht(HUMIDITY_SENSOR, DHT11);
#endif

#ifdef HUM_DHT22
  #include <DHT.h>
  //Create DHT object
  DHT dht(HUMIDITY_SENSOR, DHT22);
#endif

#ifdef CLOCK_DS3231
  #include <DS3231.h>
  //Create a RTC object
  DS3231  rtc(SDA, SCL);                // Init the DS3231 using the hardware interface
  Time  t;
#endif

#include <DHT12.h>
  //Create DHT object
DHT12 DHT;


unsigned long counter = 1;


void testTime(){
    if(startMin > 59){
      startMin = 0;
      startHour++;
    }
    if(startHour > 23){
      startHour = 0;
      startDay++;
    }
    if(startDay > 30){
      startDay = 1;
      startMonth++;
    }
    if(startMonth > 12){
      startMonth = 1;
      startYear++;
    }
}

void getDateAndTime(){

  for(int x = 0; x < 6; x++){
    rightNow[x].setLimits(0,60);
  }

  #ifdef CLOCK_DS3231
    t = rtc.getTime();
    rightNow[5].setValue(t.year-2000);
    rightNow[4].setValue(t.mon);
    rightNow[3].setValue(t.date);
    rightNow[2].setValue(t.hour);
    rightNow[1].setValue(t.min);
    rightNow[0].setValue(t.sec);
  #endif
  #ifdef TEST_CLOCKF

    rightNow[0].setValue(0);
    rightNow[1].setValue(startMin);
    rightNow[2].setValue(startHour);
    rightNow[3].setValue(startDay);
    rightNow[4].setValue(startMonth);
    rightNow[5].setValue(startYear);

    startMin += MINUT_JUMPS;
    testTime();

  #endif
    #ifdef TEST_CLOCKFF

    rightNow[0].setValue(0);
    rightNow[1].setValue(startMin);
    rightNow[2].setValue(startHour);
    rightNow[3].setValue(startDay);
    rightNow[4].setValue(startMonth);
    rightNow[5].setValue(startYear);

    startDay++;
    testTime();
  #endif

  for(int x = 0; x < 6; x++){
    rightNowValue[x] = rightNow[x].value();
  }

  #ifdef DEBUG_CLOCK
  for(int x = 0; x < 6; x++){
    Serial.print(rightNow[x].value());
    Serial.print(":");
  }
  Serial.println("");
  #endif
}


void getGreenhouseTemp(){
  #ifdef TEMP_DS18B20
    sensors.requestTemperatures();
    float temp = sensors.getTempCByIndex(0);

    if((temp <= -127.00)||(temp >= 85.00)){
      EEPROM.update(1, 111);
      EEPROM.update(2, (byte)greenhouseTemperature.value());
      greenhouseTemperature.setValue(greenhouseTemperature.value());
      sensorFailure = true;
      #ifdef ALARM_PIN
        greenhouse.alarmBlast();
        delay(500);
        greenhouse.stopAlarm();
        delay(1000);
      #endif
      Serial.println("sensor fault");
    }
    else{
      greenhouseTemperature.setValue(temp);
      greenhouseTemperature.updateLastValue();
      sensorFailure = false;
    }
  #endif

  #ifdef TEMP_DHT12
    DHT.read();
    greenhouseTemperature.setValue(DHT.temperature);
  #endif

  
  #ifdef TEST_TEMP
    if(testTemp <= TEST_MIN){
      rise = true;
    }  
    if(testTemp >= TEST_MAX){
      rise = false;
    }
    if (rise == true){
      testTemp += TEST_STEP;
    }
    else{
      testTemp -= TEST_STEP;
    }
  greenhouseTemperature.setValue(testTemp); 
  #endif

}

void getGreenhouseHum(){
  greenhouseHumidity.setLimits(0, 100);

  #ifdef HUMIDIDTY_DHT
    greenhouseHumidity.setValue((float)dht.readHumidity());
  #endif
  #ifdef HUM_DHT12
    DHT.read();
    greenhouseHumidity.setValue(DHT.humidity);
  #endif
}
