LoupHC/controleur-CAPE/(commit log)

2018-01-09 Add files via upload
    12V enlevé du schéma
2018-01-25 Last version :gnd/power planes
2018-01-26 Add files via upload
    prototype fab files export from Kikad
2018-01-26 Add files via upload
    added bom
2018-04-05 add onboard test for relays
2018-04-05 add onboard check of I2C addresses
2018-04-05 specify SUN/CLOUD temperatures on parameter sheets
2018-04-05 fix display with I2C devices screen
    [Greenhouse_interface.h]
2018-04-13 Rename main folder to meet arduino IDE convention
2018-04-24 update 24-04-16 : features : - add alarm in case of sensor failure - temperature stays - emergency temperature in case sensor failure bugs fixed : - COMPUTER_INTERFACE not supposed to be default - ti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
    [Greenhouse_interface.h, Greenhouse_overrides.h, Greenhouse_parameters.h, Greenhouse_sensors.h, Preprocessor_error_codes.h]
2018-04-24 rename "prototype" for "controller"
2018-04-24 In case of sensor failure : record last received temperature as actual temperature
    [Greenhouse_controller_CAPE_v1.1.ino, Greenhouse_sensors.h]
2018-05-13 rename "librairies" folder to "librairie" to match arduino ide convention
2019-02-07 enable stage with same percentage
2019-02-14 test modules for rtc and temp sensor
2019-02-14 no blocking if two stages are equal
